Meckie-AI/meckie-bodies/bodies/comet/Comet Design Brief.dc.html

Design brief · Rev A 30 Sep 2026

# COMET-12

A compact, 3D-printable companion quadruped. Twelve Feetech serial-bus servos at 12 V, tuned for smooth, expressive motion, with wheel feet that let him skate-walk at human pace.

Est. mass

{{ totalStr }} g

{{ marginStr }}

Hip height

{{ hipH }} mm

thigh {{ thetaStr }}° from vertical

Segments

115 / 115

thigh / shin, mm

Top speed

1.4 m/s

skate-walk · knee servo {{ kneePeak }} N·m

01

## Concept views

Open full 3D viewer + GLB/OBJ export →

A torpedo body in cream PLA, seafoam fender pods over each shoulder, chrome bands hiding the shell seams, a red porthole face with a round display under twin brow lamps (camera and depth sensor), and an antenna with an orbit ring. All four legs run knees-back. Each view can be dragged to orbit.

Side

Front · face end

Top

3/4

Rear · USB-C below the tail light

Overall ≈ 360 L × 213 W × 330 H mm (to antenna) Hip spacing 223 mm Foot track 191 mm Shell Ø124 × 99 mm

02

## Leg · exploded

Front-right leg, exploded laterally

Joint

Drive side

Support side

{{ j.joint }}

{{ j.drive }}

{{ j.support }}

Knee linkage

The knee servo sits directly above the hip-pitch servo inside the bracket sleeve. An 18 mm crank drives an M3 pushrod to a 23 mm horn on the shin, a 1.28:1 reduction, so the STS3215 sees 22% less torque than the knee joint. Crank and horn are clocked at 152° so the rod meets both at about 82° when standing; across the working range (thigh ±20°, knee ±30°) the transmission angle stays above 35°. The four-bar couples thigh and knee angles; inverse kinematics compensates.

Wiring & strain relief

All three servos sit at or above the hip. The only cable below the hip is a 6-core flat cable for the wheel motor and encoder, clipped along the thigh, with a loop at the knee and strain relief at the foot cup. Each leg's chain enters its pod through a grommet on the abduction axis with a 30 mm service loop, a P-clip on the bracket, and a second clip at the chassis exit.

Lower-leg mass

Shin + horn 15 g · bumper/hub 9 g · N20 10 g · wheel 4 g · bearings 4.5 g · rod 5 g · cable 2 g
≈ 50 g below the knee

02b

## Gait modes · skate-walk

The legs always step. Above walking pace, each stance foot's wheel rolls forward while it's on the ground, so every step covers more distance at the same cadence. Body speed = leg contribution (up to ≈ 0.3 m/s) + wheel contribution. A foot about to land spins its wheel up to ground speed first, so touchdown is scuff-free.

Walk

Skate-walk · wheel share rises with speed

00.3 m/s0.71.01.4 m/s · adult walking pace

Walk0–0.3 m/s

Wheels held by the motors in position-hold, so it's a true walk. The default mode, and used on carpet, thresholds, near drop-offs, and whenever the front depth sensor sees clutter.

Skate-walk0.3–1.5 m/s

Trot cadence of about 1.4 Hz, with lower 15 mm foot lift. At 1.4 m/s, wheels supply about 80% of the speed. Wide arcs only: wheel skid plus abduction steering.

Glidepose

Legs still in a crouched "surfing" stance while he rolls. Used for short flourishes and greetings, not for getting around.

Control split

Pi: gait planner, mode blend, IK at 100 Hz, streamed to the ESP32. ESP32-S3: servo bus, wheel speed loops at 1 kHz, touchdown spin-up, drop-off and obstacle reflexes, heartbeat watchdog.

03

## Body layout

X-ray: shell and pods at 13% opacity

Bus & power topology

USB-C PD · tail → STUSB4500 + BQ25798 charger → Smart pack 3S · MAX17320 → Main switch · 10 A fuse → Power board → 5 V / 5 A buck → Pi + display

V+ front · 7.5 A

FL · ID 1 abd · 2 pitch · 3 knee→ FR · ID 4 · 5 · 6 V+ break

V+ rear · 7.5 A

RL · ID 7 · 8 · 9→ RR · ID 10 · 11 · 12

Data + GND

ESP32-S3 N16R8UART1 → Serial bus adapter→ one half-duplex line, continuous through all 12 servos

Pi peripherals

CSI · camera I²C · IMU + pack gauge + charger I²S · speaker amp + 2 mics SPI · display UART · ESP32-S3 link (joint targets 100 Hz)

ESP32 peripherals

2 × DRV8833 → 4 N20 + encoders I²C · VL53L8CX forward lidar + 4 × VL53L1X drop-off GPIO · servo eFuses 5 V rail load ≈ 1.3 A typical, 2.1 A peak

{{ b.t }}

{{ b.d }}

03b

## Wiring diagram

VBAT5 VServo busESP32 I/OPi I/OUART link

Per the shared core, the ESP32-S3 is the reflex brain: it owns the servo bus, wheels, every ranging sensor and the servo power. The Pi plans the gait and solves IK, then streams joint targets to the ESP32 at 100 Hz. The servo bus moved off the Pi so the ESP32 can still run the safety routine if the Pi stops.

04

## Joint load check

All 12 joints run STS3215 (12 V, ≈ 2.9 N·m stall). Continuous budget is taken as 0.9 N·m at the servo. Static moments are at {{ totalStr }} g with the foot under the hip and a knee moment arm of {{ armStr }} mm (115 · sin {{ thetaStr }}°); knee servo torque is divided by the 1.28:1 linkage. Hip pitch assumes the foot 30 mm off-center mid-stride; abduction uses the 43.5 mm lateral offset from axis to foot. Trot peak applies a {{ dynStr }}× dynamic factor on two-foot support, which assumes the smooth, eased gait this robot is tuned for.

Case

Knee joint

Knee servo

Hip pitch

Abduction

{{ r.c }}

{{ r.k }}

{{ r.ks }}

{{ r.h }}

{{ r.a }}

N·m · servo continuous budget ≈ 0.9 · STS3215 12 V stall ≈ 2.9 · red = over budget

05

## Parts list & mass budget

{{ c.name }} · {{ c.g }} g Bar = 1,750 g target · printed masses from the STL volumes

Part

Group

Qty

Each g

Line g

Running

{{ p.n }}

{{ p.name }}

{{ p.cat }}

{{ p.qty }}

{{ p.unit }}

{{ p.sub }}

{{ p.run }}

Total vs 1,750 g target

{{ totalStr }} g · {{ marginStr }}

Moving all 12 joints to STS3215 saves 156 g. Wheel feet and the ESP32-S3 add 89 g. That makes room for the 2200 mAh pack as standard, which wheels and the higher skate-walk speed put to use. The earlier weight trims stay in: 2-wall shell, pocketed chassis, 35% bracket infill, 26 AWG harness, nylon shell fasteners. Printed masses assume the settings in section 06.

05b

## BOM cost

Single unit · retail estimates, USD · Oct 2026

{{ c.name }} · ${{ c.sum }} · {{ c.share }}

Item

Group

Qty

Each

Line

{{ p.name }}

{{ p.cat }}

{{ p.qty }}

${{ p.unit }}

${{ p.line }}

Total · single unit

${{ costTotal }} · range {{ costRange }}

Where to save

{{ s.t }}{{ s.v }}

At 10 units

$500–550 / unit

Servo bulk pricing, a shared PCB assembly run, and filament bought by the spool.

Prices are typical single-quantity retail and have not been checked against current listings; confirm them before ordering. Excludes tools, shipping, import duties and printer time. The custom power board assumes five assembled boards from a standard PCB fab.

05c

## Assembly · no glue

Every joint snaps or screws · fully reversible with a 2.5 mm hex and a 1.5 mm hex

Joint

Method

Detail

{{ a.j }}

{{ a.m }}

{{ a.d }}

Snap features are sized for PLA: 1.2 mm cantilever thickness, 0.6 mm hook depth, 30° lead-in, 45° release face so they can be unsnapped with a fingernail or spudger. Screws into plastic always land in a heat-set insert, never a printed thread, so parts survive repeated servicing. Threadlocker is optional on metal-to-metal threads only (servo horns, grub screws); use a removable grade.

06

## Print orientation

{{ q.part }}

{{ q.mat }}

{{ q.how }}

{{ q.settings }}

07

## Safety reflex · settles into a low crouch

{{ s.t }}{{ s.h }}{{ s.d }}

Triggers

No Central heartbeat for 500 ms (relayed by the Pi) · no Pi link for 200 ms · pack below 15% or 10.5 V · any servo at 70 °C or above · eFuse fault.

Always-on local reflexes

Edge: any drop-off ToF sees the floor fall away → wheels brake and the gait stops; it steps back only on command. Obstacle: forward lidar under 150 mm → wheels brake, walk speed capped. Fall: tilt past 40° → all servos to 10% torque.

Rest pose

Low crouch: thighs 20° further back, knees folded to keep the feet under the hips, body about 50 mm lower. Holds at 25% servo torque. If power is cut it settles onto its belly.

Resume

Stands up only on a fresh command from Central. Restoring the heartbeat alone does not wake it.

08

## Hangar Bay manifest

Peripheral

Host

Bus

Addr / ID

Pins

{{ m.dev }}

{{ m.host }}

{{ m.bus }}

{{ m.addr }}

{{ m.pins }}

hangar_bay/comet.yaml

{{ yaml }}

Verify before CAD freeze

- STS3215 spline position along the 45.2 mm side is not published; measure it and shim each servo so the spline lands on its axis before closing the sleeves.
- Collision sweep of the printed parts covers abduction ±12°, thigh ±20° and knee ±30° from stance. Rear legs: thigh and knee bent the same way together beyond about 40° is unreachable for the rod; keep the gait inside that.
- Set each pushrod to length (front 149.5 mm, rear 129.2 mm centre to centre) and trim knee zero with the turnbuckle.
- Servo masses with horns removed; the 74.5 g / 55 g figures may already include the stock horn.
- Four-bar transmission angle across the full knee range; keep it above 35° at deepest crouch.
- Pod louver area against knee-servo case temperature after 10 minutes of continuous trotting.
- Charger heat in the tail at 25 W: give the BQ25798 a copper pour to the rear bulkhead, and derate to 1.5 A if the board passes 70 °C.
- USB-C PD compatibility across phone, laptop and GaN chargers, plus the 5 V fallback path.
- STS3215 12 V datasheet figures (speed, stall, continuous rating) and thermal behaviour in the knee position during long skate-walks.
- Mic noise floor while walking and skate-walking, and whether servo whine and speaker echo need a mechanical fix or software is enough.
- Wheel touchdown matching: measure the speed mismatch at foot contact, aiming for under 5% at 1.4 m/s.
- Front ToF cover window: use IR-transparent material with an air gap or gasket, and check for crosstalk against the camera lens ring.
- Drop-off ToF aim against the front-foot swing envelope, so a lifted foot never reads as a cliff.
