Meckie-AI/meckie-bodies/bodies/biped-mini/Biped Mini Design Brief.dc.html

Design brief · Rev A 2 Oct 2026 Meckie shared core

# BIPED MINI.

A small two-legged walking Meckie body. Personality: an earnest little guy who waddles, dances, and waves (kids will love it).

Est. mass

{{ totalStr }} g

limit 1,300 g

Envelope

284 H

mm · 136 W across arms · feet 92 long

Servos

{{ servoCount }}

{{ cfgShort }}

Worst knee / ankle

{{ kneeWorst }} / {{ ankleWorst }}

N·m · budget 0.9 hold, 1.47 peak

Est. BOM

${{ costTotal }}

target under $350 · see 05b

Runtime

≈ {{ runStr }} h

walking · 3S {{ packStr }} mAh

Key finding · leg joints

Without an ankle roll joint, the flat feet cannot stay flat while it shifts its weight onto one leg.

To lift a foot, the centre of mass has to move about {{ shiftNeed }} mm sideways over the other foot. With the specified joints (hip yaw, roll, pitch, knee, ankle pitch) the only ways to do that are tilting both legs about {{ tiltNeed }}°, which tips each foot onto its outer edge, or rolling the body about 35°. This brief therefore defaults to hip roll, hip pitch, knee, ankle pitch and ankle roll per leg. To keep it near 280 mm and under 1.3 kg the two roll joints use the smaller STS3032 (6 V, on its own bus) and the pitch joints keep the STS3215. The ankle roll keeps the soles flat during the waddle. Turning in place becomes a toe-heel shuffle instead of a hip twist. Switch Leg joints in Tweaks to see the as-specified version and its check results.

01

## Concept views

Open full 3D viewer + GLB/OBJ export →

A round body, cream on top and sea foam below, with a red TPU belt bumper and a chrome band. The face sits in a chrome porthole with brass rivets on the chest. A small cream helmet head carries the camera under a sea-foam brim. Short stub arms end in red TPU mitts. The legs are cream thighs and sea-foam shins with chrome-painted brackets at every joint, and red braided harness clipped down the back. The feet are wide and flat with red soles. A sea-foam tail skid behind the hips, with a red TPU shoe, is what it sits back on. Each view can be dragged to orbit.

3/4 · {{ poseLabel }}

Side · crouched stance, tail skid

Front · face, lidar, front drop ToF

Top · foot footprint

Rear · speaker grille, USB-C, brass toggle, tail skid, rear drop ToF

Thigh 58 · shin 56 · ankle axis 44 above floor · hip roll 26 above hip pitch Hip pitch axes 76 apart · feet 92 × 60 Torso 100 × 124 × 90 · head 48 × 64 Seated height ≈ 200

02

## Legs · exploded

Legs and hip brackets outward, feet down, torso halves and head apart, skid back

Joint · IDs L / R

Drive side

Support side

{{ j.joint }}

{{ j.drive }}

{{ j.support }}

Servo as structure

Every servo sits in a PLA sleeve and is shimmed so its spline lands on the joint axis, then a cap closes the sleeve. The hip bracket holds the hip-pitch servo, the thigh holds the knee servo, and the ankle bracket holds the ankle-pitch servo lying flat; the shin is two PLA plates and a tie bar. Every pitch joint is driven by a metal horn on the outboard side and carried by a 685ZZ on an M5 shoulder bolt on the inboard side; the roll joints use a 683ZZ on an M3 shoulder screw.

Feet

92 × 60 mm PLA plates with a 4 mm red TPU sole, set 12 mm toe-forward of the ankle axis. The two soles sit 16 mm apart, so the standing support area is 92 × 136 mm. A chrome toe cap protects the front edge.

Tail skid

A PLA tail skid curves down from the back of the pelvis to a red TPU shoe 88 mm below the hip-pitch axis, behind the legs. To sit it bends the hips 66°, the knees 100° and the ankles 15°; the body tips back about 19° and the shoe lands on the floor 37 mm behind the heels, so it rests on two feet and the skid. The rear drop-off ToF sits on the skid.

02b

## Behaviour modes

A static, crouched gait: the centre of mass is always over a foot, so it can stop mid-step and stay put. Slow on purpose, which reads as earnest and keeps it safe around small children.

{{ m.n }}{{ m.q }}

{{ m.d }}

Control split

Central: where to go, who is there, which dance, what to say. Pi: face render, camera and mic streams, voice bearing, speech playback. ESP32-S3: gait generator and leg IK at 100 Hz, IMU balance trim, foot-contact check from servo load, lidar and drop-off reflexes, heartbeat watchdog, power and thermal guard.

03

## Body layout

X-ray: torso, head, pods and leg covers at 13% opacity

Bus & power topology

USB-C PD · rear→ PD sink · 15 V→ BQ25798 · 3S charger↔ 3S {{ packStr }} smart pack · pelvis→ Brass toggle · 10 A fuse

VBAT 10.5–12.6 V

eFuse · EN 14 (12 V) · 6 V buck + eFuse EN 47→ Two bus adapters (UART1 12 V, UART2 6 V)→ 12 V bus: STS3215 ID 2–4 / 7–9 6 V bus (own buck + adapter, UART2): STS3032 ID 1, 5 / 6, 10 Arms ID 11–12 (upgrade)

Reflex brain

ESP32-S3 N16R8 UART1 · servo bus 1 Mbps I²C0 · BNO085, VL53L8CX, 2 × VL53L0X, BQ25798 I²C1 · pack gauge SMBus

Face brain

Pi Zero 2 W · chest CSI · camera (60 mm FFC to head) SPI0 · display I²S · 2 mics in head + amp UART · ESP32-S3 link 921 600

Leg harness

12 V · GND · bus3-wire servo chain per leg in red braid, service loop at every joint

{{ b.t }}

{{ b.d }}

03b

## Wiring diagram

VBAT / 12 V 5 V 12 V servo bus 6 V servo bus (STS3032) I²C SPI / CSI / I²S UART link Wi-Fi

04

## Joint torque & stability check

STS3215 at 12 V: about 2.94 N·m stall. Budget for holding is 0.9 N·m (about 30% of stall, the level it can sustain without overheating); budget for short dynamic moves is 1.47 N·m (50%). Robot {{ totalStr }} g. Mass above the stance knee {{ mKneeStr }} g, above the ankle {{ mAnkleStr }} g. Thigh 58 mm, shin 56 mm. The roll rows use the STS3032 budget instead: about 0.44 N·m stall at 6 V, so 0.13 N·m hold and 0.22 N·m peak. Dynamic rows add 30% for acceleration and gear backlash.

Case

Joint

Need

Budget

Result

{{ r.c }}

{{ r.j }}

{{ r.t }}

{{ r.b }}

{{ r.p }}

Stability & sensing

Need

Have

Result

{{ r.c }}

{{ r.need }}

{{ r.have }}

{{ r.res }}

Knee and ankle pitch are the critical joints. The worst knee case is rising from the skid with the knees at 100°; the worst ankle case is single support with the centre of mass pushed 30 mm toward the toe. Both stay inside the 1.47 N·m dynamic budget at the planned mass, and every holding case stays under 0.9 N·m. Tinted rows are knee and ankle pitch.

05

## Parts list & mass budget

{{ c.name }} · {{ c.g }} g Bar = {{ totalStr }} g of 1,300 g

Part

Group

Qty

Each g

Line g

Running

{{ p.n }}

{{ p.name }}

{{ p.cat }}

{{ p.qty }}

{{ p.unit }}

{{ p.sub }}

{{ p.run }}

Total

{{ totalStr }} g · {{ massNote }}

The ten leg servos are 46% of the robot. The arm upgrade adds two more servos and pushes it to about 1.33 kg, past the 1.3 kg limit, unless the covers are thinned; the 1500 mAh pack alone still fits.

05b

## BOM cost

Single unit · retail estimates, USD · Oct 2026

Over target. The spec build comes to ${{ costTotal }} against $350. The six STS3215s are ${{ servoCost }} and the four STS3032s about $88. The savings list gets to about ${{ liteTotal }}, still over target; the STS3032 roll servos and their 6 V bus are the price of staying near 280 mm and under 1.3 kg.

{{ c.name }} · ${{ c.sum }} · {{ c.share }}

Item

Group

Qty

Each

Line

Running

{{ p.name }}

{{ p.cat }}

{{ p.qty }}

${{ p.unit }}

${{ p.line }}

${{ p.run }}

Total · single unit

${{ costTotal }} · range {{ costRange }}

Where to save

{{ s.t }}{{ s.v }}

All of the above≈ ${{ liteTotal }}

Prices are typical single-quantity retail and have not been checked against current listings; confirm them before ordering. Excludes the USB-C PD charger, tools, shipping and printer time.

05c

## Assembly · no glue

Every joint screws or snaps · fully reversible with a 2.5 mm and a 2 mm hex

Joint

Method

Detail

{{ a.j }}

{{ a.m }}

{{ a.d }}

No glue, tape, epoxy or adhesive cable mounts anywhere. Bearings sit in seats retained by shoulder bolts. Screws into plastic always land in a heat-set insert. No visible fastener heads: horn screws hide under chrome horn caps, idler bolts under brass caps, shell screws under the belt bumper and inside the pack bay.

06

## Print orientation

{{ q.part }}

{{ q.mat }}

{{ q.how }}

{{ q.settings }}

Every part fits a 220 × 220 bed; the largest are the two torso halves (116 mm across). No painting or finishing anywhere: the silver and brass parts print in metallic-filled PLA. A full set prints on three plates: PLA brackets, PLA shells and covers, TPU soles and bumpers.

06b

## Why these materials

Two filaments, and one of them only where flex is the point. The constraint that decided this was not strength: it was that a stock printer with no modifications should be able to make every rigid part on this body. PLA needs no hardened nozzle, no dry box, no enclosure and no 260 °C hotend, which is the difference between a pack most people can print and a pack most people can only read.

PLA

89% of the printed pieces

Everything rigid: shells, structure, brackets, bezels. Stiff, dimensionally accurate, prints unsupported on more surfaces than anything else, and stocked in every colour this body names.

TPU 95A

11% of the printed pieces

Only where compliance is the function and a rigid part would not work at all: belt bumper, mitt, skid shoe, sole. Nothing here is TPU for toughness alone.

What PLA costs you

Snap hooks are the weak point. The snap features on this body were drawn to stay under 2.5% strain, which suits PETG. PLA's safe cantilever strain is nearer 1.5%, so the hooks are working harder than the geometry assumed. Print them with the layer lines running across the hook rather than along it, open the shell gently, and treat a hook as a part you may have to reprint. Nothing in this pack has been test-printed, so this is the first place to look for trouble and the most useful thing you can report back.

Heat. PLA's glass transition is about 55 to 60 °C, and this body's servos do not warn until 65 °C. Indoors that gap never opens: the shell sits near room temperature and the servos are the only thing that gets hot. Left in a closed car in summer, or on a sill in direct sun, the shell can soften while the electronics still consider themselves fine. That is a storage rule, not a design flaw, and it is the main thing PETG would buy back.

Heat-set inserts. Every screw lands in a brass insert, and PLA's window is narrower than PETG's: run the iron cooler, around 180 to 200 °C, go in slowly, and let the boss cool before loading it. Rushing one slumps the wall around it.

If you want the margin back: the geometry does not change. Print the shells in PETG and the load-bearing structure in CF-nylon and every part still fits, because that was the original specification and the only thing that changed is which spool is on the shelf. The cost is a hardened nozzle, a dry box, and a printer that holds 260 °C. If you have that printer, the tougher parts are yours for a filament swap.

07

## Safety reflex · crouches and sits on the tail skid

{{ s.t }} {{ s.h }} {{ s.d }}

Triggers

No Central heartbeat for 500 ms · pack below 15% or 10.5 V · any servo at 70 °C or above · eFuse fault · servo load spike on a non-stance leg (something caught).

Always-on local reflexes

Edge: a drop ToF sees the floor fall away → finish the step backward and stop. Obstacle: lidar under 120 mm ahead → stop. Fall: torso tilt past 35° outside the gait envelope → all servos to 10% torque so the gears survive the landing.

Rest pose

Hips 66°, knees 100°, ankles 15°, body tipped back about 19°, sitting on two feet and the tail skid. Stable with servos at 20% torque or fully off.

Resume

Stands up only on a fresh command from Central. Restoring the heartbeat alone does not wake it.

08

## Hangar Bay manifest

Peripheral

Host

Bus

Addr / ID

Pins

{{ m.dev }}

{{ m.host }}

{{ m.bus }}

{{ m.addr }}

{{ m.pins }}

hangar_bay/biped_mini.yaml

{{ yaml }}

Verify before CAD freeze

- Sign off the leg joints: ankle roll instead of hip yaw (recommended), or keep hip yaw and accept tilted feet, or go to 12 servos (+$40, about +130 g, over 1.3 kg).
- STS3032 spline position along its 23.2 mm side is not published; every STS3032 pocket has 3 mm of shim room. Measure and shim before final assembly.
- Roll torque margins are thin: the STS3032 ankle roll runs at about 55% of its short-term budget in single support. Keep the CoM within 8 mm of the stance foot centre line in the gait planner.
- Collision sweep of the printed parts: hip roll ±12°, hip pitch −90° to +15°, knee 0–120°, ankle pitch ±20° (±30° once the knee is bent past 40°), ankle roll ±12°. Back-swing is limited to 15° by the tail skid.
- Toe-heel shuffle turning on carpet and wood; measure degrees per step.
- STS3215 backlash at the ankle (about 0.5°) magnified over the 114 mm leg; check the stance foot stays planted and does not chatter.
- Thermal: knees and ankles during a 10 min dance at 12 V. Trip is 70 °C.
- Sit-to-stand from the skid on a slippery floor: the feet must not skate forward as the knees extend.
- Drop-off ToFs move with the torso pitch during the gait; correct from the IMU and test at stair tops.
- Camera FFC from chest to head is short and fixed, but route it clear of the arm-upgrade servos.
- Kid safety: pinch points behind the knees at full fold. Add TPU knee guards or limit the fold when a child is detected nearby.
