Meckie-AI/meckie-bodies/bodies/dial/Dial Design Brief.dc.html

Design brief · Rev B · portable TV 2 Oct 2026 Meckie shared core

# DIAL.

A shelf- or desk-mounted Meckie body with a pan/tilt head and no locomotion. Personality: a little 1950s portable TV who turns to look at whoever is talking.

Est. mass

{{ totalStr }} g

{{ discStr }} mm steel ballast

Envelope

170 × 146 × 205

mm W × D × H · tilt axis at 130

Axes

2 × STS3215

pan ±150° · tilt −30 / +40°

Push to tip

{{ tipStr }} N

at screen top · BOM ${{ costTotal }}

01

## Concept views

Open full 3D viewer + GLB/OBJ export →

The head is a 1950s portable television. A cream two-piece cabinet with a chrome seam band and a tapered tube-bell back carries a rectangular 2.8" IPS screen in a chrome surround, set off-centre. The eyes are drawn on the screen. A sea-foam knob column on the right holds two brass knobs and the speaker slots; a chrome carry handle finishes the top, with the camera in a chrome pod above the screen. The cabinet tilts in a brushed-aluminium-finish yoke on a two-tier sea-foam and cream swivel base with a red TPU foot. The neck harness runs up the back of the yoke in red braid. Each view can be dragged to orbit.

3/4 · {{ poseLabel }}

Side · tube-bell back, battery hatch on right flank

Front · ToF behind red bezel

Top

Rear · vents, USB-C, brass main toggle, harness

Overall 170 W × 146 D × 205 H mm (to handle) Cabinet 140 W × 100 H × 76 D, + 24 tube bell Screen 2.8" · surround 74 × 58, centre 16 mm right of axis Swivel base Ø146 × 48 Shelf-clamp variant fits 12–30 mm shelves

02

## Pan/tilt neck · exploded

Full stack, exploded vertically; head shells split fore/aft

Joint

Drive side

Support side

{{ j.joint }}

{{ j.drive }}

{{ j.support }}

Servo placement

The pan servo stands upright at the pedestal centre and only supplies rotation; the 6810 bearing under the turntable carries all tipping load. The tilt servo rides inside the cabinet behind the knob column, output spline on the tilt axis, bolted through a metal horn to the left yoke arm. The cabinet pivots about its own servo, so the yoke stays a thin, clean U. The screen sits right of centre, so the CoM is about 6 mm toward the right arm; that loads the 685ZZ side slightly more but adds nothing to tilt torque.

Harness & strain relief

Six conductors leave the electronics tray, wind 1.25 turns around a printed cable clock screwed under the turntable, around the pan horn,, rise through the 6810 bore and exit at the rear of the turntable. From there the braid runs exposed up the back of the yoke in two brass P-clips and enters the head through a rear grommet with a 20 mm drip loop for tilt. Pan is soft-limited to ±150° so the clock never winds tight.

Head mass on the tilt axis

Cabinet shells, bell + band 89 g · screen surround 6 g · chassis 24 g · tilt servo 55 g · Pi 14 g · 2.8" LCD, camera, mics 25 g · Ø40 speaker + amp 14 g · knobs, panel, handle 18 g · wiring + fasteners 12 g
≈ {{ headMass }} g, CoM placed on the axis

02b

## Gaze modes · look-at

Dial turns toward whoever is talking. The two mics give a coarse bearing to the voice, the pan servo swings the head there, then the camera takes over and centres the face. Eyes lead the motion on the display by about 120 ms, so the glance reads as intent instead of a mechanical swivel.

Doze

Conversation · face tracking

Look up

−30° tilt−20°0°+25°+40°

Attentivetilt 0°

Default idle. Slow scanning saccades every 4–8 s within ±40° pan; small head bobs on speech onsets. The ToF keeps watch for someone approaching.

Curioustilt +15°

Chin up toward a standing speaker, with a fast glance: up to 400°/s pan for the first 60% of the move, then eased in so the camera settles before tracking.

Sleepy resttilt −25°

Chin tucked, eyes half closed, torque at 20%. Used for the safety reflex, night mode and charging. Leaves only on a fresh command from Central.

Control split

Central: who is talking, attention, behaviour. Pi: face render, voice bearing, face centring at 30 Hz. ESP32-S3: servo trajectories at 200 Hz, limits, heartbeat watchdog, power and thermal guard.

03

## Body layout

X-ray: shells and pedestal at 13% opacity

Bus & power topology

USB-C PD · rear→ PD sink 15 V + BQ25798→ Smart pack 3S 1500 · gauge→ Brass main toggle · 10 A fuse→ 5 V / 5 A buck → ESP32, Pi, amp, display

12 V servo · 3 A

eFuse · EN GPIO12→ Bus adapter→ ID 1 pan→ neck harness → ID 2 tilt

Reflex brain

ESP32-S3 N16R8 UART1 · servo bus 1 Mbps I²C · ToF + charger · SMBus · pack gauge Wi-Fi · Central heartbeat 10 Hz

Face brain · head

Pi Zero 2 W SPI · display CSI · camera I²S · 2 mics + amp UART · ESP32-S3 link 921 600 5 V rail ≈ 0.9 A typical, 1.6 A peak

Neck harness

12 V · GND · bus data · 5 V · TX · RX22 AWG power, 28 AWG signal, JST-GH 6p at the head

{{ b.t }}

{{ b.d }}

03b

## Wiring diagram

12 V / VBAT 5 V Servo bus I²C / SMBus I²S UART / GPIO Wi-Fi

04

## Joint load & stability check

Both joints run STS3215 (12 V, ≈ 2.9 N·m stall), with the continuous budget taken as 0.9 N·m. Head mass is {{ headMass }} g with its CoM {{ comStr }} mm off the tilt axis. Tilt inertia uses the 100 × 100 mm cabinet section; pan uses 100 × 140 plus the yoke. Fast glance is 15 rad/s² (≈ 860°/s²). Tipping assumes a horizontal push at screen-top height (160 mm) about the foot edge (r 73 mm).

Case

Joint

Servo N·m

Budget used

{{ r.c }}

{{ r.j }}

{{ r.t }}

{{ r.p }}

Push to tip at screen top

{{ tipStr }} N · {{ totalStr }} g total · {{ tipNote }}

Torque is not the constraint on this body: both servos run far inside budget, which keeps them quiet and cool on a desk. Stability is. The steel disc sets how hard a hand or cat can bump the head before Dial tips; the shelf-clamp variant removes the question. Torque rows in red would exceed the 0.9 N·m budget.

05

## Parts list & mass budget

{{ c.name }} · {{ c.g }} g Bar = {{ totalStr }} g total

Part

Group

Qty

Each g

Line g

Running

{{ p.n }}

{{ p.name }}

{{ p.cat }}

{{ p.qty }}

{{ p.unit }}

{{ p.sub }}

{{ p.run }}

Total

{{ totalStr }} g

Ballast is about a third of the mass on purpose: the Ø130 disc sits 6–10 mm off the desk under the battery and tray, keeping the CoM low under a cabinet that is wider than the base. Keeping the Pi in the cabinet adds 14 g to the tilt axis but removes the camera ribbon and SPI run from the neck. The pack is 1500 mAh because Dial lives on USB-C; the pack rides through unplugging and moving rooms. Printed masses assume the settings in section 06.

05b

## BOM cost

Single unit · retail estimates, USD · Oct 2026

{{ c.name }} · ${{ c.sum }} · {{ c.share }}

Item

Group

Qty

Each

Line

Running

{{ p.name }}

{{ p.cat }}

{{ p.qty }}

${{ p.unit }}

${{ p.line }}

${{ p.run }}

Total · single unit

${{ costTotal }} · range {{ costRange }}

Where to save

{{ s.t }}{{ s.v }}

Prices are typical single-quantity retail and have not been checked against current listings; confirm them before ordering. Excludes tools, shipping, import duties and printer time. Shelf-clamp rows appear only when the clamp variant is switched on.

05c

## Assembly · no glue

Every joint snaps or screws · fully reversible with a 2.5 mm and a 2 mm hex

Joint

Method

Detail

{{ a.j }}

{{ a.m }}

{{ a.d }}

Snap features are sized for PLA: 1.2 mm cantilever thickness, 0.6 mm hook depth, 30° lead-in, 45° release face so they can be unsnapped with a spudger. Screws into plastic always land in a heat-set insert, never a printed thread. No visible fastener heads: every screw sits under the knob panel, the handle bosses, the seam band, the TPU foot or inside the battery bay. Threadlocker is optional on metal-to-metal threads only (servo horns, shoulder bolt); use a removable grade.

06

## Print orientation

{{ q.part }}

{{ q.mat }}

{{ q.how }}

{{ q.settings }}

All parts fit a 220 × 220 bed; the Ø144 base pan and the 152 × 112 cabinet front shell are the largest. No painting or finishing anywhere: the silver and brass parts print in metallic-filled PLA.

06b

## Why these materials

Two filaments, and one of them only where flex is the point. The constraint that decided this was not strength: it was that a stock printer with no modifications should be able to make every rigid part on this body. PLA needs no hardened nozzle, no dry box, no enclosure and no 260 °C hotend, which is the difference between a pack most people can print and a pack most people can only read.

PLA

89% of the printed pieces

Everything rigid: shells, structure, brackets, bezels. Stiff, dimensionally accurate, prints unsupported on more surfaces than anything else, and stocked in every colour this body names.

TPU 95A

11% of the printed pieces

Only where compliance is the function and a rigid part would not work at all: battery strap, foot, lcd retainer (clamps the module), neck harness grommet. Nothing here is TPU for toughness alone.

What PLA costs you

Snap hooks are the weak point. The snap features on this body were drawn to stay under 2.5% strain, which suits PETG. PLA's safe cantilever strain is nearer 1.5%, so the hooks are working harder than the geometry assumed. Print them with the layer lines running across the hook rather than along it, open the shell gently, and treat a hook as a part you may have to reprint. Nothing in this pack has been test-printed, so this is the first place to look for trouble and the most useful thing you can report back.

Heat. PLA's glass transition is about 55 to 60 °C, and this body's servos do not warn until 65 °C. Indoors that gap never opens: the shell sits near room temperature and the servos are the only thing that gets hot. Left in a closed car in summer, or on a sill in direct sun, the shell can soften while the electronics still consider themselves fine. That is a storage rule, not a design flaw, and it is the main thing PETG would buy back.

Heat-set inserts. Every screw lands in a brass insert, and PLA's window is narrower than PETG's: run the iron cooler, around 180 to 200 °C, go in slowly, and let the boss cool before loading it. Rushing one slumps the wall around it.

If you want the margin back: the geometry does not change. Print the shells in PETG and the load-bearing structure in CF-nylon and every part still fits, because that was the original specification and the only thing that changed is which spool is on the shelf. The cost is a hardened nozzle, a dry box, and a printer that holds 260 °C. If you have that printer, the tougher parts are yours for a filament swap.

07

## Safety reflex · the TV dozes off

{{ s.t }} {{ s.h }} {{ s.d }}

Triggers

No Central heartbeat for 500 ms · pack below 15% SoC or 10.5 V · any servo at 70 °C or above · eFuse fault.

Rest pose

Pan 0°, tilt −25°. With torque at 20% the head settles chin-down against the printed −30° soft stop, so it cannot drop further.

Resume

Stands back up only on a fresh command from Central. Restoring the heartbeat alone does not wake it.

08

## Hangar Bay manifest

Peripheral

Host

Bus

Addr / ID

Pins

{{ m.dev }}

{{ m.host }}

{{ m.bus }}

{{ m.addr }}

{{ m.pins }}

hangar_bay/dial.yaml

body: dial
doctrine: thin-client
central: { link: wifi, heartbeat_hz: 10, timeout_ms: 500 }
mcu:
  reflex: { chip: esp32s3, module: N16R8, reserved_gpio: [26-37] }
  face:   { chip: rpi_zero_2w, os: bookworm-lite, location: head }
buses:
  servo_bus: { host: reflex, uart: 1, tx: 17, rx: 18, baud: 1000000, half_duplex: true }
  i2c0:      { host: reflex, sda: 8,  scl: 9,  hz: 400000 }
  i2c1_smb:  { host: reflex, sda: 10, scl: 11, hz: 100000 }
  link:      { reflex: { uart: 2, tx: 15, rx: 16 }, face: { uart: 0, tx: 14, rx: 15 }, baud: 921600 }
  spi0:      { host: face, mosi: 10, sclk: 11, cs: 8, hz: 62500000 }
  i2s:       { host: face, bclk: 18, lrclk: 19, din: 20, dout: 21, rate: 48000 }
  csi:       { host: face, port: cam0 }
servos:
  - { id: 1, name: pan,  model: sts3215, center: 2048, min: 341,  max: 3755, rest: 2048 }
  - { id: 2, name: tilt, model: sts3215, center: 2048, min: 1707, max: 2503, rest: 1764 }
servo_limits: { temp_warn_c: 65, temp_trip_c: 70, rest_torque_pct: 20, slow_dps: 30 }
peripherals:
  - { name: tof_front,  part: vl53l8cx,  bus: i2c0, addr: 0x29, lpn: 4, int: 5 }
  - { name: charger,    part: bq25798,   bus: i2c0, addr: 0x6B, int: 6, ce: 7 }
  - { name: gauge,      part: sbs_pack,  bus: i2c1_smb, addr: 0x0B }
  - { name: servo_pwr,  part: efuse,     en: 12, fault: 13 }
  - { name: face_wake,  gpio: 14, to: face.gpio3 }
  - { name: status_led, part: ws2812,    gpio: 48 }
  - { name: display,    part: st7789v,   bus: spi0, dc: 25, rst: 24, bl_pwm: 13, size: 320x240, rotation: 90 }
  - { name: mics,       part: ics43434,  bus: i2s, count: 2, sel: [gnd, 3v3], spacing_mm: 92 }
  - { name: speaker_amp, part: max98357a, bus: i2s, sd: 16 }
  - { name: camera,     part: imx708,    bus: csi }
safety:
  triggers: [heartbeat_lost, soc_below_15, vbat_below_10v5, servo_overtemp, efuse_fault]
  routine:  [stop, brake, wait_2s, slow_to_rest, torque_low, face_sleepy]
  resume:   fresh_command_only

Verify before CAD freeze

- STS3215 body and spline position against the Feetech drawing; the tilt spline must land on the head's CoM within ±3 mm.
- 6810 bearing fit in a PLA seat versus a PLA insert ring; check for creep after a week of continuous scanning.
- Cable clock fatigue: 50,000 cycles of ±150° pan on the 6-core harness and the 28 AWG signal pairs.
- Pack fit: 3S 1500 in the right-flank bay with the hatch closed; measure the actual cell block before printing the base pan.
- Pi Zero 2 W temperature inside the sealed head while streaming camera and mics; vent area may need to grow.
- Mic noise from the tilt servo and Ø40 speaker inside the cabinet; add a printed TPU gasket under the mic clamp plates if needed.
- Voice-bearing accuracy with 92 mm mic spacing (asymmetric about the pan axis; calibrate the offset); target ±15° so the pan move lands close enough for face tracking.
- ToF window: IR-transparent material with an air gap, and its view clear of the yoke at extreme pan.
- USB-C PD compatibility across phone, laptop and GaN chargers, plus the 5 V fallback path.
- Shelf clamp grip on painted and laminate shelves at a 10 N push at screen-top height.
- 2.8" LCD viewing angle when Dial looks down at a seated user; IPS needed, not TN. Check backlight bleed at the surround edges.
- Cabinet tilt clearance: bottom edge sweeps to 14.5 mm above the yoke base at −30° and +40°; confirm with the real servo horn stack.
