Meckie-AI/meckie-bodies/bodies/inchworm/Inchworm Design Brief.dc.html

Design brief · Rev A 2 Oct 2026 Meckie shared core

# INCHWORM.

A desk-mounted serpentine arm creature. Personality: a weird, endearing curious critter that curls up, stretches, and peeks at you.

Est. mass

{{ totalStr }} g

arm {{ armStr }} g · head {{ headStr }} g

Reach

300 mm

J1 axis → face · base Ø184

J1 / J2 at full reach

{{ t1Str }} / {{ t2Str }}

N·m holding · budget 0.9

Tip margin

{{ marginStr }} mm

fully extended · {{ discStr }} mm steel disc

Est. BOM

${{ costTotal }}

target ≈ $200 · see 05b

Power

USB-C PD

15 V · 45 W wall charger · no battery

01

## Concept views

Open full 3D viewer + GLB/OBJ export →

A retro space caterpillar on a low cream dome. Four plump oval segments alternate sea foam and cream, each with two translucent ribs that glow from LEDs inside, a pair of red TPU prolegs on the belly, and chrome joint rings between them. The red braided harness runs up the back of every segment under brass clips. The head is wider than the body, like a caterpillar's: a cream dome with a sea-foam band, the face in a chrome bezel with a red TPU ring, a small chrome camera hood above it, and two antennae with glowing tips. A glow ring circles the top of the base. Each view can be dragged to orbit.

3/4 · {{ poseLabel }}

Side · spine harness

Front · face, antennae, chin lidar, grille

Top

Rear · USB-C, brass toggle, braided spine run

Links 70 · 65 · 60 · 60 · head 45 Segments 48 × 54 oval, chrome-painted joint brackets Head 60 × 62 · J1 axis 78 above desk Resting height ≈ 115 · peeking ≈ 370

02

## Joint chain · exploded

Joints spaced along the chain, shells lifted off, base parts down

Joint · ID

Drive side

Support side

{{ j.joint }}

{{ j.drive }}

{{ j.support }}

Alternating axes

J1, J3 and J5 bend in one plane; J2 and J4 bend at right angles to it. Together they let the body curve in any direction, tilt its head sideways and bow down to rest. There is no base turntable, so turning to face you is done by bending the two side joints.

Light at the tip

The head carries only a XIAO ESP32-S3 Sense (camera, face, two mics), the round display and a tiny forward lidar: about {{ headStr }} g. Everything heavy that does not have to move lives in the base, and the J1 servo sits inside the base rather than on the arm.

Spine harness

Seven conductors run the whole length in red braid on the back of each segment: 12 V, GND and servo data for the bus, 5 V, TX and RX for the head, and one data line for the glow LEDs. Each joint has a service loop on the outside of the bend, under a brass clip.

02b

## Behaviour modes

{{ m.n }}{{ m.q }}

{{ m.d }}

Control split

Central: who is there, where to look, behaviour, speech. XIAO (head): camera and mic streams over Wi-Fi, face render, chin lidar. Pi Zero 2 W (base): speech and sound playback, longer motion clips. ESP32-S3 (base): 5-joint IK and trajectories at 100 Hz, joint limits and self-collision, contact detection from servo load, heartbeat watchdog, power guard.

03

## Body layout

X-ray: base, segments and head at 13% opacity

Bus & power topology

USB-C PD · rear · 45 W charger→ PD sink · 15 V→ Brass toggle · 5 A fuse→ 12 V / 5 A buck · servos 5 V / 5 A buck · logic, head, glow LEDs

12 V servo bus

eFuse · EN 14→ Bus adapter→ J1 (base)→ spine → J2 → J3 → J4 → J5

Reflex brain · base

ESP32-S3 N16R8 UART1 · servo bus 1 Mbps UART2 · head link via spine UART0 · Pi link ADC · VIN sense RMT GPIO38 · 66 glow LEDs

Audio · base

Pi Zero 2 W I²S → MAX98357A → Ø28 speaker

Head brain · tip

XIAO ESP32-S3 Sense Onboard camera · Wi-Fi to Central SPI · GC9A01 I²S · 2 mics I²C · VL53L1X chin lidar

Spine harness

12 V · GND · bus · 5 V · TX · RX · LED7c silicone, 24/28 AWG, red braid on the back of every segment

{{ b.t }}

{{ b.d }}

03b

## Wiring diagram

15 V / 12 V 5 V Servo bus I²S / SPI / I²C Head UART Pi UART Wi-Fi

04

## Joint torque & tip check

Full extension means the whole chain held straight and horizontal, 300 mm out. Each moving servo module (STS3215, metal horn, bearing) is {{ msStr }} g at its joint; each segment shell, bracket and harness run is {{ mlStr }} g at mid-link; the head is {{ headStr }} g with its centre 28 mm past J5. STS3215 at 12 V: about 2.94 N·m stall. Holding budget 0.9 N·m, short dynamic budget 1.47 N·m. Dynamic rows add a 6 rad/s² dart, the speed of a quick peek.

Case

Joint

Need

Budget

Result

{{ r.c }}

{{ r.j }}

{{ r.t }}

{{ r.b }}

{{ r.p }}

Tip check · full reach

CoM {{ comXStr }} mm out · base edge 90 mm · margin {{ marginStr }} mm · holds {{ payloadStr }} g extra at the face before tipping

J1 is the critical joint: holding the chain straight out uses about {{ t1PctStr }} of its holding budget, so it can do it for a peek but should not idle there. Behaviours keep the default stance in an S-curve, which drops J1 to about {{ tPeekStr }} N·m. J2 is worst when its bend plane is vertical, which only happens when J1 is upright and J2 lays the arm out sideways. Tinted rows are J1 and J2.

05

## Parts list & mass budget

{{ c.name }} · {{ c.g }} g Bar = {{ totalStr }} g total

Part

Group

Qty

Each g

Line g

Running

{{ p.n }}

{{ p.name }}

{{ p.cat }}

{{ p.qty }}

{{ p.unit }}

{{ p.sub }}

{{ p.run }}

Total

{{ totalStr }} g

The steel disc is over half the robot: a 300 mm arm needs a heavy base. Every gram at the head costs about 3.3 g of ballast to keep the same tip margin, which is why the head carries only the parts that have to look and listen.

05b

## BOM cost

Single unit · retail estimates, USD · Oct 2026

{{ costHead }} {{ costBody }}

{{ c.name }} · ${{ c.sum }} · {{ c.share }}

Item

Group

Qty

Each

Line

Running

{{ p.name }}

{{ p.cat }}

{{ p.qty }}

${{ p.unit }}

${{ p.line }}

${{ p.run }}

Total · single unit

${{ costTotal }} · range {{ costRange }}

Where to save

{{ s.t }}{{ s.v }}

All of the above≈ ${{ liteTotal }}

Prices are typical single-quantity retail and have not been checked against current listings; confirm them before ordering. Excludes the USB-C charger, tools, shipping and printer time.

05c

## Assembly · no glue

Every joint screws or snaps · fully reversible with a 2.5 mm and a 2 mm hex

Joint

Method

Detail

{{ a.j }}

{{ a.m }}

{{ a.d }}

No glue, tape, epoxy or adhesive cable mounts anywhere. Bearings sit in seats retained by shoulder bolts. Screws into plastic always land in a heat-set insert. No visible fastener heads: horn screws hide under chrome caps, idler bolts under brass caps, shell screws inside the segments and under the TPU foot.

06

## Print orientation

{{ q.part }}

{{ q.mat }}

{{ q.how }}

{{ q.settings }}

Every part fits a 220 × 220 bed; the Ø184 base dome is the largest. No painting or finishing anywhere: the silver and brass parts print in metallic-filled PLA.

06b

## Why these materials

Two filaments, and one of them only where flex is the point. The constraint that decided this was not strength: it was that a stock printer with no modifications should be able to make every rigid part on this body. PLA needs no hardened nozzle, no dry box, no enclosure and no 260 °C hotend, which is the difference between a pack most people can print and a pack most people can only read.

PLA

82% of the printed pieces

Everything rigid: shells, structure, brackets, bezels. Stiff, dimensionally accurate, prints unsupported on more surfaces than anything else, and stocked in every colour this body names.

TPU 95A

18% of the printed pieces

Only where compliance is the function and a rigid part would not work at all: foot, proleg nub. Nothing here is TPU for toughness alone.

What PLA costs you

Snap hooks are the weak point. The snap features on this body were drawn to stay under 2.5% strain, which suits PETG. PLA's safe cantilever strain is nearer 1.5%, so the hooks are working harder than the geometry assumed. Print them with the layer lines running across the hook rather than along it, open the shell gently, and treat a hook as a part you may have to reprint. Nothing in this pack has been test-printed, so this is the first place to look for trouble and the most useful thing you can report back.

Heat. PLA's glass transition is about 55 to 60 °C, and this body's servos do not warn until 65 °C. Indoors that gap never opens: the shell sits near room temperature and the servos are the only thing that gets hot. Left in a closed car in summer, or on a sill in direct sun, the shell can soften while the electronics still consider themselves fine. That is a storage rule, not a design flaw, and it is the main thing PETG would buy back.

Heat-set inserts. Every screw lands in a brass insert, and PLA's window is narrower than PETG's: run the iron cooler, around 180 to 200 °C, go in slowly, and let the boss cool before loading it. Rushing one slumps the wall around it.

If you want the margin back: the geometry does not change. Print the shells in PETG and the load-bearing structure in CF-nylon and every part still fits, because that was the original specification and the only thing that changed is which spool is on the shelf. The cost is a hardened nozzle, a dry box, and a printer that holds 260 °C. If you have that printer, the tougher parts are yours for a filament swap.

07

## Safety reflex · bows down to rest

{{ s.t }} {{ s.h }} {{ s.d }}

Triggers

No Central heartbeat for 500 ms · any servo at 70 °C or above · input below 13 V (charger sagging or unplugged) · eFuse fault · contact: servo load spike or position error over 6°.

Always-on local reflexes

Chin lidar under 60 mm (a face or hand right there) → stop and back off 20 mm. Contact → stop and drop to 30% torque so it yields when touched.

Rest pose

J1 85°, J2 0°, J3 −35°, J4 0°, J5 −30°: it bows forward off the dome and rests its chin on the desk, about 115 mm high. Found by a collision check of the printed parts; stable with torque off.

Power loss

No battery by design. If the plug is pulled while it is stretched out, the chain sags under its own weight onto the desk; prolegs, ribs and the face ring are TPU-padded. Behaviours keep it in low S-curves most of the time.

08

## Hangar Bay manifest

Peripheral

Host

Bus

Addr / ID

Pins

{{ m.dev }}

{{ m.host }}

{{ m.bus }}

{{ m.addr }}

{{ m.pins }}

hangar_bay/inchworm.yaml

body: inchworm
doctrine: thin-client
central: { link: wifi, heartbeat_hz: 10, timeout_ms: 500 }
mcu:
  reflex: { chip: esp32s3, module: N16R8, location: base, role: [ik, servo_bus, power, safety] }
  audio:  { chip: rpi_zero_2w, os: bookworm-lite, location: base, role: [speech, motion_clips] }
  head:   { chip: esp32s3, module: xiao_esp32s3_sense, location: head, role: [camera, face, mics, lidar] }
power:  { source: usb_c_pd, request_v: 15, min_v: 13.0, battery: none }
links:
  head: { reflex: { uart: 2, tx: 15, rx: 16 }, head: { tx: 43, rx: 44 }, baud: 921600, via: spine_harness }
  pi:   { reflex: { uart: 0, tx: 43, rx: 44 }, pi: { uart: 0, tx: 14, rx: 15 }, baud: 921600 }
buses:
  servo_bus: { host: reflex, uart: 1, tx: 17, rx: 18, baud: 1000000, half_duplex: true }
  head_spi:  { host: head, sclk: 7, mosi: 9, hz: 40000000 }
  head_i2s:  { host: head, bclk: 3, ws: 4, din: 5, rate: 16000 }
  head_i2c:  { host: head, sda: 6, scl: 2, hz: 400000 }
  pi_i2s:    { host: audio, bclk: 18, lrclk: 19, dout: 21, rate: 48000 }
kinematics:
  chain: [ { id: 1, axis: pitch, link_mm: 70 }, { id: 2, axis: yaw, link_mm: 65 }, { id: 3, axis: pitch, link_mm: 60 },
           { id: 4, axis: yaw, link_mm: 60 }, { id: 5, axis: pitch, link_mm: 45 } ]
  base_h_mm: 78
  ik_hz: 100
servos:
  - { id: 1, name: j1_pitch, model: sts3215, min_deg: -45, max_deg: 90, rest_deg: 85 }
  - { id: 2, name: j2_yaw,   model: sts3215, min_deg: -85, max_deg: 30, rest_deg: 0 }
  - { id: 3, name: j3_pitch, model: sts3215, min_deg: -85, max_deg: 35, rest_deg: -35 }
  - { id: 4, name: j4_yaw,   model: sts3215, min_deg: -80, max_deg: 30, rest_deg: 0 }
  - { id: 5, name: j5_pitch, model: sts3215, min_deg: -85, max_deg: 30, rest_deg: -30 }
servo_limits: { temp_warn_c: 65, temp_trip_c: 70, rest_torque_pct: 20, contact_torque_pct: 30, contact_err_deg: 6, j1_hold_max_s: 20 }
peripherals:
  - { name: servo_pwr,  part: efuse, en: 14, fault: 21 }
  - { name: pd_good,    gpio: 6 }
  - { name: vin_sense,  adc_gpio: 1, divider: 100k_10k }
  - { name: status_led, part: ws2812, gpio: 48 }
  - { name: glow,       part: sk6812_2020, gpio: 38, count: 66, map: { seg1: 0-11, seg2: 12-23, seg3: 24-35, seg4: 36-47, antennae: 48-49, base_ring: 50-65 }, max_brightness_pct: 40 }
  - { name: display,    part: gc9a01, host: head, bus: head_spi, dc: 8, rst: 1, bl: tied_on, cs: tied_low, size: 240x240 }
  - { name: mics,       part: ics43434, host: head, bus: head_i2s, count: 2, sel: [gnd, 3v3] }
  - { name: lidar_fwd,  part: vl53l1x, host: head, bus: head_i2c, addr: 0x29, location: chin }
  - { name: camera,     part: ov3660, host: head, bus: onboard_dvp, stream: mjpeg_wifi, res: 800x600, fps: 15 }
  - { name: speaker_amp, part: max98357a, host: audio, bus: pi_i2s, sd: 16 }
sensing_rule: { drives: false, forward_lidar: lidar_fwd, drop_off: not_applicable_fixed_base }
reflexes:
  near:    { sensor: lidar_fwd, stop_mm: 60, action: [stop, back_off_20mm] }
  contact: { sensors: servo_load, action: [stop, torque_30] }
safety:
  triggers: [heartbeat_lost, servo_overtemp, vin_below_13v, efuse_fault, contact]
  routine:  [stop, brake, wait_2s, bow_to_rest, torque_low, face_sleepy]
  resume:   fresh_command_only

Verify before CAD freeze

- J1 thermal: hold the chain straight out for 20 s and for 60 s; set the firmware hold limit from the result.
- Joint ranges from a collision sweep of the printed parts: J1 −50° to 95°, J2–J5 about −85° to 35° (the long side is away from the bracket's bed face). Confirm on the real build.
- Spine harness flex life: 50,000 cycles through all five joints; the braid must sit on the outside of every bend.
- STS3215 backlash stacked over five joints puts about ±3 mm of wobble at the head. Check that it reads as "creature" and not "loose"; preload with a light spring at J1 if needed.
- Self-collision limits in the IK: use the swept ranges as hard limits with a 5° margin. The plump shells limit how far it can curl, so its rest pose is a forward bow rather than a tight coil.
- Power-loss drop: pull the plug at full extension and check that nothing breaks; consider a 2 F supercap so it can curl down first.
- Head pins: the XIAO uses all 11 header pins; the display backlight is tied on to free a pin for the lidar.
- No base turntable: confirm turning toward a voice with J2 and J4 alone looks natural, or add a sixth servo at the base (+$22, +60 g).
- Kid safety: pinch points between segments in tight curls; keep shells overlapping so fingers cannot reach the gaps.
