Meckie-AI/meckie-bodies/bodies/lamp/Lamp Design Brief.dc.html

Design brief · Rev A 2 Oct 2026 Meckie shared core

# LAMP.

An articulated desk-lamp Meckie body. Personality: a curious, animated desk companion that leans in, nods, and peeks around objects.

Est. mass

{{ totalStr }} g

{{ discStr }} mm steel ballast

Reach

350 mm

yaw axis → hood mouth · base Ø174 × 60 with foot

Axes

4 × STS3215

yaw · shoulder · elbow · head tilt

Tip margin at full reach

{{ marginStr }} mm

hangs {{ payloadStr }} g off the hood before tipping

Est. BOM

${{ costTotal }}

target $150 · see 05b

Power

USB-C PD

15 V · 45 W wall charger · no battery

01

## Concept views

Open full 3D viewer + GLB/OBJ export →

A sea-foam cone hood with a chrome rim, a brass finial and a signal-red knuckle at the back. Inside the hood sits a white reflector, a warm LED ring and the Ø32 face, with the camera tucked into the top of the lip. Twin brushed-aluminium-finish rails form both arm sections; brass counterbalance springs and a chrome pushrod run alongside them as visible mechanism, with the red braided harness clipped up the back. The arm rises from a cream shoulder pod on a chrome turret, over a weighted sea-foam base with a chrome band and red TPU foot. Each view can be dragged to orbit.

3/4 · {{ poseLabel }}

Side · spring A, parallelogram

Front · face, LED ring, speaker grille

Top

Rear · USB-C, brass toggle, harness, spring B + pushrod

Base Ø174 × 48 (to turret) Shoulder pivot 90 above desk Arm 160 + 160 · head pivot → mouth 86 Hood mouth Ø112 Attentive ≈ 270 H · asleep ≈ 260 H × 200 D

02

## Spring-balanced arm · exploded

Full stack in attentive pose; rails, springs and pushrod split sideways

Joint

Drive side

Support side

{{ j.joint }}

{{ j.drive }}

{{ j.support }}

Servos stay low

Three of the four servos sit at or below the shoulder. Shoulder (ID 2) and elbow drive (ID 3) share one pod on the turret, splines on the shoulder axis. ID 3 drives the upper arm through a crank and pushrod that form a parallelogram with the lower arm, so ID 3 sets the upper arm's absolute angle directly and the elbow carries only a pair of bearings. Only the head-tilt servo rides at the tip.

Counterbalance

Spring A runs from a turret lug 42 mm behind and below the shoulder to a pin 60 mm up the lower arm, balancing ID 2. Spring B runs from the opposite lug to the ID 3 crank pin, balancing the upper arm and head through the pushrod. Each spring is a near-zero-length setup (low initial tension, cord-to-pin), sized to cancel about 80% of gravity torque across the working range. With power off, the arm drifts slowly instead of dropping.

Head mass on the tilt axis

Hood 52 g · reflector liner 15 g · knuckle (two halves) 78 g · tilt servo + horn 58 g · display, retainer, bezel 14 g · camera + cradle 6 g · LED ring + diffuser 9 g · mics 2 g · wiring + fasteners 11 g
≈ {{ headMass }} g, CoM {{ comStr }} mm ahead of the tilt axis

02b

## Behaviour modes

Lamp moves like a character first and a light second. The two arm joints give it reach and posture, yaw turns it toward a voice, and the head tilt carries most of the expression. The eyes on the face lead each move by about 120 ms.

{{ m.n }}{{ m.q }}

{{ m.d }}

Control split

Central: who is talking, attention, behaviour, light scenes. Head ESP32-S3: camera stream to Central over Wi-Fi. Pi: face render, mic stream, voice bearing, target centring at 30 Hz. ESP32-S3: 4-axis trajectories and IK at 200 Hz, joint limits, collision detect, LED dimming, heartbeat watchdog, power and thermal guard.

03

## Body layout

X-ray: base, pod and hood shells at 13% opacity

Bus & power topology

USB-C PD · rear · 45 W charger→ PD sink · 15 V request→ Brass main toggle · 5 A fuse→ 12 V / 5 A buck · servos 5 V / 5 A buck · ESP32, Pi, amp, display CC LED driver · 15 V → ring

12 V servo · 4 A

eFuse · EN GPIO12→ Bus adapter→ ID 1 yaw→ cable clock → ID 2 shoulder · ID 3 elbow→ arm harness → ID 4 head tilt

Reflex brain · base

ESP32-S3 N16R8 UART1 · servo bus 1 Mbps PWM · LED dim ADC · VIN + 12 V sense Wi-Fi · Central heartbeat 10 Hz

Face brain · base

Pi Zero 2 W SPI · display (via harness) I²S · 2 mics in hood + amp in base UART · ESP32-S3 link 921 600

Arm harness

12 V · GND · bus · LED+ · LED− · 5 V · GND · MOSI · SCLK · CS · DC · RST · BL · BCLK · LRCLK · DIN14c 28 AWG silicone ribbon (power pairs 2 × 26 AWG) in braid. 5 V feeds the head ESP32-S3; its 3V3 regulator powers the display and mics. No camera cable in the arm.

{{ b.t }}

{{ b.d }}

03b

## Wiring diagram

15 V / 12 V 5 V Servo bus SPI I²S UART / GPIO Wi-Fi

04

## Joint load & stability check

All four joints run STS3215 (12 V, ≈ 2.9 N·m stall), with the continuous budget taken as 0.9 N·m. Worst case is full reach: lower arm 55° forward, upper arm 92°, head 25° down, hood mouth 350 mm from the yaw axis. Head {{ headMass }} g, CoM {{ comStr }} mm ahead of the tilt axis; each arm section ≈ 40 g. Springs are {{ springState }}. Lean-in and nod use 6 rad/s²; head nod 15 rad/s²; yaw turn 8 rad/s².

Case

Joint

Servo N·m

Budget used

{{ r.c }}

{{ r.j }}

{{ r.t }}

{{ r.p }}

Tip check · full reach

CoM {{ comXStr }} mm out · foot edge 87 mm · margin {{ marginStr }} mm · push to tip at head {{ tipStr }} N · {{ tipNote }}

With springs fitted, every holding case drops to under a fifth of budget, so the arm can sit lit for hours without heating the servos. The base is round, so yawing the arm does not change the tip margin. Tip margin is the whole robot's CoM measured from the foot edge; the payload figure is how much extra weight hung at the hood mouth it takes to reach the edge. Red torque rows would exceed the 0.9 N·m budget.

05

## Parts list & mass budget

{{ c.name }} · {{ c.g }} g Bar = {{ totalStr }} g total

Part

Group

Qty

Each g

Line g

Running

{{ p.n }}

{{ p.name }}

{{ p.cat }}

{{ p.qty }}

{{ p.unit }}

{{ p.sub }}

{{ p.run }}

Total

{{ totalStr }} g

Ballast is over half the robot on purpose: the arm reaches twice the base radius. Everything heavy that does not have to move lives in the base, and the shoulder pod keeps two of the four servos on the yaw axis. Each gram at the hood costs about 4 g of ballast to hold the same tip margin. Printed masses assume the settings in section 06.

05b

## BOM cost

Single unit · retail estimates, USD · Oct 2026

Over target. The spec build comes to ${{ costTotal }} against the $150 target. Four STS3215s and the Pi Zero 2 W alone are about $100. The head camera is a XIAO ESP32-S3 Sense, which costs less than Camera Module 3 and its cable. The savings list below gets to about ${{ liteTotal }}; reaching $150 would also mean dropping to three servos or a cheaper servo family.

{{ c.name }} · ${{ c.sum }} · {{ c.share }}

Item

Group

Qty

Each

Line

Running

{{ p.name }}

{{ p.cat }}

{{ p.qty }}

${{ p.unit }}

${{ p.line }}

${{ p.run }}

Total · single unit

${{ costTotal }} · range {{ costRange }}

Where to save

{{ s.t }}{{ s.v }}

All of the above≈ ${{ liteTotal }}

Prices are typical single-quantity retail and have not been checked against current listings; confirm them before ordering. Excludes the USB-C charger, tools, shipping, import duties and printer time.

05c

## Assembly · no glue

Every joint snaps or screws · fully reversible with a 2.5 mm and a 2 mm hex

Joint

Method

Detail

{{ a.j }}

{{ a.m }}

{{ a.d }}

Snap features are sized for PLA: 1.2 mm cantilever thickness, 0.6 mm hook depth, 30° lead-in, 45° release face so they can be unsnapped with a spudger. Screws into plastic always land in a heat-set insert, never a printed thread. No visible fastener heads: every screw sits under a brass pivot cap, a chrome pod cap, the hood liner, the TPU foot or inside the base. Threadlocker is optional on metal-to-metal threads only (servo horns, shoulder bolts, rod ends); use a removable grade.

06

## Print orientation

{{ q.part }}

{{ q.mat }}

{{ q.how }}

{{ q.settings }}

All parts fit a 220 × 220 bed; the Ø174 base shell is the largest. Arm rails are 182 mm overall and print flat along X. No painting or finishing anywhere: the silver and brass parts print in metallic-filled PLA. The reflector liner stays bare white PLA for the light.

06b

## Why these materials

Two filaments, and one of them only where flex is the point. The constraint that decided this was not strength: it was that a stock printer with no modifications should be able to make every rigid part on this body. PLA needs no hardened nozzle, no dry box, no enclosure and no 260 °C hotend, which is the difference between a pack most people can print and a pack most people can only read.

PLA

97% of the printed pieces

Everything rigid: shells, structure, brackets, bezels. Stiff, dimensionally accurate, prints unsupported on more surfaces than anything else, and stocked in every colour this body names.

TPU 95A

3% of the printed pieces

Only where compliance is the function and a rigid part would not work at all: foot. Nothing here is TPU for toughness alone.

What PLA costs you

Snap hooks are the weak point. The snap features on this body were drawn to stay under 2.5% strain, which suits PETG. PLA's safe cantilever strain is nearer 1.5%, so the hooks are working harder than the geometry assumed. Print them with the layer lines running across the hook rather than along it, open the shell gently, and treat a hook as a part you may have to reprint. Nothing in this pack has been test-printed, so this is the first place to look for trouble and the most useful thing you can report back.

Heat. PLA's glass transition is about 55 to 60 °C, and this body's servos do not warn until 65 °C. Indoors that gap never opens: the shell sits near room temperature and the servos are the only thing that gets hot. Left in a closed car in summer, or on a sill in direct sun, the shell can soften while the electronics still consider themselves fine. That is a storage rule, not a design flaw, and it is the main thing PETG would buy back.

Heat-set inserts. Every screw lands in a brass insert, and PLA's window is narrower than PETG's: run the iron cooler, around 180 to 200 °C, go in slowly, and let the boss cool before loading it. Rushing one slumps the wall around it.

If you want the margin back: the geometry does not change. Print the shells in PETG and the load-bearing structure in CF-nylon and every part still fits, because that was the original specification and the only thing that changed is which spool is on the shelf. The cost is a hardened nozzle, a dry box, and a printer that holds 260 °C. If you have that printer, the tougher parts are yours for a filament swap.

07

## Safety reflex · folds down to sleep

{{ s.t }} {{ s.h }} {{ s.d }}

Triggers

No Central heartbeat for 500 ms · any servo at 70 °C or above · input below 13 V (charger sagging or unplugged) · eFuse fault · collision (servo current spike or position error over limit).

Asleep pose

Yaw 0°, lower arm −15°, upper arm folded to 140°, head 60° down with the hood lip just over the base front. About 260 mm tall, inside the base footprint plus 30 mm. Light dims to 10% warm.

Power loss

No battery by design. The springs hold the arm near balance, so it settles slowly onto the printed shoulder stop rather than dropping. On a collision, the move stops and torque drops to 30% for 1 s before the fold.

Resume

Wakes only on a fresh command from Central. Restoring the heartbeat alone does not wake it. The desk light can be turned back on from Central while asleep.

08

## Hangar Bay manifest

Peripheral

Host

Bus

Addr / ID

Pins

{{ m.dev }}

{{ m.host }}

{{ m.bus }}

{{ m.addr }}

{{ m.pins }}

hangar_bay/lamp.yaml

body: lamp
doctrine: thin-client
central: { link: wifi, heartbeat_hz: 10, timeout_ms: 500 }
mcu:
  reflex: { chip: esp32s3, module: N16R8, location: base, reserved_gpio: [26-37] }
  face:   { chip: rpi_zero_2w, os: bookworm-lite, location: base }
  head_cam: { chip: esp32s3, module: xiao_esp32s3_sense, location: hood_lip, power: harness_5v }
power:  { source: usb_c_pd, request_v: 15, min_v: 13.0, battery: none }
buses:
  servo_bus: { host: reflex, uart: 1, tx: 17, rx: 18, baud: 1000000, half_duplex: true }
  link:      { reflex: { uart: 2, tx: 15, rx: 16 }, face: { uart: 0, tx: 14, rx: 15 }, baud: 921600 }
  spi0:      { host: face, mosi: 10, sclk: 11, cs: 8, hz: 32000000, cable_mm: 520 }
  i2s:       { host: face, bclk: 18, lrclk: 19, din: 20, dout: 21, rate: 48000 }
kinematics: { l1_mm: 160, l2_mm: 160, head_mm: 86, shoulder_h_mm: 90, elbow: parallelogram_from_base }
servos:
  - { id: 1, name: yaw,      model: sts3215, min_deg: -150, max_deg: 150, rest_deg: 0 }
  - { id: 2, name: shoulder, model: sts3215, min_deg: -20,  max_deg: 65,  rest_deg: -15, note: lower arm from vertical }
  - { id: 3, name: elbow,    model: sts3215, min_deg: 60,   max_deg: 150, rest_deg: 140, note: upper arm absolute from vertical }
  - { id: 4, name: head,     model: sts3215, min_deg: -90,  max_deg: 45,  rest_deg: -60, note: hood axis from horizontal }
servo_limits: { temp_warn_c: 65, temp_trip_c: 70, rest_torque_pct: 20, slow_dps: 30, collision_err_deg: 6 }
peripherals:
  - { name: servo_pwr,  part: efuse,     en: 12, fault: 13 }
  - { name: pd_good,    gpio: 6 }
  - { name: vin_sense,  adc_gpio: 1, divider: 100k_10k }
  - { name: v12_sense,  adc_gpio: 2, divider: 100k_10k }
  - { name: desk_light, part: cc_led_driver, pwm_gpio: 38, pwm_hz: 20000, max_ma: 350, cct_k: 2700 }
  - { name: face_wake,  gpio: 14, to: face.gpio3 }
  - { name: status_led, part: ws2812,    gpio: 48 }
  - { name: display,    part: gc9a01,    bus: spi0, dc: 25, rst: 24, bl_pwm: 13, size: 240x240 }
  - { name: mics,       part: ics43434,  bus: i2s, count: 2, sel: [gnd, 3v3], spacing_mm: 89 }
  - { name: speaker_amp, part: max98357a, bus: i2s, sd: 16 }
  - { name: camera,     part: ov3660,    host: head_cam, bus: dvp_onboard, stream: mjpeg_wifi, res: 1024x768, fps: 15 }
poses:
  asleep:    { yaw: 0, shoulder: -15, elbow: 140, head: -60, light_pct: 10 }
  attentive: { yaw: 0, shoulder: 15,  elbow: 95,  head: -35 }
safety:
  triggers: [heartbeat_lost, servo_overtemp, vin_below_13v, efuse_fault, collision]
  routine:  [stop, brake, wait_2s, slow_to_asleep, torque_low, light_dim_10, face_sleepy]
  resume:   fresh_command_only

Verify before CAD freeze

- Ribbon flex life through three joints: 50,000 cycles of the full shoulder, elbow and tilt range.
- Head ESP32-S3 camera stream: latency and frame rate to Central over household Wi-Fi with the LED PWM running; antenna clear of the metal-finish hood.
- SPI to the display at 32 MHz over 520 mm of ribbon with ground between signals; drop to 20 MHz if the face tears.
- I²S mic lines over the same run; check for crosstalk from the LED PWM and the servo bus.
- Spring rates: measure real gravity torque on the built arm, then pick springs that cancel 75–85% across the range. Starting points: spring A ≈ 0.13 N/mm, spring B ≈ 0.39 N/mm.
- Pinch points at the elbow scissor and the pushrod: the rails close to 8 mm near full fold. Add a finger guard or soft-limit the fold.
- Collision detection thresholds on STS3215 current and position feedback, so a hand in the way stops the arm.
- PD source compatibility: 15 V at 3 A from common 45 W chargers, and behaviour on a 5 V-only charger (light only, servos disabled).
- LED ring heat inside the hood next to the display at 100% for an hour; vent the knuckle if needed.
- Light quality: glare onto the camera from the liner; may need a small baffle above the ring.
- Yaw bearing and turret stiffness at full reach: tip deflection target under 2 mm.
- Cost: price the four servos and the Pi at time of purchase; decide on the savings list before ordering.
