Meckie-AI/meckie-bodies/bodies/rover-lite/Rover Lite Design Brief.dc.html

Design brief · Rev A 2 Oct 2026 Meckie shared core

# ROVER LITE.

A fully 3D-printed small tracked Meckie body. Personality: a little explorer, the desk-sized cousin of the full Rover.

Est. mass

{{ totalStr }} g

3S {{ packStr }} mAh smart pack

Envelope

212 × 152 × 190

mm L × W × H · to fin tip

Climbs

25 mm step

door thresholds are 10–20 mm

Top speed

{{ vCapStr }} m/s

N20 {{ ratioStr }}:1 · runtime ≈ {{ runStr }} h

Est. BOM

${{ costTotal }}

target ≈ $180 · see 05b

Brains

ESP32-S3 + Pi

N16R8 reflexes · Zero 2 W face

01

## Concept views

Open full 3D viewer + GLB/OBJ export →

A sea-foam hull under a cream deck, riding on black TPU tracks with sea-foam fenders, chrome edges and a red pinstripe. The head is a cream helmet drum that tilts about its own axis inside a brushed-aluminium-finish yoke. The face looks out of a chrome porthole ringed with brass rivets, under a chrome camera "lamp" with a red ring and a small red fin. The neck harness runs up the back in red braid. Each view can be dragged to orbit.

3/4 · {{ poseLabel }}

Side · raised front idler, rear drive

Front · face, VL53L8CX, drop ToF

Top

Rear · USB-C, brass toggle, speaker grille, harness, rear drop ToF

Track centres 160 · track width 26 · gauge 120 Sprocket Ø36 rear · idler Ø32 front, axle 30 high Belly clearance 16 Head drum Ø84 × 80 · tilt axis 136 above floor

02

## Tracks & neck · exploded

Tracks, running gear and fenders pulled outward; deck, neck and head lifted

Joint

Drive

Support

{{ j.joint }}

{{ j.drive }}

{{ j.support }}

Printed tracks

Each track is one continuous TPU 95A band, 26 mm wide and 2.8 mm thick, with inner guide teeth every 13 mm that mesh with the sprocket and run between the idler and road-wheel flanges, and outer grousers for grip. It prints standing up as a Ø140 ring with no supports and stretches into shape on the running gear. There are no pins or links to wear.

Climbing

The front idler axle sits 30 mm up, so the front run of the track meets a step face on an incline and walks up it. The rear sprocket drives, which keeps the lower run of the track in tension when climbing. The battery sits low between the tracks and puts the centre of mass 4 mm behind the hull centre, which keeps it from bucking as the nose lifts.

Neck

Pan STS3215 stands upright under a chrome turntable on a 6806 thin-section bearing. The yoke on top carries the helmet drum, which tilts about its own axis: the tilt STS3215 rides inside the drum and its horn bolts to the left yoke arm, with a 685ZZ and shoulder bolt on the right.

02b

## Behaviour modes

Rover Lite moves like a careful explorer: it stops to look before it goes, scans with the head while the tracks stay still, and creeps up to anything new.

{{ m.n }}{{ m.q }}

{{ m.d }}

Control split

Central: mapping, where to go, who is there, behaviour. Pi: face render, camera and mic streams, voice bearing, target centring. ESP32-S3: track speed loops at 500 Hz with encoder and IMU fusion, pan/tilt trajectories, obstacle and drop-off reflexes at 30–50 Hz, heartbeat watchdog, power and thermal guard.

03

## Body layout

X-ray: hull, deck, fenders, drum and tracks at 13% opacity

Bus & power topology

USB-C PD · rear→ PD sink · 15 V→ BQ25798 · 3S buck-boost charger↔ 3S {{ packStr }} smart pack→ Brass main toggle · 7.5 A fuse

VBAT 10.5–12.6 V

eFuse · EN GPIO14→ Bus adapter → ID 1 pan → cable clock → ID 2 tilt 6 V / 3 A buck → DRV8833 → N20 L + R 5 V / 5 A buck → ESP32-S3, Pi, amp, display

Reflex brain

ESP32-S3 N16R8 UART1 · servo bus 1 Mbps PCNT · 2 quadrature encoders I²C0 · L8CX, 2 × L0X, BNO085, BQ25798 I²C1 · pack gauge SMBus

Face brain

Pi Zero 2 W · hull CSI · camera (300 mm FFC via neck) SPI0 · display I²S · 2 mics in drum + amp in hull UART · ESP32-S3 link 921 600

Neck harness

12 V · GND · bus · 3V3 · GND · MOSI · SCLK · CS · DC · RST · BL · BCLK · LRCLK · DIN12c silicone ribbon + CSI FFC laid flat together in red braid

{{ b.t }}

{{ b.d }}

03b

## Wiring diagram

VBAT / 12 V / 6 V 5 V Servo bus I²C / I²S SPI / CSI Encoders UART link Wi-Fi

04

## Drive, climb & load check

N20 {{ ratioStr }}:1 6 V gearmotors on a regulated 6 V rail; sprocket pitch radius 20 mm; track efficiency taken as 70%. Robot {{ totalStr }} g, centre of mass 4 mm behind the hull centre and 44 mm high. Motor budget is 40% of stall per motor. Firmware limits: acceleration 1.5 m/s², braking 2.5 m/s², reverse 0.12 m/s; reaction time 30 ms. STS3215 budget is 0.9 N·m.

Case

Need

Have

Result

{{ r.c }}

{{ r.need }}

{{ r.have }}

{{ r.res }}

Threshold climb is modelled as a 25° incline while the nose rides up the step, plus 10% rolling and track loss. Skid-steer pivot turns take lateral friction μ 0.6 over a 160 mm contact length and 120 mm gauge. Drop-off look-ahead is measured from the front road wheel and the rear sprocket contact, where the robot would start to drop. Red rows exceed the budget or the look-ahead.

05

## Parts list & mass budget

{{ c.name }} · {{ c.g }} g Bar = {{ totalStr }} g total

Part

Group

Qty

Each g

Line g

Running

{{ p.n }}

{{ p.name }}

{{ p.cat }}

{{ p.qty }}

{{ p.unit }}

{{ p.sub }}

{{ p.run }}

Total

{{ totalStr }} g

The pack is the heaviest single part and sits on the belly between the tracks, just behind the hull centre. Head and neck together are about a fifth of the robot; keeping the Pi in the hull holds the head light so it does not pitch the robot back when climbing.

05b

## BOM cost

Single unit · retail estimates, USD · Oct 2026

Over target. The spec build comes to ${{ costTotal }} against about $180. The two STS3215s, Pi Zero 2 W, Camera Module 3, BNO085 and VL53L8CX alone are about ${{ coreCost }}. The savings list gets to about ${{ liteTotal }} with only small capability losses; reaching $180 would also mean dropping the VL53L8CX or the pan servo.

{{ c.name }} · ${{ c.sum }} · {{ c.share }}

Item

Group

Qty

Each

Line

Running

{{ p.name }}

{{ p.cat }}

{{ p.qty }}

${{ p.unit }}

${{ p.line }}

${{ p.run }}

Total · single unit

${{ costTotal }} · range {{ costRange }}

Where to save

{{ s.t }}{{ s.v }}

All of the above≈ ${{ liteTotal }}

Prices are typical single-quantity retail and have not been checked against current listings; confirm them before ordering. Excludes the USB-C PD charger, tools, shipping and printer time.

05c

## Assembly · no glue

Every joint screws or snaps · fully reversible with a 2 mm and a 1.5 mm hex

Joint

Method

Detail

{{ a.j }}

{{ a.m }}

{{ a.d }}

No glue, tape, epoxy or adhesive cable mounts anywhere. Press-fit bearings are always retained by a screwed clamp ring or a shoulder bolt. Screws into plastic always land in a heat-set insert. No visible fastener heads: deck screws sit under snap-on chrome caps, everything else enters under the fenders, under the deck or behind a brass pivot cap.

06

## Print orientation

{{ q.part }}

{{ q.mat }}

{{ q.how }}

{{ q.settings }}

All parts fit a 220 × 220 bed; the largest are the 192 mm hull tub (diagonal if needed) and the Ø140 track rings. No painting or finishing anywhere: the silver and brass parts print in metallic-filled PLA.

06b

## Why these materials

Two filaments, and one of them only where flex is the point. The constraint that decided this was not strength: it was that a stock printer with no modifications should be able to make every rigid part on this body. PLA needs no hardened nozzle, no dry box, no enclosure and no 260 °C hotend, which is the difference between a pack most people can print and a pack most people can only read.

PLA

96% of the printed pieces

Everything rigid: shells, structure, brackets, bezels. Stiff, dimensionally accurate, prints unsupported on more surfaces than anything else, and stocked in every colour this body names.

TPU 95A

4% of the printed pieces

Only where compliance is the function and a rigid part would not work at all: track loop. Nothing here is TPU for toughness alone.

What PLA costs you

Snap hooks are the weak point. The snap features on this body were drawn to stay under 2.5% strain, which suits PETG. PLA's safe cantilever strain is nearer 1.5%, so the hooks are working harder than the geometry assumed. Print them with the layer lines running across the hook rather than along it, open the shell gently, and treat a hook as a part you may have to reprint. Nothing in this pack has been test-printed, so this is the first place to look for trouble and the most useful thing you can report back.

Heat. PLA's glass transition is about 55 to 60 °C, and this body's servos do not warn until 65 °C. Indoors that gap never opens: the shell sits near room temperature and the servos are the only thing that gets hot. Left in a closed car in summer, or on a sill in direct sun, the shell can soften while the electronics still consider themselves fine. That is a storage rule, not a design flaw, and it is the main thing PETG would buy back.

Heat-set inserts. Every screw lands in a brass insert, and PLA's window is narrower than PETG's: run the iron cooler, around 180 to 200 °C, go in slowly, and let the boss cool before loading it. Rushing one slumps the wall around it.

If you want the margin back: the geometry does not change. Print the shells in PETG and the load-bearing structure in CF-nylon and every part still fits, because that was the original specification and the only thing that changed is which spool is on the shelf. The cost is a hardened nozzle, a dry box, and a printer that holds 260 °C. If you have that printer, the tougher parts are yours for a filament swap.

07

## Safety reflex · parks and dozes

{{ s.t }} {{ s.h }} {{ s.d }}

Triggers

No Central heartbeat for 500 ms · pack below 15% or 10.5 V · any servo at 70 °C or above · eFuse or DRV8833 fault · track stall over 1 s.

Always-on local reflexes

Edge: either drop ToF reads more than 25 mm past its floor baseline → brake at 2.5 m/s² and back off 30 mm. Obstacle: VL53L8CX zone under 60 mm in the direction of travel → stop. Lifted or tipped past 35° (BNO085) → tracks off.

Rest pose

Tracks stopped (clearing an edge first if one is within 40 mm). Head pan 0°, tilt −25°: the porthole looks down at the floor. Servos to 20% torque; DRV8833 asleep.

Resume

Moves again only on a fresh command from Central. Restoring the heartbeat alone does not wake it.

08

## Hangar Bay manifest

Peripheral

Host

Bus

Addr / ID

Pins

{{ m.dev }}

{{ m.host }}

{{ m.bus }}

{{ m.addr }}

{{ m.pins }}

hangar_bay/rover_lite.yaml

body: rover_lite
doctrine: thin-client
central: { link: wifi, heartbeat_hz: 10, timeout_ms: 500 }
mcu:
  reflex: { chip: esp32s3, module: N16R8, location: hull, reserved_gpio: [19, 20, 26-37, 43, 44] }
  face:   { chip: rpi_zero_2w, os: bookworm-lite, location: hull }
power:
  battery: { cells: 3, mah: 1500, smart: true, gauge: sbs, balance: true }
  charger: { part: bq25798, input: usb_c_pd, request_v: 15 }
  rails:   { servo: vbat_via_efuse, motor_6v: buck_3a, logic_5v: buck_5a }
buses:
  servo_bus: { host: reflex, uart: 1, tx: 17, rx: 18, baud: 1000000, half_duplex: true }
  i2c0:      { host: reflex, sda: 8,  scl: 9,  hz: 400000 }
  i2c1_smb:  { host: reflex, sda: 12, scl: 13, hz: 100000 }
  link:      { reflex: { uart: 2, tx: 15, rx: 16 }, face: { uart: 0, tx: 14, rx: 15 }, baud: 921600 }
  spi0:      { host: face, mosi: 10, sclk: 11, cs: 8, hz: 40000000, cable_mm: 300 }
  i2s:       { host: face, bclk: 18, lrclk: 19, din: 20, dout: 21, rate: 48000 }
  csi:       { host: face, port: cam0, ffc_mm: 300 }
drive:
  type: tracked_skid_steer
  sprocket_pitch_r_mm: 20
  gauge_mm: 120
  contact_len_mm: 160
  motor: { part: n20_6v, ratio: 298, driver: drv8833, pwm_hz: 20000, vm: 6.0 }
  left:  { in1: 38, in2: 39, enc_a: 1,  enc_b: 2, pcnt_unit: 0 }
  right: { in1: 40, in2: 41, enc_a: 47, enc_b: 3, pcnt_unit: 1 }
  driver: { nsleep: 42, nfault: 21 }
  limits: { accel_mps2: 1.5, brake_mps2: 2.5, v_mps: 0.2, v_reverse_mps: 0.12 }
servos:
  - { id: 1, name: pan,  model: sts3215, min_deg: -150, max_deg: 150, rest_deg: 0 }
  - { id: 2, name: tilt, model: sts3215, min_deg: -25,  max_deg: 35,  rest_deg: -25 }
  limits: { temp_warn_c: 65, temp_trip_c: 70, rest_torque_pct: 20, slow_dps: 30 }
peripherals:
  - { name: servo_pwr,  part: efuse, en: 14, fault: 21 }
  - { name: tof_fwd,    part: vl53l8cx, bus: i2c0, addr: 0x29, lpn: 4, int: 5, zones: 8x8 }
  - { name: drop_front, part: vl53l0x,  bus: i2c0, addr: 0x30, xshut: 10, tilt_deg: 30 }
  - { name: drop_rear,  part: vl53l0x,  bus: i2c0, addr: 0x31, xshut: 11, tilt_deg: -30 }
  - { name: imu,        part: bno085,   bus: i2c0, addr: 0x4A, int: 7, location: com }
  - { name: charger,    part: bq25798,  bus: i2c0, addr: 0x6B, int: 6 }
  - { name: gauge,      part: sbs_pack, bus: i2c1_smb, addr: 0x0B }
  - { name: face_wake,  gpio: 46, to: face.gpio3 }
  - { name: status_led, part: ws2812, gpio: 48 }
  - { name: display,    part: gc9a01,    bus: spi0, dc: 25, rst: 24, bl_pwm: 13, size: 240x240 }
  - { name: mics,       part: ics43434,  bus: i2s, count: 2, sel: [gnd, 3v3], spacing_mm: 84 }
  - { name: speaker_amp, part: max98357a, bus: i2s, sd: 16 }
  - { name: camera,     part: imx708,    bus: csi }
reflexes:
  edge:     { sensors: [drop_front, drop_rear], drop_mm: 25, action: [brake, back_off_30mm] }
  obstacle: { sensor: tof_fwd, stop_mm: 60 }
  tilt:     { sensor: imu, max_deg: 35, action: tracks_off }
safety:
  triggers: [heartbeat_lost, soc_below_15, vbat_below_10v5, servo_overtemp, efuse_fault, drv_fault, stall_1s]
  routine:  [stop, brake, wait_2s, edge_clear_creep, head_to_rest_slow, torque_low, face_sleepy]
  resume:   fresh_command_only

Verify before CAD freeze

- Printed TPU track: tooth engagement under climbing load (no ratcheting over the sprocket), stretch over a week of tension, and whether 95A or 90A grips better on wood thresholds.
- Track tension: set the idler slot travel (±4 mm) once the real band length is known; check the band does not walk off on pivot turns.
- Threshold climb on a real 20 mm aluminium door strip, both directions, at an angle as well as square on.
- Camera FFC through the pan cable clock and the tilt axis: 50,000 cycles of full pan and tilt range.
- Drop-off ToF on dark rugs and glossy floors; the VL53L8CX can double-check edges on the forward zones.
- N20 speed and stall at 6 V for the chosen ratio; listings vary widely between sellers.
- Head drum packaging: tilt STS3215, display, Camera Module 3 and both mics inside Ø84 × 80, with the FFC fold behind the display.
- Heat: Pi Zero 2 W and two bucks share the closed hull; add a vent path under the fenders if the Pi throttles.
- Cost: decide on the savings list before ordering.
