Meckie-AI/meckie-bodies/bodies/scout/Scout Design Brief.dc.html

Design brief · Rev A 2 Oct 2026 Meckie shared core · ESP32-only

# SCOUT.

A tiny two-wheeled floor runner Meckie body. Personality: an excitable puppy that zips over to greet you.

Est. mass

{{ totalStr }} g

{{ packStr }} mAh 1S pack

Envelope

115 × 104 × 73

mm L × W × H · to ear tops

Top speed

{{ vCapStr }} m/s

capped by drop-off stop · motor max {{ vMaxStr }}

Runtime

≈ {{ runStr }} h

awake, camera on, 30% driving

Est. BOM

${{ costTotal }}

target under $80 · see 05b

Drive

2 × N20

{{ ratioStr }}:1 · hall encoders · rear ball caster

01

## Concept views

Open full 3D viewer + GLB/OBJ export →

A cream dome over a sea-foam tub, with red TPU bumpers front and rear. The round face sits in a chrome-bezelled porthole tilted 11° up, so Scout looks up at you from the floor. Floppy red TPU ears, a chrome hood over the camera and a whip-antenna tail with a red ball. Black TPU tyres with cream whitewalls and chrome hubcaps. Each view can be dragged to orbit.

3/4 · {{ poseLabel }}

Side · axle 12 mm ahead of centre

Front · face, camera, forward lidar, front drop ToF

Top

Rear · speaker grille, USB-C, brass switch, tail antenna, rear drop ToF

Body 120 L × 88 W (bumper) · 117 W over wheels Wheel Ø40 · track 108 · axle 12 ahead of centre Caster 56 behind axle Ground clearance 6 · face centre 50 above floor

02

## Drivetrain & shell · exploded

Shells split vertically, wheels and motors outward, deck up, caster down

Joint

Drive / fix

Support

{{ j.joint }}

{{ j.drive }}

{{ j.support }}

Layout

The two N20s lie end to end on saddles moulded into the lower-shell floor just ahead of centre, encoders facing inward, each clamped by a PLA strap. The battery sits flat behind them and the ball caster at the tail, so the centre of mass falls 12 mm behind the axle: the caster carries about a fifth of the weight and Scout never rocks onto its nose.

Bump tolerance

The 11 mm red TPU bumpers, front and rear, have a flat flange clamped in the upper-shell rim and stand 5.5 mm proud of the shell. The tyres take knocks from the side. The ears and tail are TPU or spring-steel and flex out of the way. Collisions are sensed by the IMU (deceleration spike) and the encoders (stall against commanded speed), so there are no bump switches to fail.

Wheels

Printed PLA hub with a Ø3 D-bore and an M2 set screw into a radial heat-set insert · TPU 95A tyre snaps on, its inner rib locking into a groove round the hub rim · chrome hubcap with cream whitewall clicks in on three split pins

02b

## Behaviour modes

Scout has no neck, so the whole body is the expression: it turns on the spot to look, wiggles to wag, and darts to greet. The face does the rest.

{{ m.n }}{{ m.q }}

{{ m.d }}

Control split

Central: who is there, where to go, behaviour, voice. XIAO ESP32-S3: camera and mic streams over Wi-Fi, face render, wheel speed loops at 500 Hz, drop-off and lift reflexes at 50 Hz, heartbeat watchdog, battery guard. Navigation targets arrive from Central as short drive arcs.

03

## Body layout

X-ray: shells, bumper and tyres at 13% opacity

Bus & power topology

USB-C · rear · 5 V→ 1S charger · power path · 1 A↔ 1S LiPo {{ packStr }} mAh→ VSYS 3.5–4.4 V → Brass main switch · EN→ 3.3 V buck-boost · 1 A VSYS → DRV8833 VM, PAM8302

Brain

XIAO ESP32-S3 Sense Onboard camera · onboard PDM mic Wi-Fi · Central heartbeat 10 Hz All 11 header pins used

Drive

PWM ×2 · D2 D3+ Direction ×2 via expander→ DRV8833→ N20 L · N20 R→ encoder A ×2 → PCNT D0 D1

I²C · 400 kHz

VL53L1X forward lidar 0x2A VL53L0X drop front 0x30 VL53L0X drop rear 0x29 IMU 0x6A MAX17048 gauge 0x36 TCA9554 expander 0x20

Face & voice

SPI · GC9A01 (SCK, MOSI, DC; CS tied low) PDM out D6 → RC → PAM8302 → Ø20 speaker

{{ b.t }}

{{ b.d }}

03b

## Wiring diagram

VSYS / battery 3.3 V I²C Expander outputs SPI Encoders Audio / status Wi-Fi

The XIAO has 11 free header pins and Scout uses all of them. Anything slow (motor direction, driver sleep, display reset and backlight, rear ToF shutdown, amp shutdown, charger status) moves to a TCA9554 on I²C. Each DRV8833 channel takes PWM on IN1 and direction on IN2; in reverse the firmware inverts the duty. Encoders use channel A only, counted by the S3's PCNT unit, with direction taken from the command.

04

## Drive & drop-off check

N20 {{ ratioStr }}:1 6 V gearmotors run straight off the 1S rail, about {{ vmStr }} V at the motor under load. Robot {{ totalStr }} g, wheel radius 20 mm, centre of mass 12 mm behind the axle and 25 mm high, caster 56 mm behind the axle. Firmware limits: acceleration 2.5 m/s², braking 3.5 m/s², reverse 0.15 m/s. Each ToF reads at 50 Hz; reaction time, including braking start, is taken as 30 ms.

Case

Need

Have

Result

{{ r.c }}

{{ r.need }}

{{ r.have }}

{{ r.res }}

The front ToF is angled 25° forward and sees the floor 50 mm ahead of the wheel contact; the rear one sees 20 mm behind the caster. Top speed is capped so the stopping distance plus a 10 mm margin fits inside that look-ahead. Lower gear ratios do not make Scout faster on a table, only on the floor once Central allows "open floor" mode with the cap lifted. Runtime assumes 1.1 W average while awake with the camera streaming.

05

## Parts list & mass budget

{{ c.name }} · {{ c.g }} g Bar = {{ totalStr }} g total

Part

Group

Qty

Each g

Line g

Running

{{ p.n }}

{{ p.name }}

{{ p.cat }}

{{ p.qty }}

{{ p.unit }}

{{ p.sub }}

{{ p.run }}

Total

{{ totalStr }} g

Light on purpose: under 200 g means a bump at full speed carries about 0.01 J, less than a dropped phone from 5 mm. The battery is the heaviest single part and sits low behind the axle, which is what sets the 12 mm CoM offset.

05b

## BOM cost

Single unit · retail estimates, USD · Oct 2026

{{ costHead }} {{ costBody }}

{{ c.name }} · ${{ c.sum }} · {{ c.share }}

Item

Group

Qty

Each

Line

Running

{{ p.name }}

{{ p.cat }}

{{ p.qty }}

${{ p.unit }}

${{ p.line }}

${{ p.run }}

Total · single unit

${{ costTotal }} · range {{ costRange }}

Where to save

{{ s.t }}{{ s.v }}

Prices are typical single-quantity retail and have not been checked against current listings; confirm them before ordering. Excludes the USB-C charger brick, tools, shipping and printer time.

05c

## Assembly · no glue

Every joint screws or snaps · fully reversible with a 1.5 mm hex and a spudger

Joint

Method

Detail

{{ a.j }}

{{ a.m }}

{{ a.d }}

No glue, tape, epoxy or adhesive cable mounts anywhere. Screws into plastic always land in a heat-set insert (M2 / M2.5 / M3). Snap features are sized at under 2.5% strain, which was a PETG figure and is optimistic for the PLA this pack now specifies: PLA's safe cantilever strain is nearer 1.5%, so the hooks are the first thing expected to fail, and nothing here has been test-printed. No visible fastener heads: the four shell screws enter from underneath through tubes in the lower shell.

06

## Print orientation

{{ q.part }}

{{ q.mat }}

{{ q.how }}

{{ q.settings }}

Every part fits a 220 × 220 bed several times over; a full set prints on two plates (PLA and TPU). No painting or finishing anywhere: the silver and brass parts print in metallic-filled PLA.

06b

## Why these materials

Two filaments, and one of them only where flex is the point. The constraint that decided this was not strength: it was that a stock printer with no modifications should be able to make every rigid part on this body. PLA needs no hardened nozzle, no dry box, no enclosure and no 260 °C hotend, which is the difference between a pack most people can print and a pack most people can only read.

PLA

73% of the printed pieces

Everything rigid: shells, structure, brackets, bezels. Stiff, dimensionally accurate, prints unsupported on more surfaces than anything else, and stocked in every colour this body names.

TPU 95A

27% of the printed pieces

Only where compliance is the function and a rigid part would not work at all: bumper, front, bumper, rear, floppy ear, tail ball, tyre. Nothing here is TPU for toughness alone.

What PLA costs you

Snap hooks are the weak point. The snap features on this body were drawn to stay under 2.5% strain, which suits PETG. PLA's safe cantilever strain is nearer 1.5%, so the hooks are working harder than the geometry assumed. Print them with the layer lines running across the hook rather than along it, open the shell gently, and treat a hook as a part you may have to reprint. Nothing in this pack has been test-printed, so this is the first place to look for trouble and the most useful thing you can report back.

Heat. PLA's glass transition is about 55 to 60 °C. Indoors that is never approached. Left in a closed car in summer, or on a sill in direct sun, the shell can soften. That is a storage rule, not a design flaw, and it is the main thing PETG would buy back.

Heat-set inserts. Every screw lands in a brass insert, and PLA's window is narrower than PETG's: run the iron cooler, around 180 to 200 °C, go in slowly, and let the boss cool before loading it. Rushing one slumps the wall around it.

If you want the margin back: the geometry does not change. Print the shells in PETG and the load-bearing structure in CF-nylon and every part still fits, because that was the original specification and the only thing that changed is which spool is on the shelf. The cost is a hardened nozzle, a dry box, and a printer that holds 260 °C. If you have that printer, the tougher parts are yours for a filament swap.

07

## Safety reflex · sits and naps

{{ s.t }} {{ s.h }} {{ s.d }}

Triggers

No Central heartbeat for 500 ms · battery below 15% or 3.45 V · motor driver fault (nFAULT) or stall over 1 s · motor current over limit.

Always-on local reflexes

Edge: either ToF reads more than 25 mm past its floor baseline → brake at 3.5 m/s², then back off 20 mm. Lift: IMU free-fall or both ToF out of range → motors off at once. These run on the S3 even with Central connected.

Rest pose

Scout has no joints, so resting means stopping where it is, unless a ToF sees an edge within 40 mm, in which case it first creeps away from it at 0.05 m/s. Motors to coast with the driver asleep.

Resume

Wakes only on a fresh command from Central. Restoring the heartbeat alone does not wake it. Being picked up and set down again does not wake it either.

08

## Hangar Bay manifest

Peripheral

Host

Bus

Addr / ID

Pins

{{ m.dev }}

{{ m.host }}

{{ m.bus }}

{{ m.addr }}

{{ m.pins }}

hangar_bay/scout.yaml

body: scout
doctrine: thin-client
central: { link: wifi, heartbeat_hz: 10, timeout_ms: 500, antenna: ufl_external }
mcu:
  reflex: { chip: esp32s3, module: xiao_esp32s3_sense, psram: 8MB, role: [reflex, face, camera, mic] }
power:
  battery: { cells: 1, chem: lipo, mah: 1000, protected: true }
  charger: { part: bq24074_class, input: usb_c_5v, ichg_ma: 1000, power_path: true }
  rail_3v3: { part: buck_boost, en: main_switch }
  low_soc_pct: 15
  low_v: 3.45
buses:
  i2c0: { sda: 5, scl: 6, hz: 400000 }
  spi2: { sclk: 7, mosi: 9, hz: 40000000 }
expander: { part: tca9554, bus: i2c0, addr: 0x20,
  pins: { p0: motor_l_dir, p1: motor_r_dir, p2: drv_nsleep, p3: disp_rst, p4: disp_bl, p5: tof_rear_xshut, p6: amp_sd, p7: chg_pg_in } }
drive:
  type: differential
  wheel_d_mm: 40
  track_mm: 108
  motor: { part: n20_6v, ratio: 100, driver: drv8833, mode: pwm_in1_dir_in2, pwm_hz: 20000 }
  left:  { pwm: 3, dir: expander.p0, enc_a: 1, pcnt_unit: 0 }
  right: { pwm: 4, dir: expander.p1, enc_a: 2, pcnt_unit: 1 }
  enc_cpr_wheel: 1400
  limits: { accel_mps2: 2.5, brake_mps2: 3.5, v_table_mps: 0.4, v_reverse_mps: 0.15, yaw_dps: 360 }
peripherals:
  - { name: lidar_fwd, part: vl53l1x, bus: i2c0, addr: 0x2A, xshut: 44, fov: 27, role: obstacle }
  - { name: tof_front, part: vl53l0x, bus: i2c0, addr: 0x30, tilt_deg: 25, role: drop_off }
  - { name: tof_rear,  part: vl53l0x, bus: i2c0, addr: 0x29, xshut: expander.p5, tilt_deg: -25, role: drop_off }
  - { name: imu,       part: lsm6dsox, bus: i2c0, addr: 0x6A, location: com }
  - { name: gauge,     part: max17048, bus: i2c0, addr: 0x36 }
  - { name: display,   part: gc9a01, bus: spi2, dc: 8, cs: tied_low, rst: expander.p3, bl: expander.p4, size: 240x240 }
  - { name: mic,       part: onboard_pdm, clk: 42, data: 41 }
  - { name: speaker,   part: pam8302, input: pdm_tx, pin: 43, sd: expander.p6 }
  - { name: camera,    part: ov3660, bus: onboard_dvp, stream: mjpeg_wifi, res: 800x600, fps: 15 }
reflexes:
  obstacle: { sensor: lidar_fwd, stop_mm: 80, slow_mm: 250 }
  edge:  { sensors: [tof_front, tof_rear], drop_mm: 25, action: [brake, back_off_20mm] }
  lift:  { sensors: [imu, tof_front, tof_rear], action: motors_off }
  bump:  { sensors: [imu, encoders], decel_g: 1.5, stall_ms: 300, action: [stop, back_off_30mm] }
safety:
  triggers: [heartbeat_lost, soc_below_15, vbat_below_3v45, drv_fault, stall_1s, overcurrent]
  routine:  [stop, brake, wait_2s, edge_clear_creep, motors_coast, face_sleepy]
  resume:   fresh_command_only

Verify before CAD freeze

- Drop-off ToF on dark rugs, glossy tables and glass: VL53L0X can read black carpet as "no floor". Tune the baseline per surface and test stair edges and table edges at full speed.
- Front ToF window under the bumper: check the bumper does not enter the 25° cone at any bump deflection.
- Electronics deck rear screws land in notches at the tub's rounded corners; confirm the heads clamp firmly.
- Real N20 speed and stall torque at 3.5 V for the chosen ratio; listings vary widely between sellers.
- Encoder channel A only: confirm odometry drift is acceptable for Central's navigation, or add channel B by moving the lidar XSHUT onto a second expander.
- Wi-Fi range with the tail whip inside a cream PLA dome and the antenna lead routed past the motors.
- PDM-to-PAM8302 audio quality through an RC filter; if it is too noisy, swap to a MAX98357A and free a pin by moving the display DC to an expander-driven 9-bit SPI mode.
- IMU choice: the shared core calls for a BNO085 at the centre of mass. Scout uses an LSM6DSOX to hold the budget; confirm heading drift is acceptable or take the +$15.
- Ears and tail: TPU ears must not reach the wheels when floppy; the whip must spring back after being stepped on.
- Shell scuffing: metallic PLA cannot chip, since the colour runs all the way through, but it scuffs and the flake shows wear differently from a flat colour. Worth a look after the first few collisions.
