Meckie-AI/meckie-bodies/bodies/wobble/Wobble Design Brief.dc.html

Design brief · Rev A 2 Oct 2026 Meckie shared core

# WOBBLE.

A self-balancing two-wheeled Meckie body. Personality: a bouncy, slightly clumsy friend who rocks and sways while it talks.

Est. mass

{{ totalStr }} g

CoM {{ comAxleStr }} mm above axle

Envelope

74 × 157 × 232

mm D × W × H · to antenna tips

Recoverable lean

{{ recStr }}°

{{ motorShort }} · need ≥ 15°

Runtime

≈ {{ runStr }} h

balancing · {{ runSitStr }} h sitting

Est. BOM

${{ costTotal }}

target ≈ $150 · see 05b

Brains

2 × ESP32-S3

N16R8 balance · XIAO Sense head

01

## Concept views

Open full 3D viewer + GLB/OBJ export →

A wide, squared-off body like a 1950s table radio, 120 mm across and only 74 mm deep, with a sea-foam belly tub and a cream upper split by two chrome bands. It rides on two red TPU wheels with cream hubs and chrome caps, set wide at 136 mm. The face sits in a chrome-bezelled collar, with the camera in a chrome hood above it. Red TPU bumpers round off both top corners, and two spring antennae with red balls bob as it sways. Two brushed-finish kickstand legs with red feet fold flat against the belly front and back. The head harness runs up the back in red braid. Each view can be dragged to orbit.

3/4 · {{ poseLabel }}

Side · kickstand legs, harness

Front · face, camera, grille, lidar, drop ToF

Top

Rear · battery door, USB-C, brass toggle, harness, rear drop ToF

Body 120 W × 74 D × 200 H · wheels Ø64, track 140 Axle 32 above floor · face centre 148 Legs reach ±70 mm from the axle Ground clearance 16

02

## Drive & kickstand · exploded

Belly down, upper shell and bumpers up, wheels and motors outward, legs pulled clear

Joint

Drive

Support

{{ j.joint }}

{{ j.drive }}

{{ j.support }}

Balance stack

The two N20s lie end to end on the axle line in a PLA motor block, encoders facing inward. The BNO085 stands on a bracket between the two encoders, on the axle line itself, so it reads pitch with no lever-arm acceleration from wheel moves. The ESP32-S3 runs the balance loop at 400 Hz from the IMU's 400 Hz gyro and game-rotation reports.

Battery high

The 2S pack sits behind the face, {{ battYStr }} mm above the floor. That lifts the centre of mass to {{ comAxleStr }} mm above the axle, which slows the fall (time constant {{ tauStr }} ms) and gives the loop more time per correction. The torque needed to hold a lean does not change with height, so the motors are not penalised.

Kickstands

One MG90S micro servo in the belly drives both legs through two pushrods. Each leg swings 118° from flat against the shell to down-and-out, and the linkage goes 4° over centre at full deploy, so the robot's weight locks the legs open instead of loading the servo. Feet land 70 mm ahead of and behind the axle.

02b

## Behaviour modes

Wobble's body language comes from the balance setpoint. Shifting the target pitch makes it lean, rock or bob; the balance loop does the rest and keeps it upright.

{{ m.n }}{{ m.q }}

{{ m.d }}

Control split

Central: who is there, where to go, what to say, behaviour. XIAO Sense (head): camera and mic streams over Wi-Fi, face render, speech playback, speech envelope to the base. ESP32-S3 (base): 400 Hz balance loop, wheel speed and yaw, sway from the speech envelope, lidar and drop-off reflexes, kickstand, heartbeat watchdog, power guard.

03

## Body layout

X-ray: shells at 13% opacity

Bus & power topology

USB-C PD · rear→ PD sink · 9 V→ BQ25798 · 2S charger↔ 2S 1000 smart pack→ Brass toggle · 5 A fuse

VBAT 6.4–8.4 V

DRV8833 VM → N20 L + R (duty capped to 6.5 V) 5 V / 3 A buck → ESP32-S3, harness to head, amp Load switch → MG90S

Balance brain · belly

ESP32-S3 N16R8 PCNT · 2 quadrature encoders I²C0 · BNO085, VL53L1X, 2 × VL53L0X, BQ25798 I²C1 · pack gauge SMBus LEDC · motors 20 kHz, servo 50 Hz

Head brain · top

XIAO ESP32-S3 Sense Onboard camera · Wi-Fi to Central SPI · GC9A01 I²S · 2 mics in, amp out UART · base link 921 600

Head harness

5 V · GND · TX · RX4 conductors, 24 AWG, outside up the back in red braid

{{ b.t }}

{{ b.d }}

03b

## Wiring diagram

VBAT 5 V I²C / I²S / SPI Encoders Servo PWM UART link Wi-Fi

04

## Balance, edge & load check

Motors: {{ motorName }}, duty capped so they see at most 6.5 V from the 2S pack. Robot {{ totalStr }} g with the centre of mass {{ comAxleStr }} mm above the axle; wheel radius 32 mm. Transient budget is 60% of stall per motor, continuous 30%. Reflected rotor inertia through the gearbox is added to the robot's effective mass. A balancing robot cannot brake straight away: it must first roll forward to lean back, modelled as 250 ms plus 30 ms reaction, then decelerate at 2 m/s².

Case

Need

Have

Result

{{ r.c }}

{{ r.need }}

{{ r.have }}

{{ r.res }}

Recoverable lean is the angle at which the motors can still drive the wheels under the centre of mass faster than it falls (base acceleration above g·tanθ). 15° covers the ±8° talking sway plus a light nudge. The 30:1 N20 fails on torque; the 50:1 N20 passes with a small margin; the N30 (same footprint, longer motor) roughly doubles it. Switch motors in Tweaks to compare.

05

## Parts list & mass budget

{{ c.name }} · {{ c.g }} g Bar = {{ totalStr }} g total

Part

Group

Qty

Each g

Line g

Height

Running

{{ p.n }}

{{ p.name }}

{{ p.cat }}

{{ p.qty }}

{{ p.unit }}

{{ p.sub }}

{{ p.y }}

{{ p.run }}

Total

{{ totalStr }} g · CoM {{ comFloorStr }} mm above floor

Height is each part's centre above the floor, used for the centre-of-mass figure. The pack is the heaviest single part and sits high on purpose. The motors and wheels at the bottom are the next heaviest; keeping them light keeps the reflected inertia low.

05b

## BOM cost

Single unit · retail estimates, USD · Oct 2026

Near target. The spec build comes to ${{ costTotal }} against about $150. Two choices hold it there: a micro servo for the kickstands instead of an STS3215, and a XIAO ESP32-S3 Sense in the head instead of a Pi Zero 2 W with Camera Module 3. The BNO085 is the single most expensive part.

{{ c.name }} · ${{ c.sum }} · {{ c.share }}

Item

Group

Qty

Each

Line

Running

{{ p.name }}

{{ p.cat }}

{{ p.qty }}

${{ p.unit }}

${{ p.line }}

${{ p.run }}

Total · single unit

${{ costTotal }} · range {{ costRange }}

Where to save

{{ s.t }}{{ s.v }}

Prices are typical single-quantity retail and have not been checked against current listings; confirm them before ordering. Excludes the USB-C PD charger, tools, shipping and printer time.

05c

## Assembly · no glue

Every joint screws or snaps · fully reversible with a 2 mm and a 1.5 mm hex

Joint

Method

Detail

{{ a.j }}

{{ a.m }}

{{ a.d }}

No glue, tape, epoxy or adhesive cable mounts anywhere. Screws into plastic always land in a heat-set insert. No visible fastener heads: shell screws enter from inside the battery bay, under the corner bumpers or behind the hubcaps.

06

## Print orientation

{{ q.part }}

{{ q.mat }}

{{ q.how }}

{{ q.settings }}

Every part fits a 220 × 220 bed; the largest are the 124 × 128 mm upper shell halves. No painting or finishing anywhere: the silver and brass parts print in metallic-filled PLA.

06b

## Why these materials

Two filaments, and one of them only where flex is the point. The constraint that decided this was not strength: it was that a stock printer with no modifications should be able to make every rigid part on this body. PLA needs no hardened nozzle, no dry box, no enclosure and no 260 °C hotend, which is the difference between a pack most people can print and a pack most people can only read.

PLA

79% of the printed pieces

Everything rigid: shells, structure, brackets, bezels. Stiff, dimensionally accurate, prints unsupported on more surfaces than anything else, and stocked in every colour this body names.

TPU 95A

21% of the printed pieces

Only where compliance is the function and a rigid part would not work at all: antenna ball, corner bumper, kickstand foot, tyre. Nothing here is TPU for toughness alone.

What PLA costs you

Snap hooks are the weak point. The snap features on this body were drawn to stay under 2.5% strain, which suits PETG. PLA's safe cantilever strain is nearer 1.5%, so the hooks are working harder than the geometry assumed. Print them with the layer lines running across the hook rather than along it, open the shell gently, and treat a hook as a part you may have to reprint. Nothing in this pack has been test-printed, so this is the first place to look for trouble and the most useful thing you can report back.

Heat. PLA's glass transition is about 55 to 60 °C. Indoors that is never approached. Left in a closed car in summer, or on a sill in direct sun, the shell can soften. That is a storage rule, not a design flaw, and it is the main thing PETG would buy back.

Heat-set inserts. Every screw lands in a brass insert, and PLA's window is narrower than PETG's: run the iron cooler, around 180 to 200 °C, go in slowly, and let the boss cool before loading it. Rushing one slumps the wall around it.

If you want the margin back: the geometry does not change. Print the shells in PETG and the load-bearing structure in CF-nylon and every part still fits, because that was the original specification and the only thing that changed is which spool is on the shelf. The cost is a hardened nozzle, a dry box, and a printer that holds 260 °C. If you have that printer, the tougher parts are yours for a filament swap.

07

## Safety reflex · rolls to a stop and sits

{{ s.t }} {{ s.h }} {{ s.d }}

Triggers

No Central heartbeat for 500 ms · pack below 20% or 6.8 V (sits with margin to spare) · DRV8833 fault · motor stall over 1 s · XIAO link lost for 2 s.

Always-on local reflexes

Edge: a drop ToF reads more than 25 mm past its pitch-corrected floor distance → stop and back off 40 mm. Obstacle: lidar under 200 mm → stop. Fall: pitch past 35° → motors off at once, oops face.

Rest pose

Upright on both wheels and both kickstand feet, legs locked over centre, motors off, servo unpowered. Stable to 36° of push before it would tip over a foot.

Resume

Stands up only on a fresh command from Central: balance loop engages on the legs, then the legs fold away. Restoring the heartbeat alone does not wake it.

08

## Hangar Bay manifest

Peripheral

Host

Bus

Addr / ID

Pins

{{ m.dev }}

{{ m.host }}

{{ m.bus }}

{{ m.addr }}

{{ m.pins }}

hangar_bay/wobble.yaml

body: wobble
doctrine: thin-client
central: { link: wifi, heartbeat_hz: 10, timeout_ms: 500 }
mcu:
  reflex: { chip: esp32s3, module: N16R8, location: belly, role: [balance, drive, sense, legs, power] }
  head:   { chip: esp32s3, module: xiao_esp32s3_sense, location: top, role: [camera, face, mics, speaker] }
power:
  battery: { cells: 2, mah: 1000, smart: true, gauge: sbs, balance: true }
  charger: { part: bq25798, input: usb_c_pd, request_v: 9 }
  rails:   { motor: vbat_direct, logic_5v: buck_3a, servo: 5v_load_switch }
  sit_soc_pct: 20
  sit_v: 6.8
links:
  base_head: { reflex: { uart: 2, tx: 17, rx: 18 }, head: { tx: 43, rx: 44 }, baud: 921600 }
buses:
  i2c0:     { host: reflex, sda: 8, scl: 9, hz: 400000 }
  i2c1_smb: { host: reflex, sda: 4, scl: 5, hz: 100000 }
  spi:      { host: head, sclk: 7, mosi: 9, hz: 40000000 }
  i2s:      { host: head, bclk: 3, ws: 4, din: 5, dout: 6, rate: 16000 }
balance:
  imu: { part: bno085, bus: i2c0, addr: 0x4A, int: 7, rst: 6, reports: { game_rv_hz: 400, gyro_hz: 400 }, location: axle_line }
  loop_hz: 400
  controller: lqr_cascade
  com_above_axle_mm: 63
  pitch_trim_deg: 0.0
  sway: { source: head.speech_envelope, max_deg: 8, max_hz: 2 }
  fall_deg: 35
drive:
  type: two_wheel_balancing
  wheel_d_mm: 64
  track_mm: 140
  motor: { part: n20_6v, ratio: 50, driver: drv8833, pwm_hz: 20000, max_duty_pct: 78 }
  left:  { in1: 38, in2: 39, enc_a: 1,  enc_b: 2, pcnt_unit: 0 }
  right: { in1: 40, in2: 41, enc_a: 47, enc_b: 3, pcnt_unit: 1 }
  driver: { nsleep: 42, nfault: 21 }
  enc_cpr_wheel: 1400
  limits: { v_mps: 0.3, v_reverse_mps: 0.15, decel_mps2: 2.0 }
kickstand:
  servo: { part: mg90s, pwm_gpio: 14, hz: 50, power_en: 15 }
  stowed_us: 2350
  deployed_us: 650
  over_centre_deg: 4
peripherals:
  - { name: lidar_fwd,  part: vl53l1x, bus: i2c0, addr: 0x2A, xshut: 10, role: obstacle }
  - { name: drop_front, part: vl53l0x, bus: i2c0, addr: 0x30, xshut: 11, tilt_deg: 35, role: drop_off, pitch_comp: true }
  - { name: drop_rear,  part: vl53l0x, bus: i2c0, addr: 0x31, xshut: 12, tilt_deg: -35, role: drop_off, pitch_comp: true }
  - { name: charger,    part: bq25798, bus: i2c0, addr: 0x6B, int: 13 }
  - { name: gauge,      part: sbs_pack, bus: i2c1_smb, addr: 0x0B }
  - { name: status_led, part: ws2812, gpio: 48 }
  - { name: display,    part: gc9a01, host: head, bus: spi, dc: 8, rst: 1, bl: 2, cs: tied_low, size: 240x240 }
  - { name: mics,       part: ics43434, host: head, bus: i2s, count: 2, sel: [gnd, 3v3] }
  - { name: speaker,    part: max98357a, host: head, bus: i2s, sd: tied_high }
  - { name: camera,     part: ov3660, host: head, bus: onboard_dvp, stream: mjpeg_wifi, res: 800x600, fps: 15 }
reflexes:
  edge:     { sensors: [drop_front, drop_rear], drop_mm: 25, action: [stop, back_off_40mm] }
  obstacle: { sensor: lidar_fwd, slow_mm: 400, stop_mm: 200 }
  fall:     { sensor: imu, pitch_deg: 35, action: motors_off }
safety:
  triggers: [heartbeat_lost, soc_below_20, vbat_below_6v8, drv_fault, stall_1s, head_link_lost]
  routine:  [stop, hold_position, wait_2s, legs_deploy, settle_on_legs, motors_off, servo_off, face_sleepy]
  resume:   fresh_command_only

Verify before CAD freeze

- N20 gearbox backlash: measure it on the chosen motors. More than about 2° at the wheel makes the balance loop buzz; the N30 or a different gearbox may be needed even if torque passes.
- Balance tuning on real hardware with the pack high; confirm the CoM height and trim the pitch offset.
- Drop-off ToF with pitch correction while swaying: the floor reading moves several mm with each rock. Test table edges at full cruise speed.
- Kickstand over-centre lock: check it holds with the robot pushed 20° and that the MG90S can unlock it from the resting load.
- Total power loss means a fall from 200 mm. Drop-test the corner bumpers and face bezel onto a hard floor and check the display survives.
- Motor overvolt: N20 6 V motors on 2S with the duty capped; check winding temperature after 30 min of balancing.
- XIAO pins: all 11 are used. Confirm the camera, SPI and both I²S directions coexist without conflicts.
- IMU noise from motor PWM and magnet fields at the axle; the BNO085 game-rotation vector ignores the magnetometer, but check gyro noise.
- Shared-core deviations to sign off: micro servo instead of STS3215, 2S instead of 3S (DRV8833 is limited to 10.8 V), XIAO Sense instead of Pi Zero 2 W with Camera Module 3.
