Meckie-AI/meckie-bodies/bodies/comet/parts-list.csv

part | qty | where | link | notes
STS3215 / ST3215 serial bus servo, 12 V | 12 | Amazon | https://www.amazon.com/s?k=Feetech%20STS3215%2012V%20servo | All joints. Waveshare ST3215 is the same servo.
Metal 25T servo horn for STS3215 | 12 | Amazon | https://www.amazon.com/s?k=STS3215%20metal%20horn%2025T
685ZZ bearing 5×14×5 | 16 | Amazon | https://www.amazon.com/s?k=685ZZ%20bearing | Abduction, hip pitch, knee ×2 per leg.
M5 shoulder bolt, M4 thread (ISO 7379), 6–12 mm shoulder | 12 | Amazon | https://www.amazon.com/s?k=M5%20shoulder%20bolt%20M4%20thread
M3 ball rod end | 8 | Amazon | https://www.amazon.com/s?k=M3%20ball%20rod%20end
M3 threaded rod + turnbuckle + jam nuts | 4 | Amazon | https://www.amazon.com/s?k=M3%20turnbuckle%20rod | Front 149.5 mm, rear 129.2 mm c-c.
N20 gearmotor ~700 rpm with hall encoder, 3 mm D-shaft | 4 | Amazon | https://www.amazon.com/s?k=N20%20encoder%20gear%20motor%206V%20700rpm
Ø30 silicone tire | 4 | Amazon | https://www.amazon.com/s?k=30mm%20silicone%20tire%20robot
DRV8833 dual motor driver | 2 | Amazon | https://www.amazon.com/s?k=DRV8833%20motor%20driver
ESP32-S3 N16R8 DevKitC | 1 | Amazon | https://www.amazon.com/s?k=ESP32-S3%20N16R8%20DevKitC | Reflex brain.
Raspberry Pi Zero 2 W + microSD | 1 | Raspberry Pi | https://www.raspberrypi.com/products/raspberry-pi-zero-2-w/
Raspberry Pi Camera Module 3 | 1 | Raspberry Pi | https://www.raspberrypi.com/products/camera-module-3/
BNO085 IMU breakout | 1 | Adafruit | https://www.adafruit.com/product/4754
VL53L8CX 8×8 ToF breakout | 1 | SparkFun / Pololu | https://www.amazon.com/s?k=VL53L8CX%20breakout | Forward lidar.
VL53L1X ToF breakout | 4 | Amazon | https://www.amazon.com/s?k=VL53L1X%20breakout | Drop-off sensors.
1.28" GC9A01 round display | 1 | Amazon | https://www.amazon.com/s?k=GC9A01%201.28%20round%20display
ICS-43434 I²S MEMS mic breakout | 2 | Amazon | https://www.amazon.com/s?k=ICS-43434%20I2S%20microphone
MAX98357A I²S amp + Ø28 speaker | 1 | Amazon | https://www.amazon.com/s?k=MAX98357A%20amplifier%2028mm%20speaker
Serial bus servo adapter (TTL) | 1 | Amazon | https://www.amazon.com/s?k=Waveshare%20bus%20servo%20adapter
3S LiPo 2200 mAh | 1 | Amazon | https://www.amazon.com/s?k=3S%202200mAh%20lipo%2011.1V | Cells go into the printed cartridge.
MAX17320 3S BMS / gauge board | 1 | Amazon / DigiKey | https://www.amazon.com/s?k=MAX17320%20evaluation%20board | Or the custom power board.
STUSB4500 USB-C PD sink | 1 | SparkFun | https://www.sparkfun.com/products/15801
BQ25798 buck-boost charger board | 1 | DigiKey | https://www.amazon.com/s?k=BQ25798%20charger%20board
5 V / 5 A buck | 1 | Amazon | https://www.amazon.com/s?k=5V%205A%20buck%20converter
Servo eFuse / high-side switch ×2 + 7.5 A fuses | 1 | DigiKey | https://www.amazon.com/s?k=TPS25982%20efuse | On the power board.
Main toggle switch + 10 A fuse | 1 | Amazon | https://www.amazon.com/s?k=mini%20toggle%20switch%20panel%20mount%2010A
Heat-set inserts kit M2 / M2.5 / M3 / M4 | 1 | Amazon | https://www.amazon.com/s?k=heat%20set%20insert%20kit%20M2%20M2.5%20M3%20M4
Screw kit M2 / M2.5 / M3 (nylon M3 for shell) | 1 | Amazon | https://www.amazon.com/s?k=M2%20M2.5%20M3%20screw%20kit
26 AWG silicone wire, JST connectors, flat cable | 1 | Amazon | https://www.amazon.com/s?k=26AWG%20silicone%20wire%20JST%20kit
