Meckie-AI/meckie-bodies/bodies/biped-mini/parts-list.csv

part | qty | where | link | notes
STS3215 / ST3215 serial bus servo, 12 V 30 kg | 6 | Amazon | https://www.amazon.com/dp/B0CFY52HVV | Get the 12 V / 30 kg version, not the 7.4 V one.
Metal servo horn for STS3215 (25T) | 6 | Amazon | https://www.amazon.com/s?k=STS3215%20metal%20servo%20horn%20aluminum | Some servos ship with a metal horn; check before buying.
Raspberry Pi Zero 2 W | 1 | raspberrypi.com | https://www.raspberrypi.com/products/raspberry-pi-zero-2-w/ | Usually marked up on Amazon. Buy from an approved reseller at list price, with a 32 GB microSD.
ESP32-S3-DevKitC-1 N16R8 | 1 | Amazon | https://www.amazon.com/dp/B0CDRM6BGQ | Must be N16R8 (16 MB flash, 8 MB PSRAM).
Serial bus servo driver / adapter board | 1 | Amazon | https://www.amazon.com/dp/B0CJBKQ8LJ | TTL half-duplex adapter for ST/SC servos.
Raspberry Pi Camera Module 3 | 1 | raspberrypi.com | https://www.raspberrypi.com/products/camera-module-3/ | Standard (not wide) lens, plus a Zero-size FFC cable.
1.28" GC9A01 round display, 240×240 | 1 | Amazon | https://www.amazon.com/s?k=GC9A01%201.28%20inch%20round%20LCD%20240x240 | SPI version.
ICS-43434 I²S MEMS mic breakout | 2 | Adafruit | https://www.adafruit.com/search?q=ICS-43434 | Rarely on Amazon. INMP441 boards on Amazon work as a substitute.
MAX98357A I²S amplifier breakout | 1 | Amazon | https://www.amazon.com/dp/B0CJMBMXMH
Speaker, Ø28 mm, 8 Ω 1 W | 1 | Amazon | https://www.amazon.com/s?k=28mm%20speaker%208%20ohm%201W
BNO085 9-DoF IMU breakout | 1 | Amazon | https://www.amazon.com/s?k=BNO085%20IMU%20breakout | Adafruit or a clone.
VL53L8CX 8×8 ToF lidar breakout | 1 | DigiKey | https://www.digikey.com/en/products/result?keywords=SATEL-VL53L8 | ST SATEL-VL53L8 board. A VL53L5CX board on Amazon is a close substitute.
VL53L0X ToF breakout | 2 | Amazon | https://www.amazon.com/s?k=VL53L0X%20time%20of%20flight%20sensor%20breakout | Drop-off sensors.
3S Li-ion pack with BMS + balance lead | 1 | Amazon | https://www.amazon.com/s?k=3S%2011.1V%2018650%20battery%20pack%20BMS%20balance | Capacity as in the brief.
BQ25798 charger breakout | 1 | Adafruit | https://www.adafruit.com/search?q=BQ25798 | Multi-cell USB-C charger with power path.
USB-C PD trigger board (sink) | 1 | Amazon | https://www.amazon.com/dp/B0H1BYPQ1T | DIP-switch selectable voltage; set to the value in the brief.
5 V / 5 A buck converter | 1 | Amazon | https://www.amazon.com/s?k=5V%205A%20buck%20converter%20module
eFuse / load switch breakout | 1 | DigiKey | https://www.digikey.com/en/products/result?keywords=TPS25947%20evaluation | TPS2594x-class eFuse. A 10 A blade fuse plus MOSFET switch board works as a simpler alternative.
Feetech STS3032 serial bus servo, 6 V 4.5 kg·cm | 4 | Amazon | https://www.amazon.com/s?k=Feetech+STS3032 | Hip roll and ankle roll. Runs on its own 6 V bus.
6 V / 5 A buck + second serial bus adapter | 1 | Amazon | https://www.amazon.com/s?k=6V+5A+buck+converter | Feeds the STS3032 bus.
683ZZ bearings + M3 shoulder screws | 4 | Amazon | https://www.amazon.com/s?k=683ZZ+bearing | Roll-joint idlers.
685ZZ bearings + M5 shoulder bolts + nyloc nuts | 6 | Amazon | https://www.amazon.com/s?k=685ZZ+bearing | Pitch-joint idlers.
