Meckie-AI/meckie-bodies/bodies/inchworm/parts-list.csv

part | qty | where | link | notes
STS3215 / ST3215 serial bus servo, 12 V 30 kg | 5 | Amazon | https://www.amazon.com/dp/B0CFY52HVV | Get the 12 V / 30 kg version, not the 7.4 V one.
Metal servo horn for STS3215 (25T) | 5 | Amazon | https://www.amazon.com/s?k=STS3215%20metal%20servo%20horn%20aluminum | Some servos ship with a metal horn; check before buying.
ESP32-S3-DevKitC-1 N16R8 | 1 | Amazon | https://www.amazon.com/dp/B0CDRM6BGQ | Must be N16R8 (16 MB flash, 8 MB PSRAM).
Serial bus servo driver / adapter board | 1 | Amazon | https://www.amazon.com/dp/B0CJBKQ8LJ | TTL half-duplex adapter for ST/SC servos.
Seeed XIAO ESP32-S3 Sense (camera + mic) | 1 | Amazon | https://www.amazon.com/dp/B0C69FFVHH | The Sense version, with the camera board.
1.28" GC9A01 round display, 240×240 | 1 | Amazon | https://www.amazon.com/s?k=GC9A01%201.28%20inch%20round%20LCD%20240x240 | SPI version.
ICS-43434 I²S MEMS mic breakout | 2 | Adafruit | https://www.adafruit.com/search?q=ICS-43434 | Rarely on Amazon. INMP441 boards on Amazon work as a substitute.
VL53L1X ToF lidar breakout | 1 | Amazon | https://www.amazon.com/s?k=VL53L1X%20time%20of%20flight%20sensor%20breakout | Forward lidar, 4 m.
Raspberry Pi Zero 2 W | 1 | raspberrypi.com | https://www.raspberrypi.com/products/raspberry-pi-zero-2-w/ | Usually marked up on Amazon. Buy from an approved reseller at list price, with a 32 GB microSD.
MAX98357A I²S amplifier breakout | 1 | Amazon | https://www.amazon.com/dp/B0CJMBMXMH
Speaker, Ø28 mm, 8 Ω 1 W | 1 | Amazon | https://www.amazon.com/s?k=28mm%20speaker%208%20ohm%201W
SK6812 2020 addressable LED strip | 1 | Amazon | https://www.amazon.com/s?k=SK6812%202020%20LED%20strip
USB-C PD trigger board (sink) | 1 | Amazon | https://www.amazon.com/dp/B0H1BYPQ1T | DIP-switch selectable voltage; set to the value in the brief.
12 V / 5 A buck converter | 1 | Amazon | https://www.amazon.com/s?k=12V%205A%20step%20down%20buck%20converter%20module
5 V / 5 A buck converter | 1 | Amazon | https://www.amazon.com/s?k=5V%205A%20buck%20converter%20module
eFuse / load switch breakout | 1 | DigiKey | https://www.digikey.com/en/products/result?keywords=TPS25947%20evaluation | TPS2594x-class eFuse. A 10 A blade fuse plus MOSFET switch board works as a simpler alternative.
Toggle switch + inline blade fuse holder | 1 | Amazon | https://www.amazon.com/s?k=brass%20toggle%20switch%20SPST%2010A | Pick a brass or chrome finish.
685ZZ bearings + M5 shoulder bolts + M5 nyloc nuts | 5 | Amazon | https://www.amazon.com/s?k=685ZZ+bearing | One per joint.
