Meckie-AI/meckie-bodies/bodies/rover-lite/parts-list.csv

part | qty | where | link | notes
STS3215 / ST3215 serial bus servo, 12 V 30 kg | 2 | Amazon | https://www.amazon.com/dp/B0CFY52HVV | Get the 12 V / 30 kg version, not the 7.4 V one.
Metal servo horn for STS3215 (25T) | 2 | Amazon | https://www.amazon.com/s?k=STS3215%20metal%20servo%20horn%20aluminum | Some servos ship with a metal horn; check before buying.
N20 6 V gearmotor with hall encoder | 2 | Amazon | https://www.amazon.com/s?k=N20%20gear%20motor%20encoder%206V | Ratio as in the brief.
DRV8833 dual motor driver | 1 | Amazon | https://www.amazon.com/s?k=DRV8833%20motor%20driver%20module
683ZZ bearing (3×7×3) | 16 | Amazon | https://www.amazon.com/s?k=683ZZ%20bearing | Comes in 10-packs; buy two.
6806-2RS bearing (30×42×7) | 1 | Amazon | https://www.amazon.com/s?k=6806-2RS%20bearing
Raspberry Pi Zero 2 W | 1 | raspberrypi.com | https://www.raspberrypi.com/products/raspberry-pi-zero-2-w/ | Usually marked up on Amazon. Buy from an approved reseller at list price, with a 32 GB microSD.
ESP32-S3-DevKitC-1 N16R8 | 1 | Amazon | https://www.amazon.com/dp/B0CDRM6BGQ | Must be N16R8 (16 MB flash, 8 MB PSRAM).
Serial bus servo driver / adapter board | 1 | Amazon | https://www.amazon.com/dp/B0CJBKQ8LJ | TTL half-duplex adapter for ST/SC servos.
Raspberry Pi Camera Module 3 | 1 | raspberrypi.com | https://www.raspberrypi.com/products/camera-module-3/ | Standard (not wide) lens, plus a Zero-size FFC cable.
Pi Zero camera FFC cable, 300 mm | 1 | Amazon | https://www.amazon.com/s?k=Raspberry%20Pi%20Zero%20camera%20cable%2022%20pin%2015%20pin%20300mm | 22-pin to 15-pin, 300 mm.
1.28" GC9A01 round display, 240×240 | 1 | Amazon | https://www.amazon.com/s?k=GC9A01%201.28%20inch%20round%20LCD%20240x240 | SPI version.
ICS-43434 I²S MEMS mic breakout | 2 | Adafruit | https://www.adafruit.com/search?q=ICS-43434 | Rarely on Amazon. INMP441 boards on Amazon work as a substitute.
BNO085 9-DoF IMU breakout | 1 | Amazon | https://www.amazon.com/s?k=BNO085%20IMU%20breakout | Adafruit or a clone.
VL53L8CX 8×8 ToF lidar breakout | 1 | DigiKey | https://www.digikey.com/en/products/result?keywords=SATEL-VL53L8 | ST SATEL-VL53L8 board. A VL53L5CX board on Amazon is a close substitute.
VL53L0X ToF breakout | 2 | Amazon | https://www.amazon.com/s?k=VL53L0X%20time%20of%20flight%20sensor%20breakout | Drop-off sensors.
MAX98357A I²S amplifier breakout | 1 | Amazon | https://www.amazon.com/dp/B0CJMBMXMH
Speaker, Ø28 mm, 8 Ω 1 W | 1 | Amazon | https://www.amazon.com/s?k=28mm%20speaker%208%20ohm%201W
3S Li-ion pack with BMS + balance lead | 1 | Amazon | https://www.amazon.com/s?k=3S%2011.1V%2018650%20battery%20pack%20BMS%20balance | Capacity as in the brief.
BQ25798 charger breakout | 1 | Adafruit | https://www.adafruit.com/search?q=BQ25798 | Multi-cell USB-C charger with power path.
USB-C PD trigger board (sink) | 1 | Amazon | https://www.amazon.com/dp/B0H1BYPQ1T | DIP-switch selectable voltage; set to the value in the brief.
5 V / 5 A buck converter | 1 | Amazon | https://www.amazon.com/s?k=5V%205A%20buck%20converter%20module
6 V / 3 A buck converter | 1 | Amazon | https://www.amazon.com/s?k=adjustable%20buck%20converter%203A%20mini | Adjustable, set to 6 V.
eFuse / load switch breakout | 1 | DigiKey | https://www.digikey.com/en/products/result?keywords=TPS25947%20evaluation | TPS2594x-class eFuse. A 10 A blade fuse plus MOSFET switch board works as a simpler alternative.
685ZZ bearing + M5 shoulder bolt (tilt idler) | 1 | Amazon | https://www.amazon.com/s?k=685ZZ+bearing | In the workshop kit.
Heat-set inserts M2 / M2.5 / M3 / M5 + screws | 1 kit | Amazon | https://www.amazon.com/s?k=heat+set+insert+kit+M2+M2.5+M3+M5 | See the workshop kit on the parts page.
