Meckie-AI/meckie-bodies/bodies/scout/parts-list.csv

part | qty | where | link | notes
N20 6 V gearmotor with hall encoder | 2 | Amazon | https://www.amazon.com/s?k=N20%20gear%20motor%20encoder%206V | Ratio as in the brief.
DRV8833 dual motor driver | 1 | Amazon | https://www.amazon.com/s?k=DRV8833%20motor%20driver%20module
Seeed XIAO ESP32-S3 Sense (camera + mic) | 1 | Amazon | https://www.amazon.com/dp/B0C69FFVHH | The Sense version, with the camera board.
1.28" GC9A01 round display, 240×240 | 1 | Amazon | https://www.amazon.com/s?k=GC9A01%201.28%20inch%20round%20LCD%20240x240 | SPI version.
VL53L1X ToF lidar breakout | 1 | Amazon | https://www.amazon.com/s?k=VL53L1X%20time%20of%20flight%20sensor%20breakout | Forward lidar, 4 m.
VL53L0X ToF breakout | 2 | Amazon | https://www.amazon.com/s?k=VL53L0X%20time%20of%20flight%20sensor%20breakout | Drop-off sensors.
LSM6DSOX 6-DoF IMU breakout | 1 | Adafruit | https://www.adafruit.com/search?q=LSM6DSOX
Speaker, Ø20 mm + PAM8302 amp | 1 | Amazon | https://www.amazon.com/s?k=20mm%20speaker%208%20ohm%20PAM8302%20amplifier
TCA9554 I²C GPIO expander | 1 | DigiKey | https://www.digikey.com/en/products/result?keywords=TCA9554 | Any TCA9554 / PCA9554 breakout.
2.4 GHz u.FL whip antenna | 1 | Amazon | https://www.amazon.com/s?k=2.4GHz%20u.FL%20IPEX%20antenna
1S LiPo cell with protection | 1 | Amazon | https://www.amazon.com/s?k=3.7V%20LiPo%20battery%20JST%201000mAh | Size as in the brief.
1S USB-C charger with power path | 1 | Amazon | https://www.amazon.com/s?k=USB%20C%20lithium%20charger%20power%20path%20module%201S
MAX17048 fuel gauge breakout | 1 | Adafruit | https://www.adafruit.com/search?q=MAX17048
3.3 V buck-boost regulator | 1 | Amazon | https://www.amazon.com/s?k=3.3V%20buck%20boost%20converter%20module
Steel bearing ball, 12 mm | 1 | Amazon | https://www.amazon.com/s?k=12mm+steel+bearing+ball | Caster ball.
Heat-set inserts M2 / M2.5 / M3 + screws | 1 kit | Amazon | https://www.amazon.com/s?k=heat+set+insert+kit+M2+M2.5+M3 | See the workshop kit on the parts page.
