Meckie-AI/meckie-bodies/bodies/wobble/parts-list.csv

part | qty | where | link | notes
N20 6 V gearmotor with hall encoder | 2 | Amazon | https://www.amazon.com/s?k=N20%20gear%20motor%20encoder%206V | Ratio as in the brief.
DRV8833 dual motor driver | 1 | Amazon | https://www.amazon.com/s?k=DRV8833%20motor%20driver%20module
MG90S metal-gear micro servo | 1 | Amazon | https://www.amazon.com/s?k=MG90S%20micro%20servo%20metal%20gear
ESP32-S3-DevKitC-1 N16R8 | 1 | Amazon | https://www.amazon.com/dp/B0CDRM6BGQ | Must be N16R8 (16 MB flash, 8 MB PSRAM).
Seeed XIAO ESP32-S3 Sense (camera + mic) | 1 | Amazon | https://www.amazon.com/dp/B0C69FFVHH | The Sense version, with the camera board.
BNO085 9-DoF IMU breakout | 1 | Amazon | https://www.amazon.com/s?k=BNO085%20IMU%20breakout | Adafruit or a clone.
VL53L1X ToF lidar breakout | 1 | Amazon | https://www.amazon.com/s?k=VL53L1X%20time%20of%20flight%20sensor%20breakout | Forward lidar, 4 m.
VL53L0X ToF breakout | 2 | Amazon | https://www.amazon.com/s?k=VL53L0X%20time%20of%20flight%20sensor%20breakout | Drop-off sensors.
1.28" GC9A01 round display, 240×240 | 1 | Amazon | https://www.amazon.com/s?k=GC9A01%201.28%20inch%20round%20LCD%20240x240 | SPI version.
ICS-43434 I²S MEMS mic breakout | 2 | Adafruit | https://www.adafruit.com/search?q=ICS-43434 | Rarely on Amazon. INMP441 boards on Amazon work as a substitute.
MAX98357A I²S amplifier breakout | 1 | Amazon | https://www.amazon.com/dp/B0CJMBMXMH
Speaker, Ø28 mm, 8 Ω 1 W | 1 | Amazon | https://www.amazon.com/s?k=28mm%20speaker%208%20ohm%201W
2S Li-ion pack with BMS | 1 | Amazon | https://www.amazon.com/s?k=2S%207.4V%201000mAh%20battery%20pack%20BMS
BQ25798 charger breakout | 1 | Adafruit | https://www.adafruit.com/search?q=BQ25798 | Multi-cell USB-C charger with power path.
USB-C PD trigger board (sink) | 1 | Amazon | https://www.amazon.com/dp/B0H1BYPQ1T | DIP-switch selectable voltage; set to the value in the brief.
5 V / 3 A buck converter | 1 | Amazon | https://www.amazon.com/s?k=5V%203A%20mini%20buck%20converter%20module
eFuse / load switch breakout | 1 | DigiKey | https://www.digikey.com/en/products/result?keywords=TPS25947%20evaluation | TPS2594x-class eFuse. A 10 A blade fuse plus MOSFET switch board works as a simpler alternative.
Spring-steel antenna stalks + M3 brass inserts | 2 | Amazon | https://www.amazon.com/s?k=spring+steel+antenna+wire | Thread into the roof inserts.
Z-bend pushrods 1 mm steel | 2 | Amazon | https://www.amazon.com/s?k=rc+pushrod+z+bend | Kickstand linkage.
