Meckie-AI/meckie-bodies/bodies/biped-mini/stl/biped-mini-hip_bracket_L-x1.stl

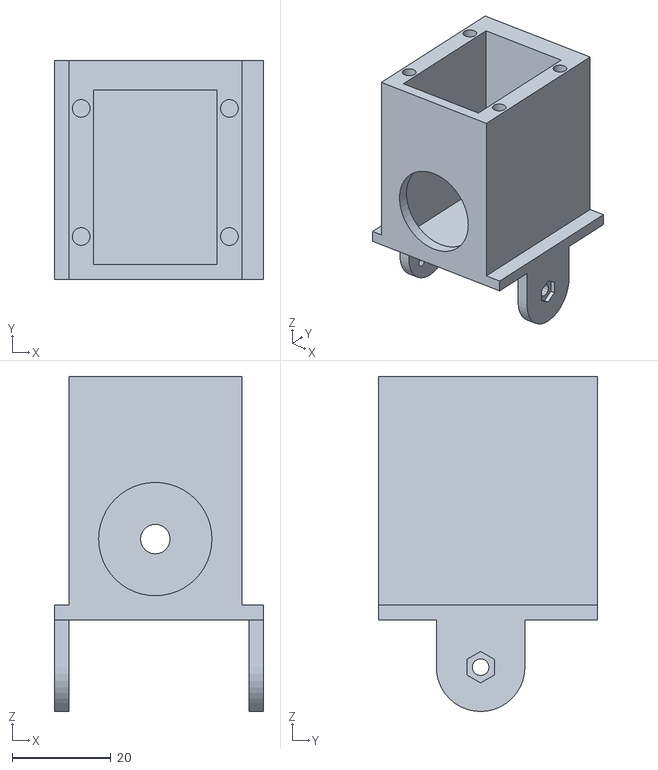
[picture p1: CAD file, 2026-10-04]
bodies/biped-mini/stl/biped-mini-hip_bracket_L-x1.stl
42.5 x 44.4 x 68.0
