Meckie-AI/meckie-bodies/bodies/comet/stl/comet-tail_fin-x1.stl

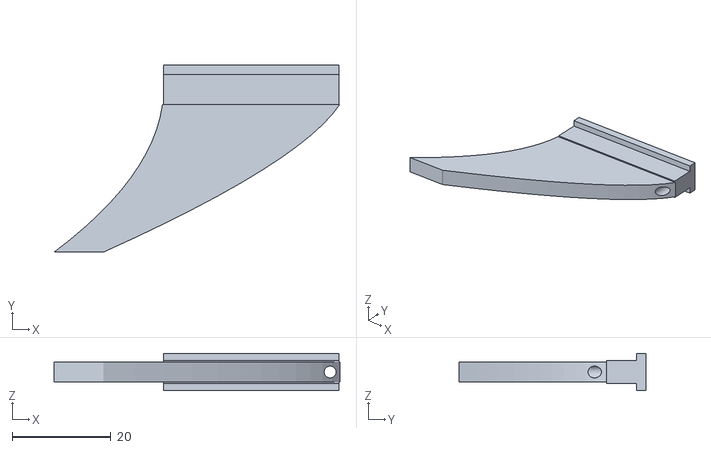
[picture p2: CAD file, 2026-10-06]
bodies/comet/stl/comet-tail_fin-x1.stl
58.0 x 38.0 x 7.60
