Meckie-AI/meckie-bodies/bodies/dial/stl/dial-esp_cradle-x1.stl

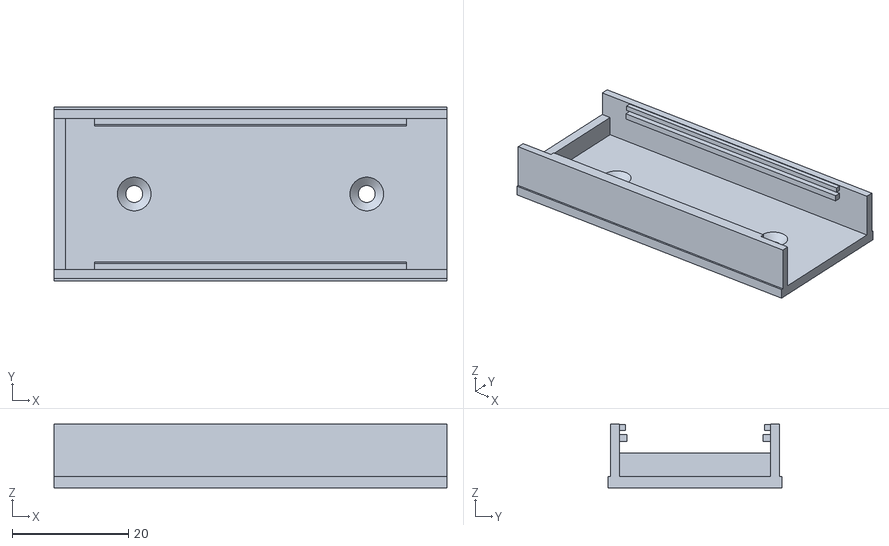
[picture p3: CAD file, 2026-10-04]
bodies/dial/stl/dial-esp_cradle-x1.stl
67.6 x 29.9 x 11.0
