Meckie-AI/meckie-bodies/bodies/inchworm/stl/inchworm-xiao_cradle-x1.stl

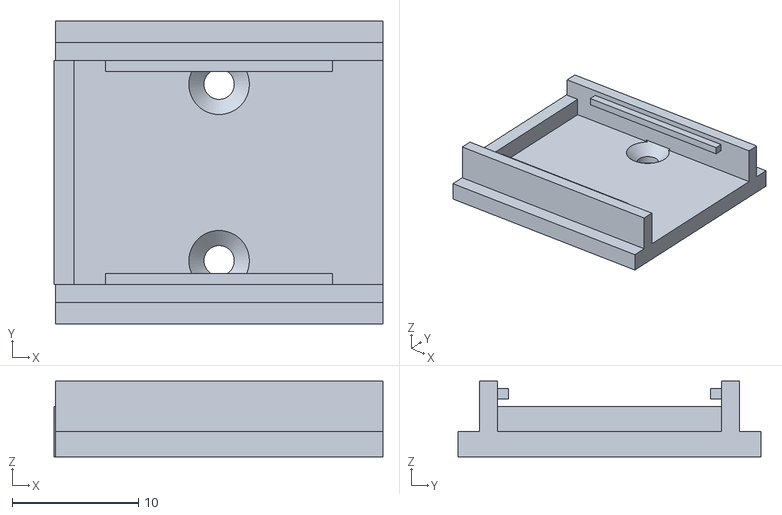
[picture p4: CAD file, 2026-10-04]
bodies/inchworm/stl/inchworm-xiao_cradle-x1.stl
26.1 x 24.0 x 6.00
