Meckie-AI/meckie-bodies/bodies/rover-lite/stl/rover-lite-porthole_bezel-x1.stl

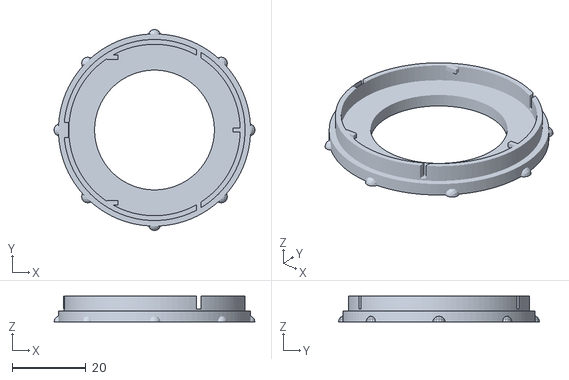
[picture p5: CAD file, 2026-10-04]
bodies/rover-lite/stl/rover-lite-porthole_bezel-x1.stl
54.4 x 54.4 x 7.00
