Meckie-AI/meckie-bodies/bodies/scout/stl/scout-face_bezel-x1.stl

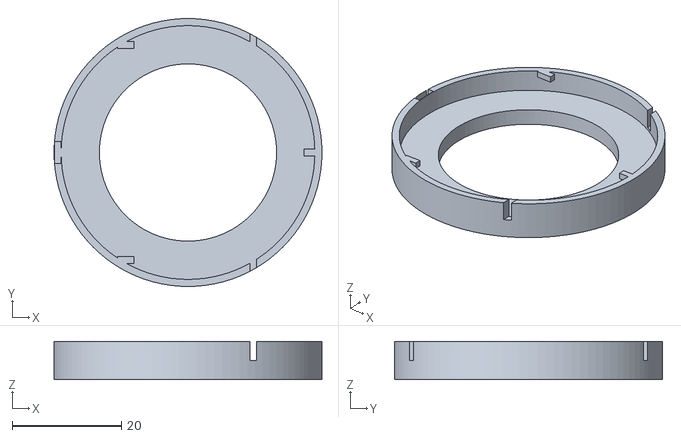
[picture p6: CAD file, 2026-10-04]
bodies/scout/stl/scout-face_bezel-x1.stl
49.0 x 49.0 x 7.00
