Meckie-AI/meckie-bodies/bodies/biped-mini/stl/biped-mini-ankle_bracket_R-x1.stl

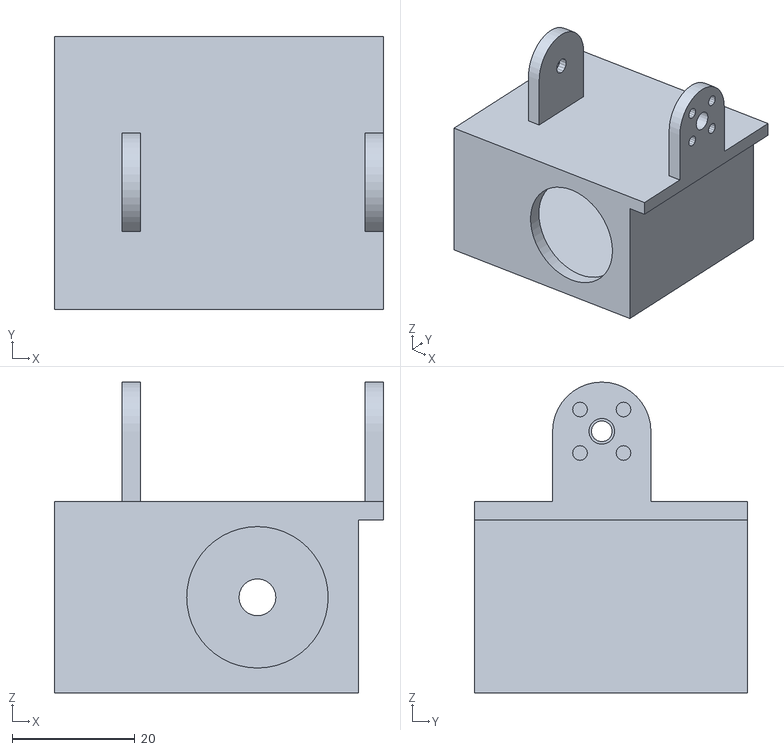
[picture p7: CAD file, 2026-10-04]
bodies/biped-mini/stl/biped-mini-ankle_bracket_R-x1.stl
53.5 x 44.4 x 50.5
