Meckie-AI/meckie-bodies/bodies/comet/stl/comet-battery_cradle-x1.stl

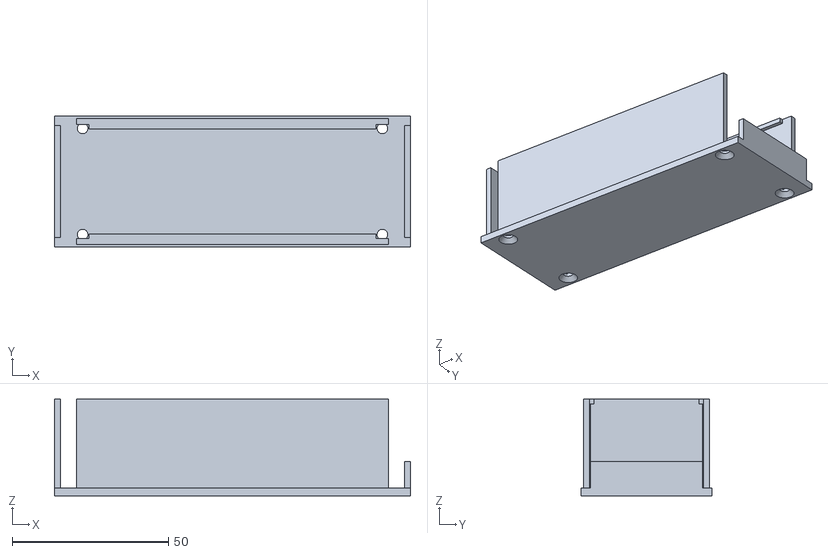
[picture p8: CAD file, 2026-10-06]
bodies/comet/stl/comet-battery_cradle-x1.stl
114.0 x 42.0 x 31.0
