Meckie-AI/meckie-bodies/bodies/dial/stl/dial-yoke-x1.stl

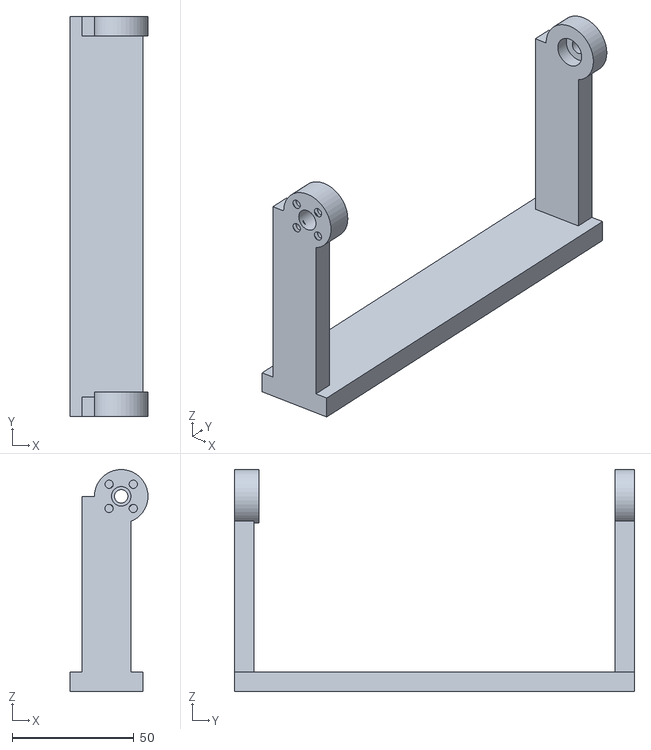
[picture p9: CAD file, 2026-10-04]
bodies/dial/stl/dial-yoke-x1.stl
32.0 x 164.0 x 91.0
