Meckie-AI/meckie-bodies/bodies/inchworm/stl/inchworm-camera_hood-x1.stl

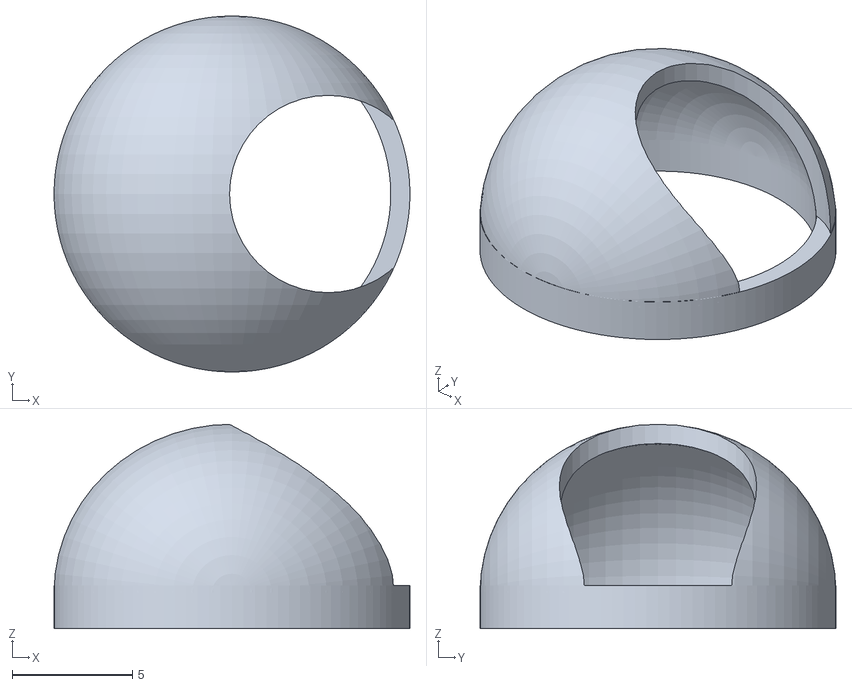
[picture p10: CAD file, 2026-10-04]
bodies/inchworm/stl/inchworm-camera_hood-x1.stl
14.8 x 14.8 x 8.49
