Meckie-AI/meckie-bodies/bodies/lamp/stl/lamp-base_floor-x1.stl

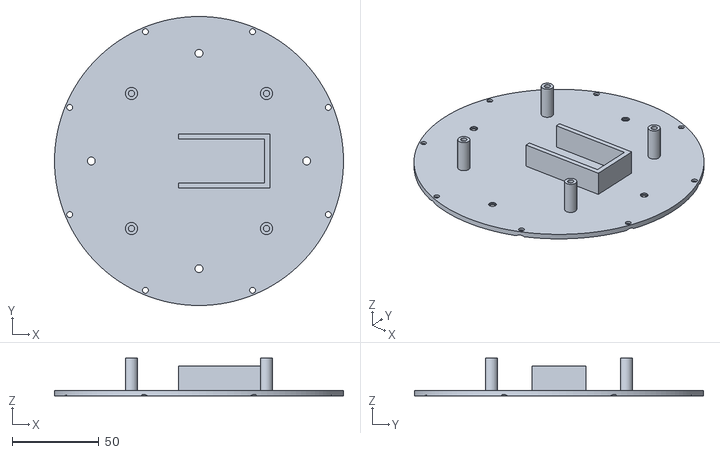
[picture p11: CAD file, 2026-10-04]
bodies/lamp/stl/lamp-base_floor-x1.stl
166.4 x 166.4 x 21.6
