Meckie-AI/meckie-bodies/bodies/scout/stl/scout-bumper_front-x1.stl

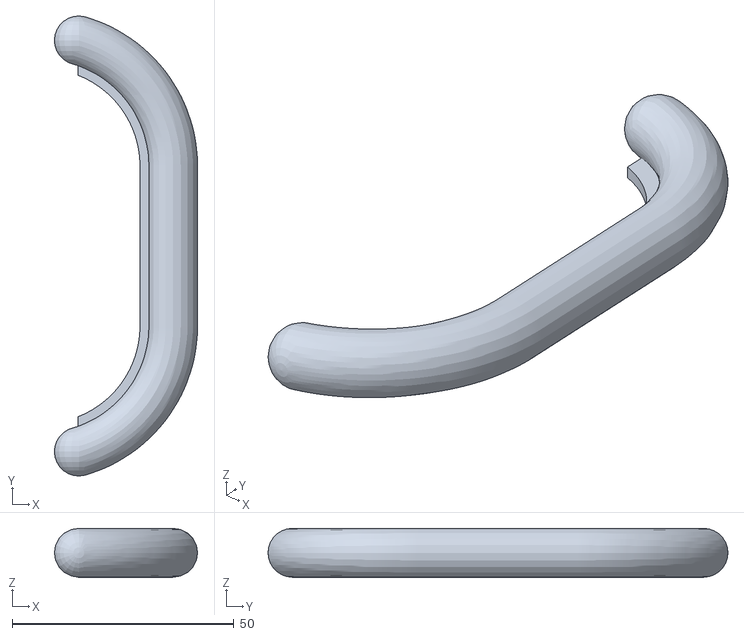
[picture p12: CAD file, 2026-10-04]
bodies/scout/stl/scout-bumper_front-x1.stl
32.3 x 103.7 x 11.1
