Meckie-AI/meckie-bodies/bodies/biped-mini/stl/biped-mini-foot_R-x1.stl

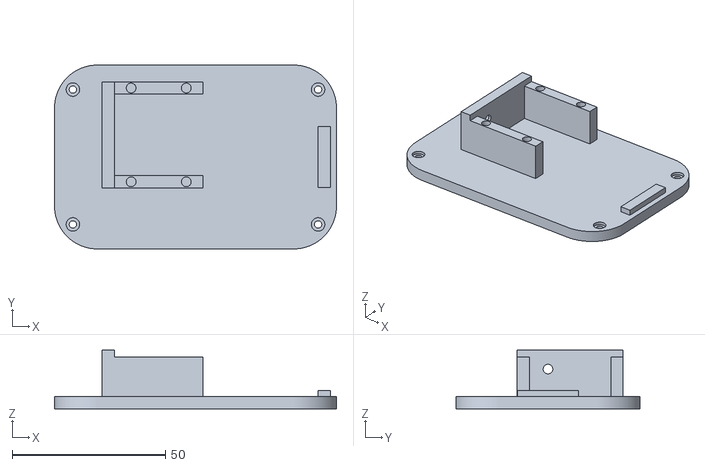
[picture p13: CAD file, 2026-10-04]
bodies/biped-mini/stl/biped-mini-foot_R-x1.stl
92.0 x 60.0 x 19.2
