Meckie-AI/meckie-bodies/bodies/comet/stl/comet-thigh_inner_L-x2.stl

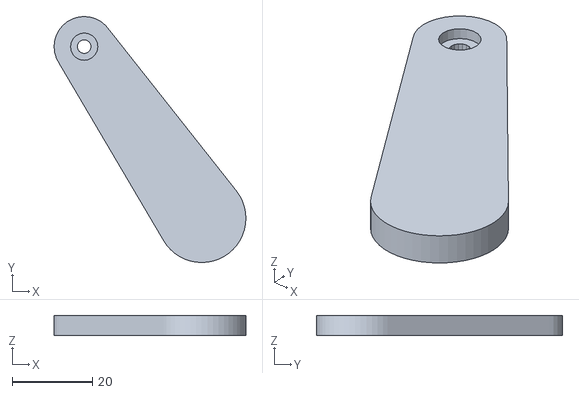
[picture p14: CAD file, 2026-10-06]
bodies/comet/stl/comet-thigh_inner_L-x2.stl
47.7 x 61.2 x 5.00
