Meckie-AI/meckie-bodies/bodies/dial/stl/dial-pan_sleeve_cap-x1.stl

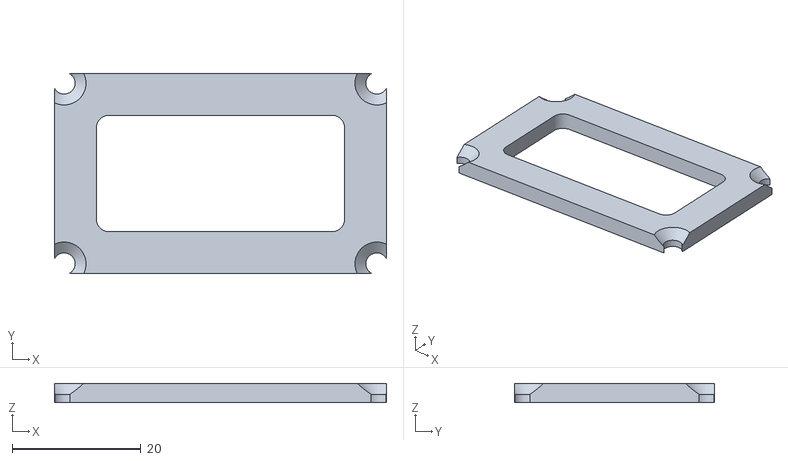
[picture p15: CAD file, 2026-10-04]
bodies/dial/stl/dial-pan_sleeve_cap-x1.stl
51.6 x 31.1 x 3.00
