Meckie-AI/meckie-bodies/bodies/lamp/stl/lamp-knuckle_half-x2.stl

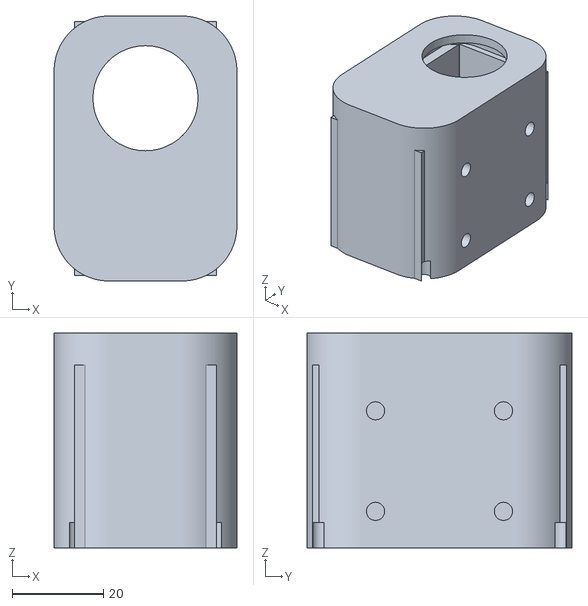
[picture p16: CAD file, 2026-10-04]
bodies/lamp/stl/lamp-knuckle_half-x2.stl
40.0 x 58.0 x 47.0
