Meckie-AI/meckie-bodies/bodies/rover-lite/stl/rover-lite-hull-x1.stl

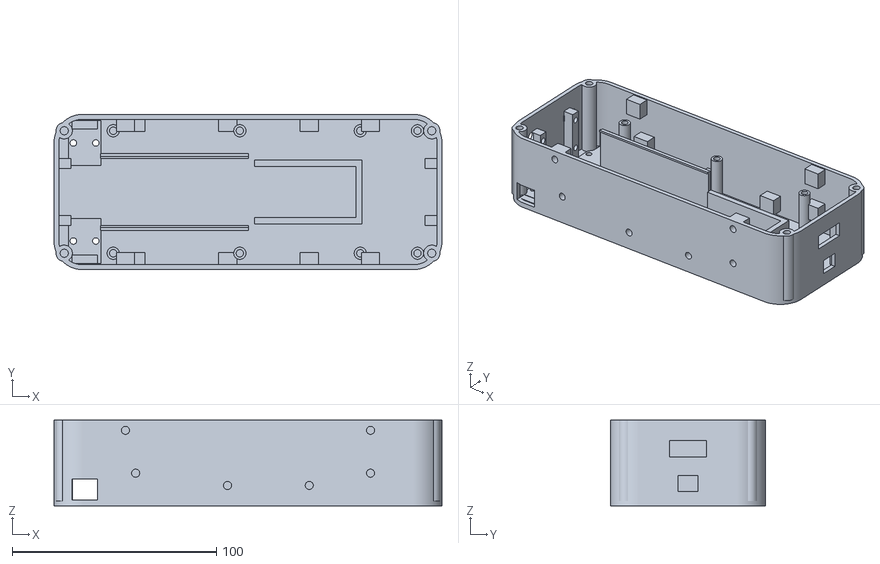
[picture p17: CAD file, 2026-10-04]
bodies/rover-lite/stl/rover-lite-hull-x1.stl
190.0 x 76.0 x 42.0
