Meckie-AI/meckie-bodies/bodies/comet/stl/comet-fender_pod-x4.stl

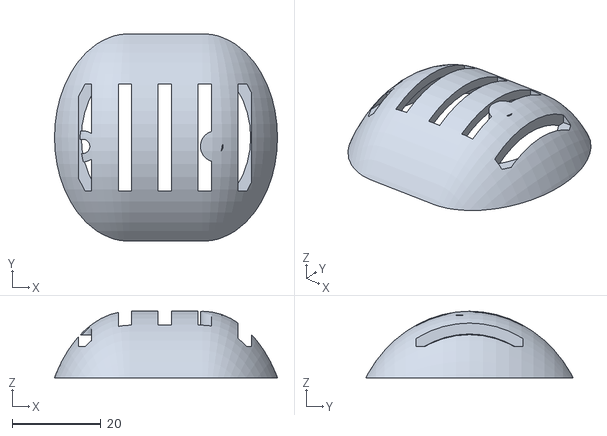
[picture p18: CAD file, 2026-10-06]
bodies/comet/stl/comet-fender_pod-x4.stl
50.2 x 46.7 x 15.0
