Meckie-AI/meckie-bodies/bodies/dial/stl/dial-front_shell-x1.stl

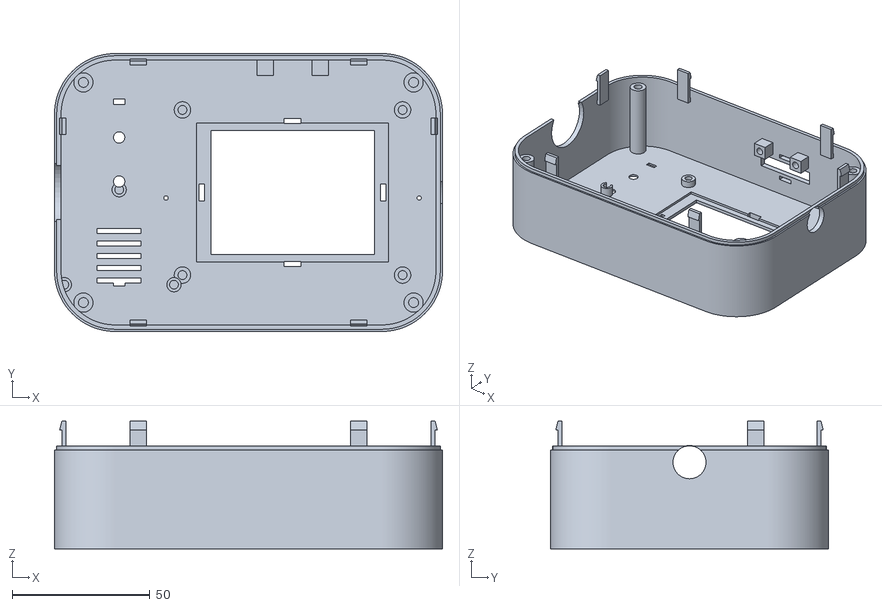
[picture p19: CAD file, 2026-10-04]
bodies/dial/stl/dial-front_shell-x1.stl
141.0 x 101.0 x 46.5
