Meckie-AI/meckie-bodies/bodies/inchworm/stl/inchworm-head_front-x1.stl

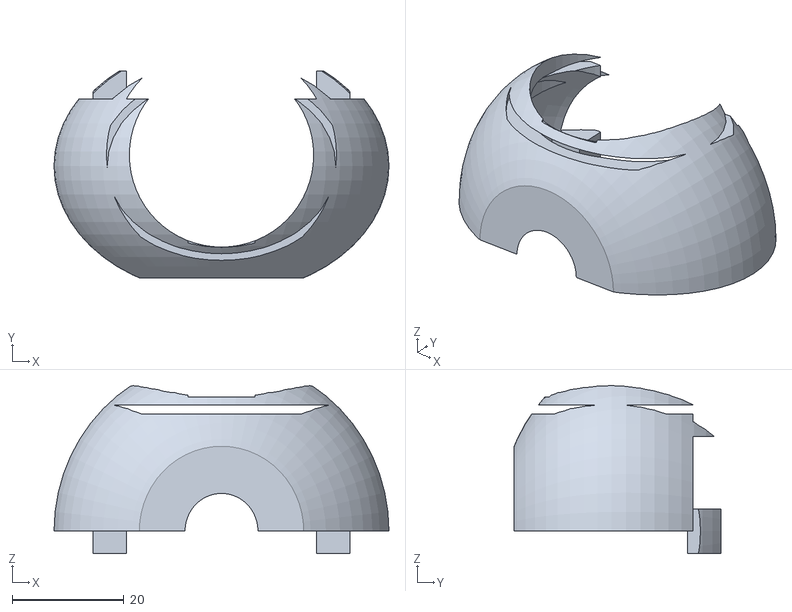
[picture p20: CAD file, 2026-10-04]
bodies/inchworm/stl/inchworm-head_front-x1.stl
60.0 x 37.0 x 30.1
