Meckie-AI/meckie-bodies/bodies/lamp/stl/lamp-base_shell-x1.stl

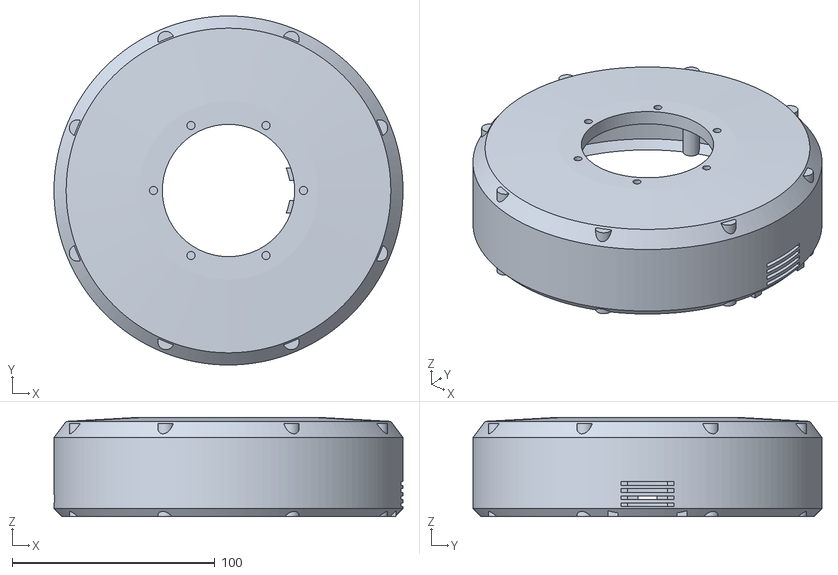
[picture p21: CAD file, 2026-10-04]
bodies/lamp/stl/lamp-base_shell-x1.stl
172.0 x 172.0 x 49.0
