Meckie-AI/meckie-bodies/bodies/rover-lite/stl/rover-lite-fin-x1.stl

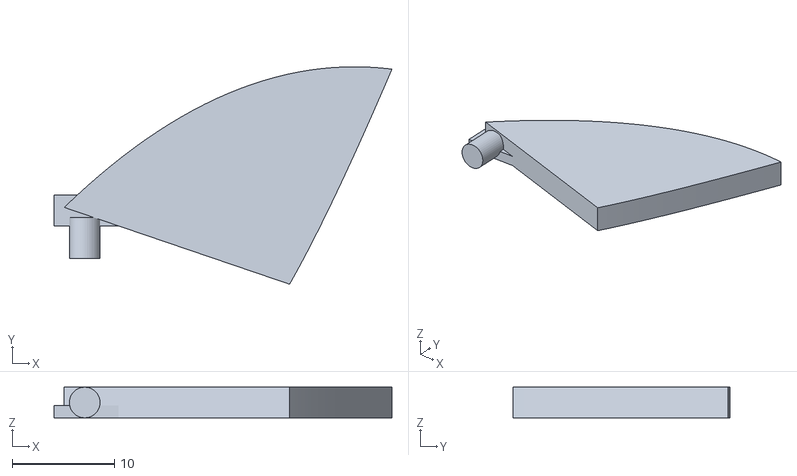
[picture p22: CAD file, 2026-10-04]
bodies/rover-lite/stl/rover-lite-fin-x1.stl
33.0 x 21.2 x 3.00
