Meckie-AI/meckie-bodies/bodies/comet/stl/comet-tail_mount-x1.stl

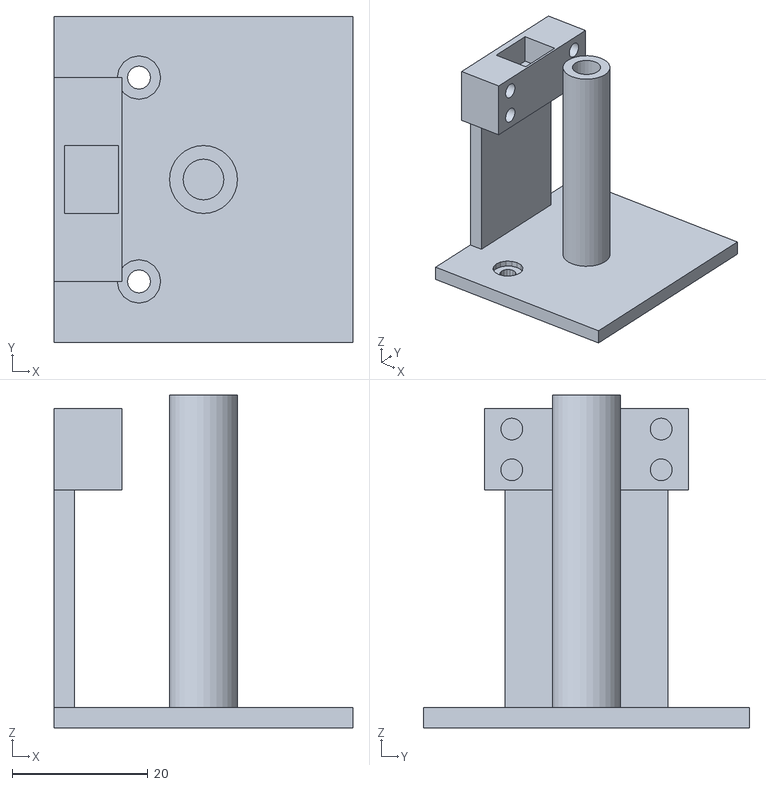
[picture p23: CAD file, 2026-10-06]
bodies/comet/stl/comet-tail_mount-x1.stl
44.0 x 48.0 x 49.0
