Meckie-AI/meckie-bodies/bodies/dial/stl/dial-tilt_sleeve-x1.stl

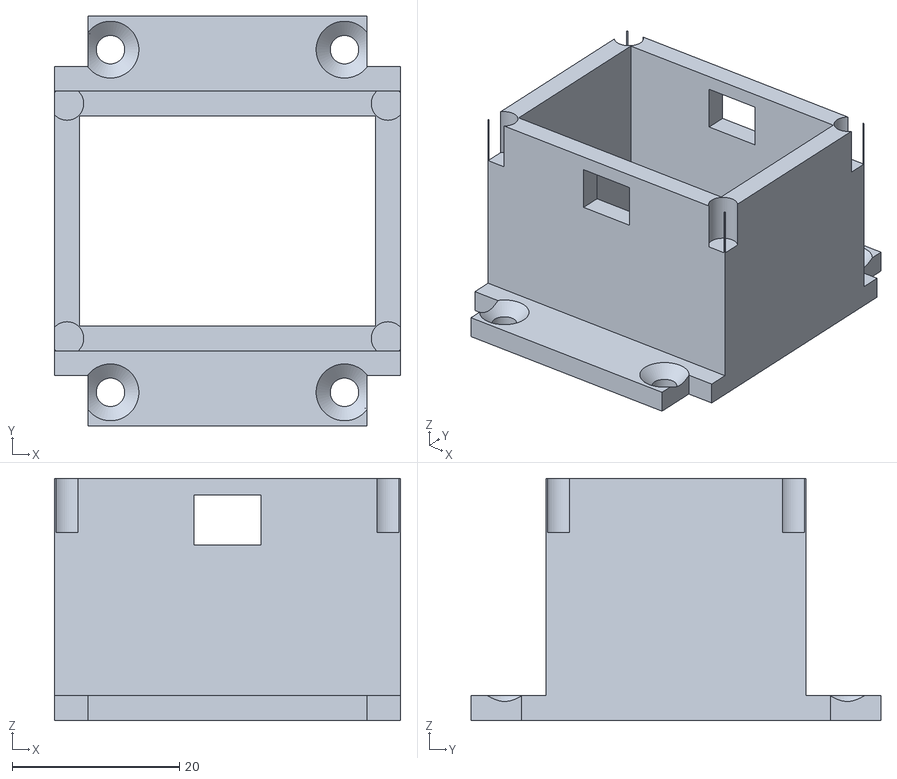
[picture p24: CAD file, 2026-10-04]
bodies/dial/stl/dial-tilt_sleeve-x1.stl
41.4 x 49.0 x 29.0
