Meckie-AI/meckie-bodies/bodies/inchworm/stl/inchworm-base_dome-x1.stl

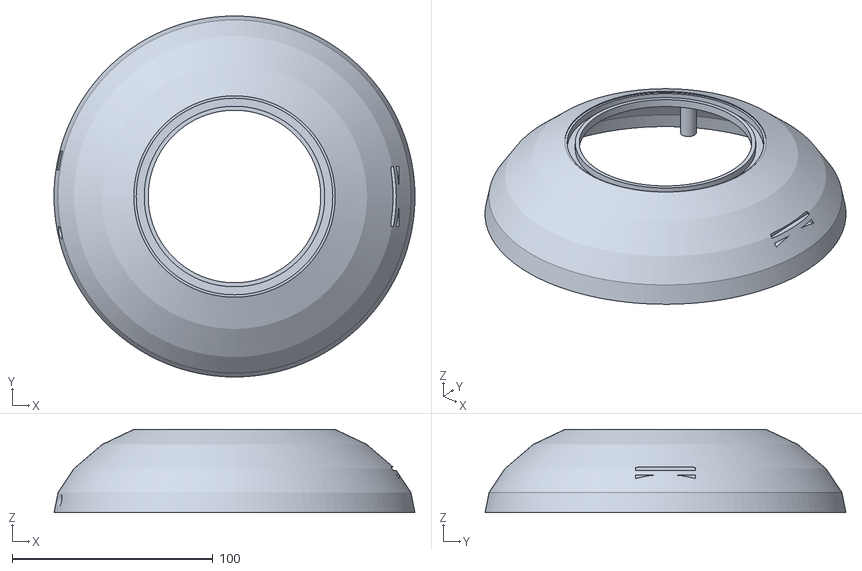
[picture p25: CAD file, 2026-10-04]
bodies/inchworm/stl/inchworm-base_dome-x1.stl
180.0 x 180.0 x 41.5
