Meckie-AI/meckie-bodies/bodies/lamp/stl/lamp-turret-x1.stl

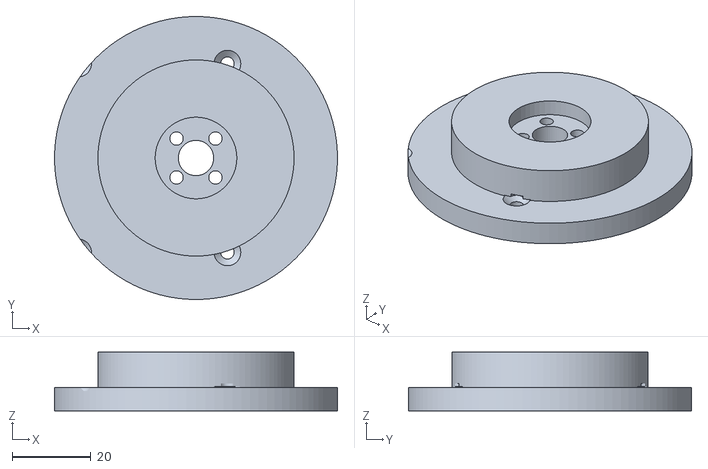
[picture p26: CAD file, 2026-10-04]
bodies/lamp/stl/lamp-turret-x1.stl
72.0 x 72.0 x 15.0
