Meckie-AI/meckie-bodies/bodies/rover-lite/stl/rover-lite-yoke-x1.stl

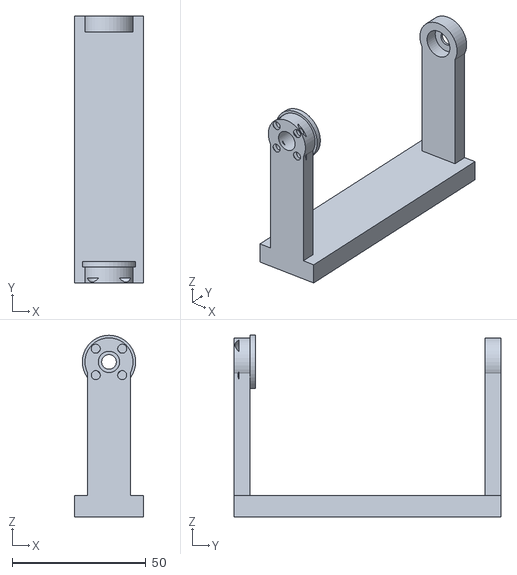
[picture p27: CAD file, 2026-10-04]
bodies/rover-lite/stl/rover-lite-yoke-x1.stl
26.0 x 100.0 x 68.0
