Meckie-AI/meckie-bodies/bodies/wobble/stl/wobble-belly-x1.stl

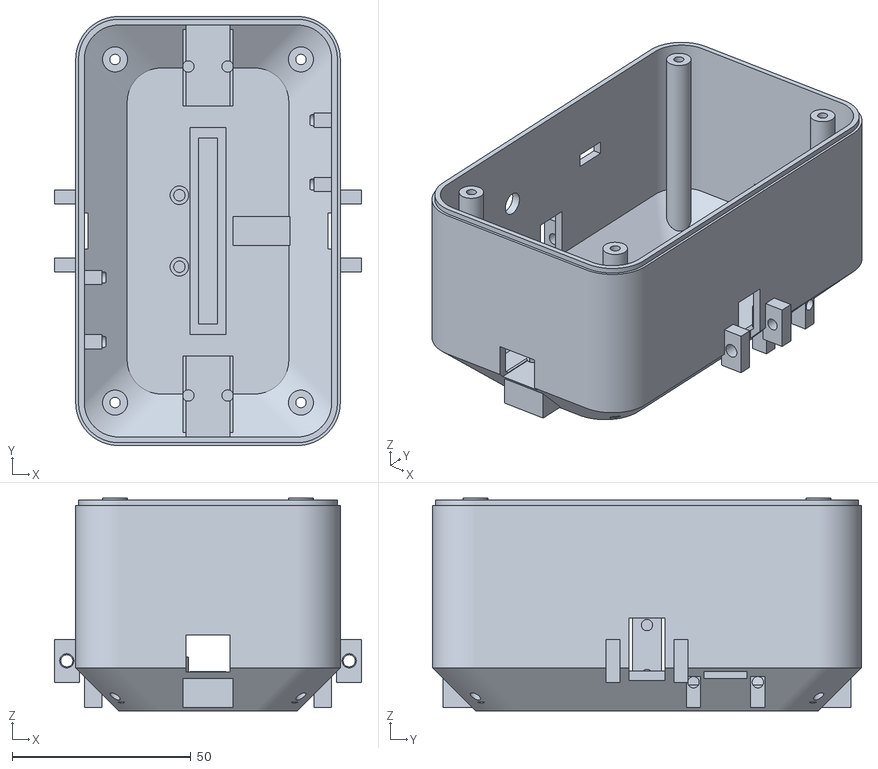
[picture p28: CAD file, 2026-10-04]
bodies/wobble/stl/wobble-belly-x1.stl
86.0 x 120.0 x 59.5
