Meckie-AI/meckie-bodies/bodies/comet/stl/comet-antenna-x1.stl

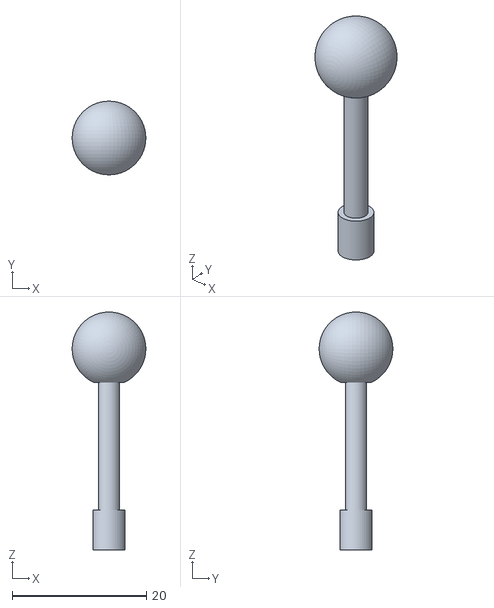
[picture p29: CAD file, 2026-10-06]
bodies/comet/stl/comet-antenna-x1.stl
11.0 x 11.0 x 35.5
