Meckie-AI/meckie-bodies/bodies/dial/stl/dial-tilt_sleeve_cap-x1.stl

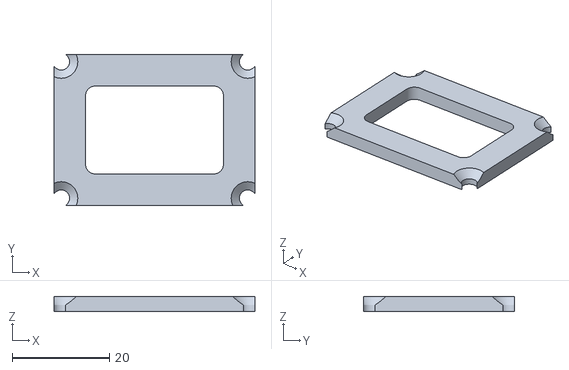
[picture p30: CAD file, 2026-10-04]
bodies/dial/stl/dial-tilt_sleeve_cap-x1.stl
41.4 x 31.1 x 3.00
