Meckie-AI/meckie-bodies/bodies/lamp/stl/lamp-finial-x1.stl

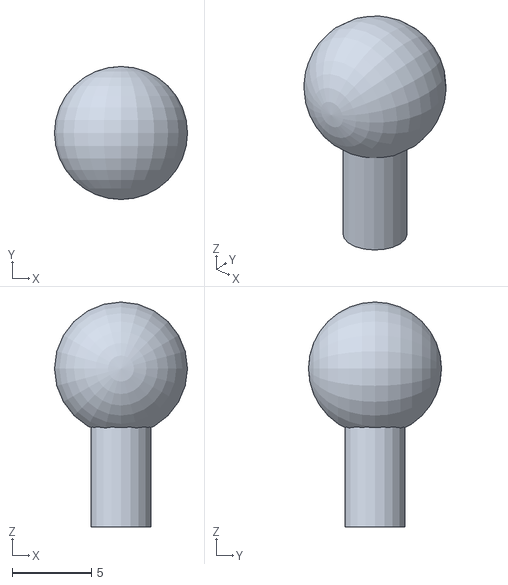
[picture p32: CAD file, 2026-10-04]
bodies/lamp/stl/lamp-finial-x1.stl
8.40 x 8.40 x 14.2
