Meckie-AI/meckie-bodies/bodies/rover-lite/stl/rover-lite-display_retainer-x1.stl

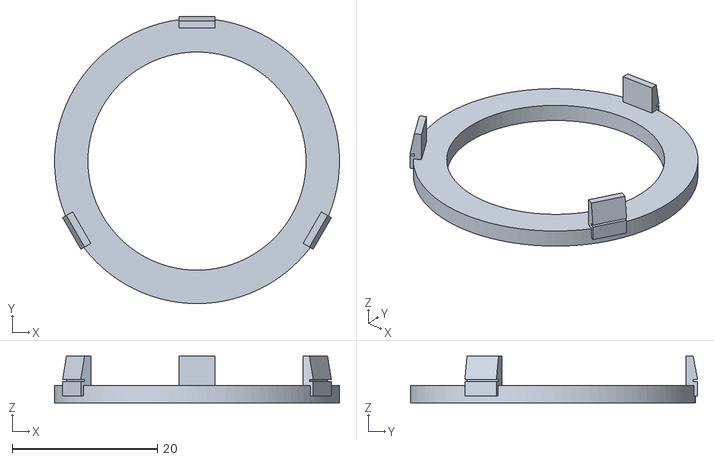
[picture p33: CAD file, 2026-10-04]
bodies/rover-lite/stl/rover-lite-display_retainer-x1.stl
39.2 x 39.5 x 6.40
