Meckie-AI/meckie-bodies/bodies/scout/stl/scout-ear-x2.stl

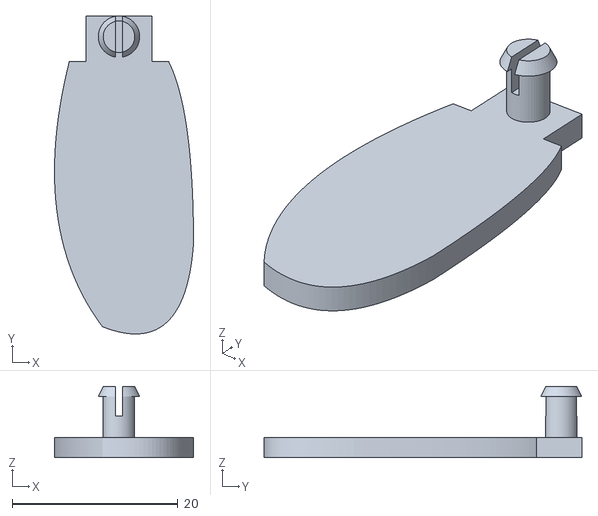
[picture p34: CAD file, 2026-10-04]
bodies/scout/stl/scout-ear-x2.stl
16.8 x 38.4 x 8.60
