Meckie-AI/meckie-bodies/bodies/wobble/stl/wobble-hubcap-x2.stl

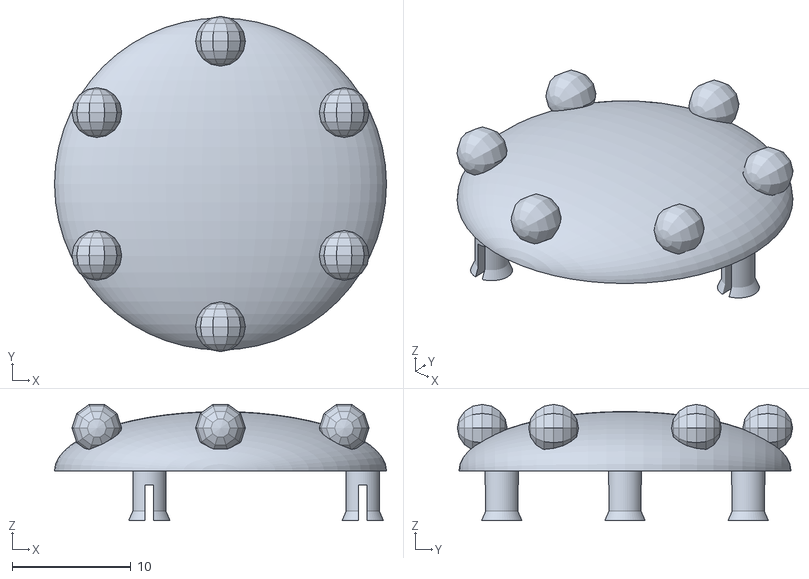
[picture p35: CAD file, 2026-10-04]
bodies/wobble/stl/wobble-hubcap-x2.stl
28.0 x 28.3 x 9.80
