Meckie-AI/meckie-bodies/bodies/biped-mini/stl/biped-mini-thigh_L-x1.stl

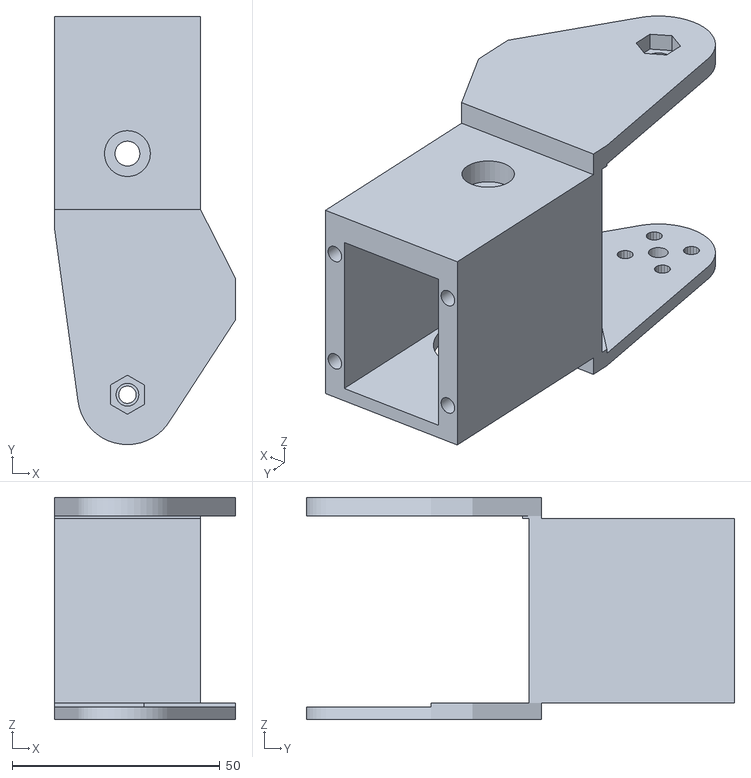
[picture p36: CAD file, 2026-10-04]
bodies/biped-mini/stl/biped-mini-thigh_L-x1.stl
43.5 x 103.0 x 53.4
