Meckie-AI/meckie-bodies/bodies/comet/stl/comet-board_cradle_L-x1.stl

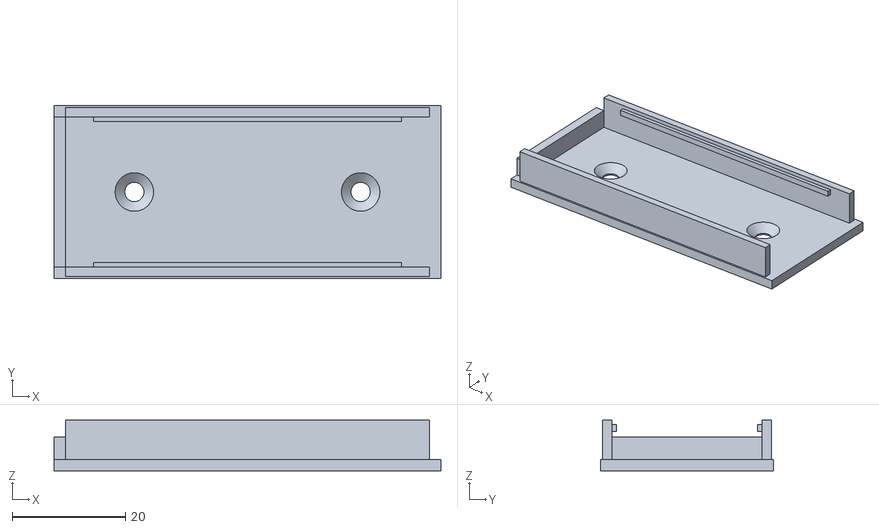
[picture p37: CAD file, 2026-10-06]
bodies/comet/stl/comet-board_cradle_L-x1.stl
68.4 x 30.6 x 9.00
