Meckie-AI/meckie-bodies/bodies/dial/stl/dial-battery_hatch-x1.stl

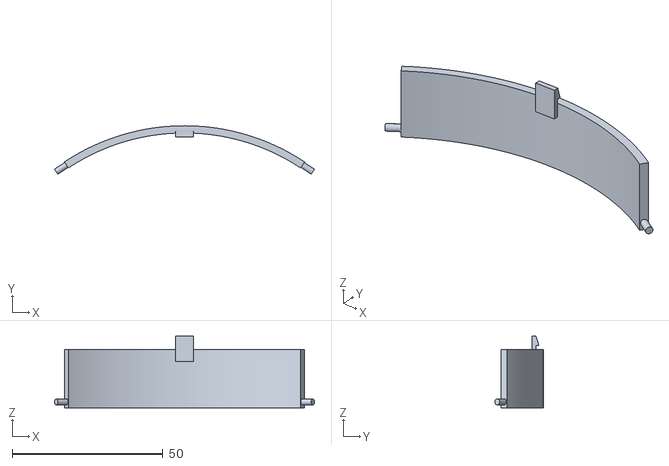
[picture p38: CAD file, 2026-10-04]
bodies/dial/stl/dial-battery_hatch-x1.stl
86.1 x 16.1 x 23.8
