Meckie-AI/meckie-bodies/bodies/lamp/stl/lamp-drive_crank-x1.stl

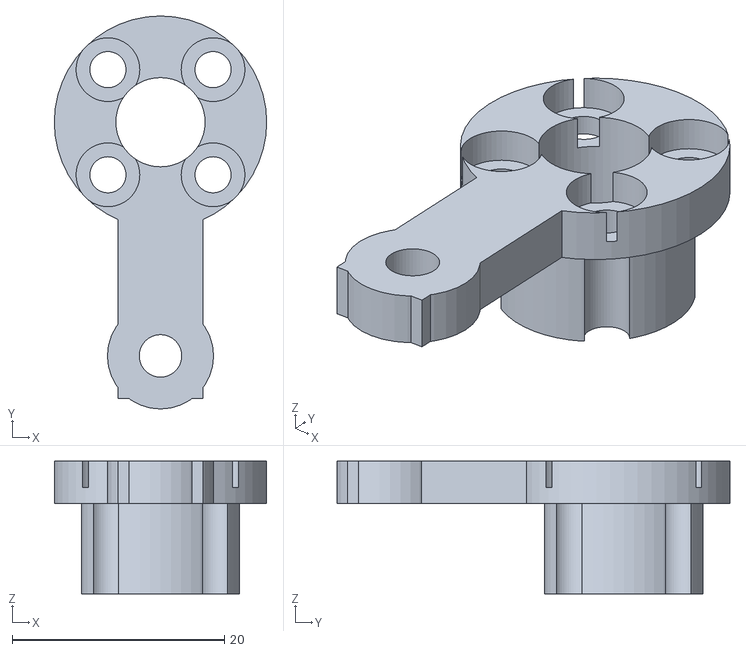
[picture p39: CAD file, 2026-10-04]
bodies/lamp/stl/lamp-drive_crank-x1.stl
20.0 x 37.0 x 12.5
