Meckie-AI/meckie-bodies/bodies/rover-lite/stl/rover-lite-drum_cap_right-x1.stl

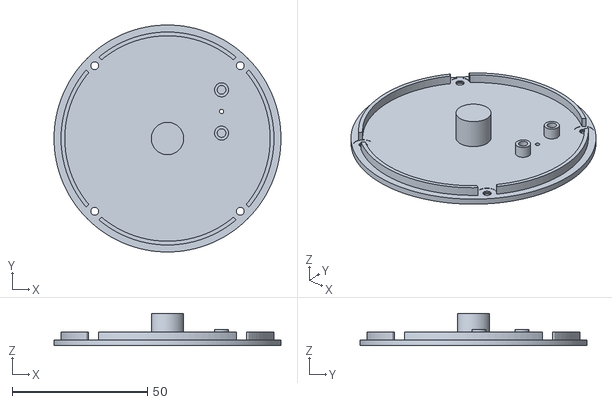
[picture p40: CAD file, 2026-10-04]
bodies/rover-lite/stl/rover-lite-drum_cap_right-x1.stl
84.0 x 84.0 x 11.9
