Meckie-AI/meckie-bodies/bodies/scout/stl/scout-upper_shell-x1.stl

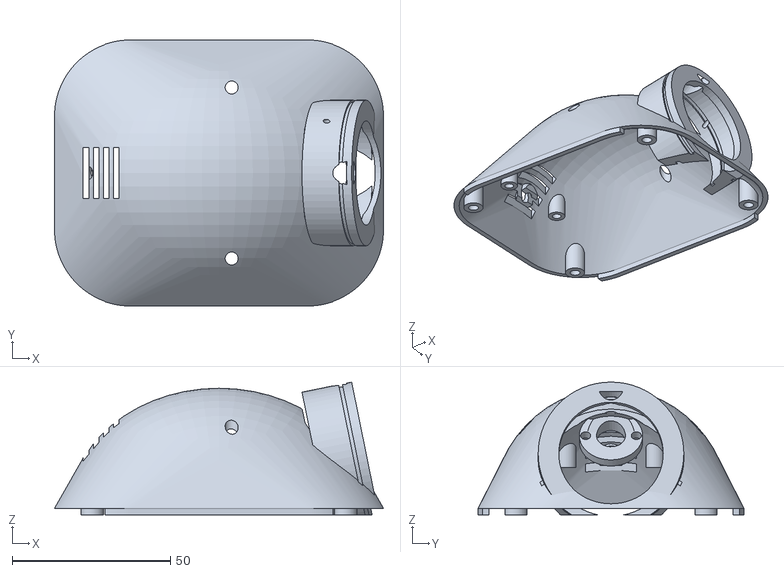
[picture p41: CAD file, 2026-10-04]
bodies/scout/stl/scout-upper_shell-x1.stl
103.9 x 84.0 x 41.9
