Meckie-AI/meckie-bodies/bodies/wobble/stl/wobble-spine-x1.stl

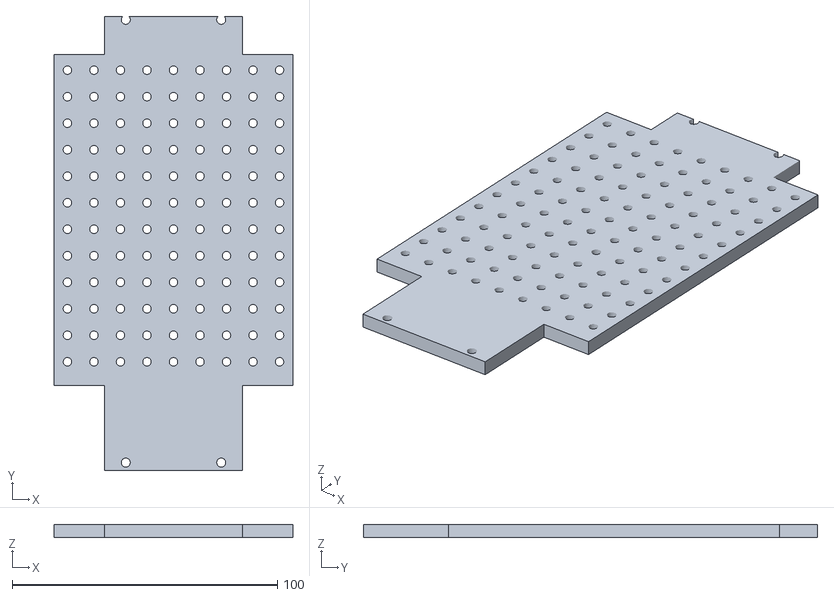
[picture p42: CAD file, 2026-10-04]
bodies/wobble/stl/wobble-spine-x1.stl
90.0 x 171.2 x 5.00
