Meckie-AI/meckie-bodies/bodies/dial/stl/dial-lcd_retainer-x1.stl

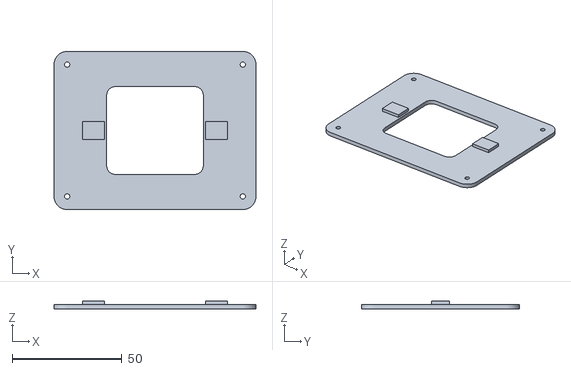
[picture p43: CAD file, 2026-10-04]
bodies/dial/stl/dial-lcd_retainer-x1.stl
92.0 x 72.0 x 3.50
