Meckie-AI/meckie-bodies/bodies/lamp/stl/lamp-face_bezel-x1.stl

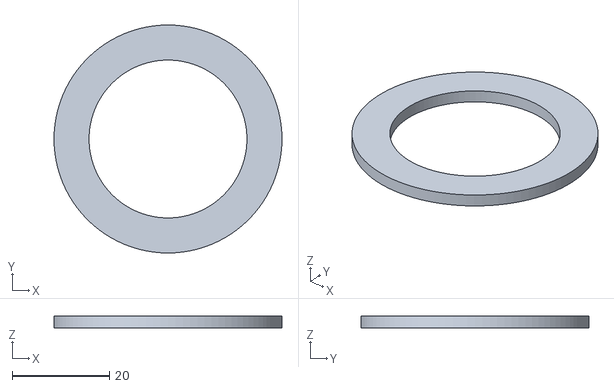
[picture p44: CAD file, 2026-10-04]
bodies/lamp/stl/lamp-face_bezel-x1.stl
46.8 x 46.8 x 2.40
