Meckie-AI/meckie-bodies/bodies/rover-lite/stl/rover-lite-tilt_cap-x1.stl

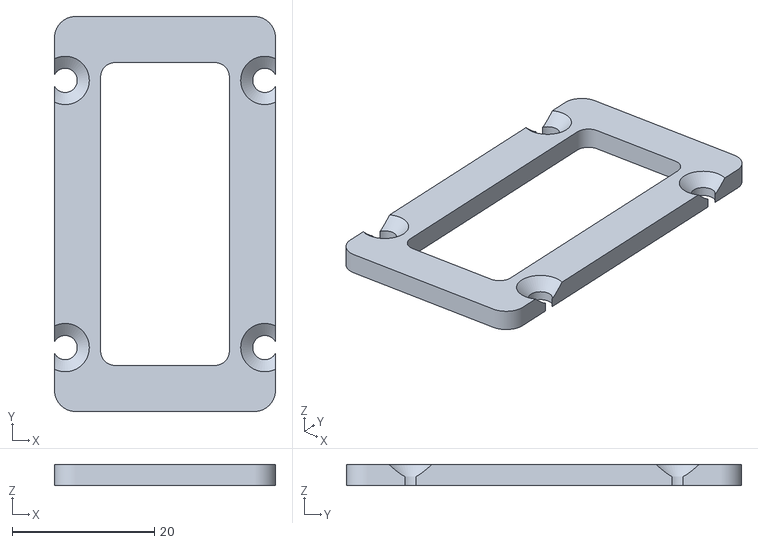
[picture p45: CAD file, 2026-10-04]
bodies/rover-lite/stl/rover-lite-tilt_cap-x1.stl
31.1 x 55.6 x 3.00
