Meckie-AI/meckie-bodies/bodies/scout/stl/scout-speaker_ring-x1.stl

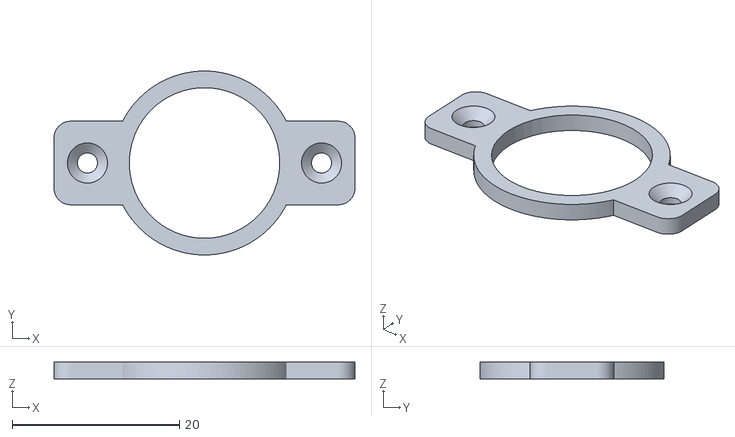
[picture p46: CAD file, 2026-10-04]
bodies/scout/stl/scout-speaker_ring-x1.stl
36.0 x 22.0 x 2.00
