Meckie-AI/meckie-bodies/bodies/wobble/stl/wobble-leg_foot-x2.stl

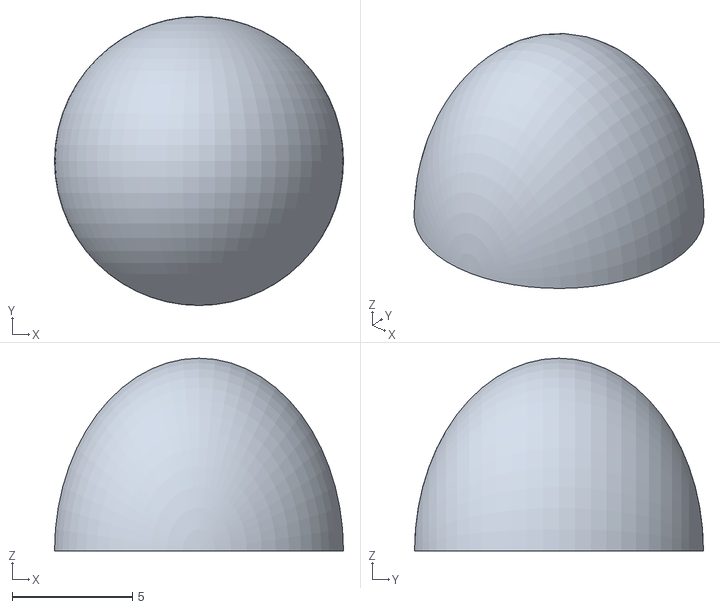
[picture p47: CAD file, 2026-10-04]
bodies/wobble/stl/wobble-leg_foot-x2.stl
12.0 x 12.0 x 8.00
