Meckie-AI/meckie-bodies/bodies/biped-mini/stl/biped-mini-tail_skid-x1.stl

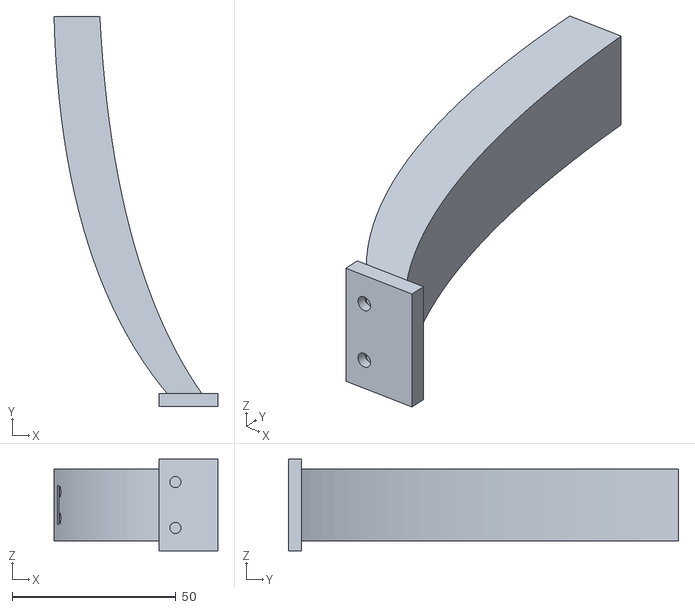
[picture p48: CAD file, 2026-10-04]
bodies/biped-mini/stl/biped-mini-tail_skid-x1.stl
50.0 x 119.0 x 28.0
