Meckie-AI/meckie-bodies/bodies/comet/stl/comet-thigh_outer_L-x2.stl

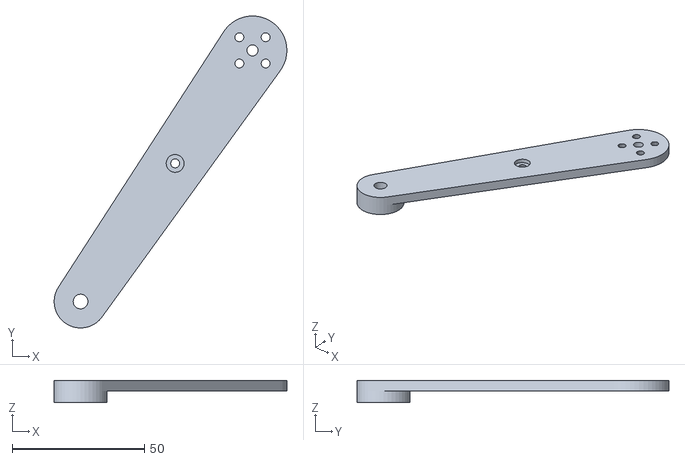
[picture p49: CAD file, 2026-10-06]
bodies/comet/stl/comet-thigh_outer_L-x2.stl
88.0 x 117.9 x 8.40
