Meckie-AI/meckie-bodies/bodies/dial/stl/dial-tpu_foot-x1.stl

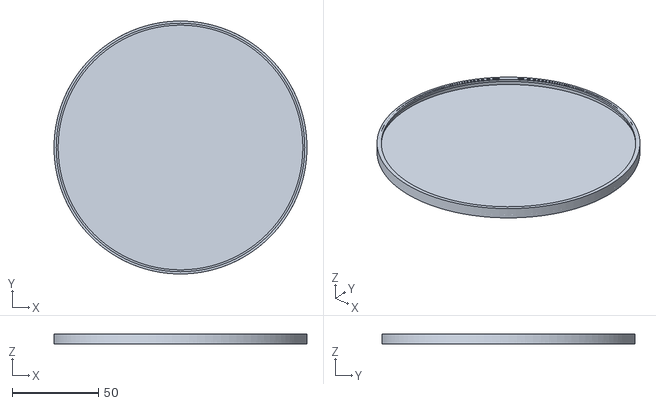
[picture p50: CAD file, 2026-10-04]
bodies/dial/stl/dial-tpu_foot-x1.stl
147.0 x 147.0 x 6.00
