Meckie-AI/meckie-bodies/bodies/lamp/stl/lamp-mic_clamp-x2.stl

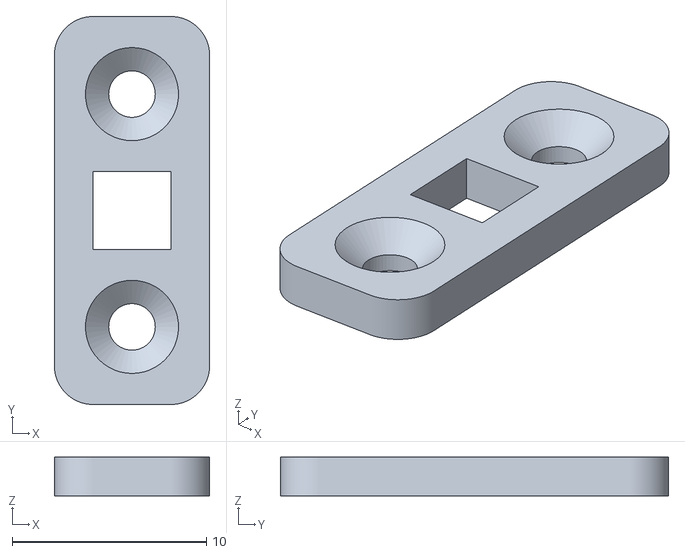
[picture p51: CAD file, 2026-10-04]
bodies/lamp/stl/lamp-mic_clamp-x2.stl
8.00 x 20.0 x 2.00
