Meckie-AI/meckie-bodies/bodies/rover-lite/stl/rover-lite-mic_clamp-x2.stl

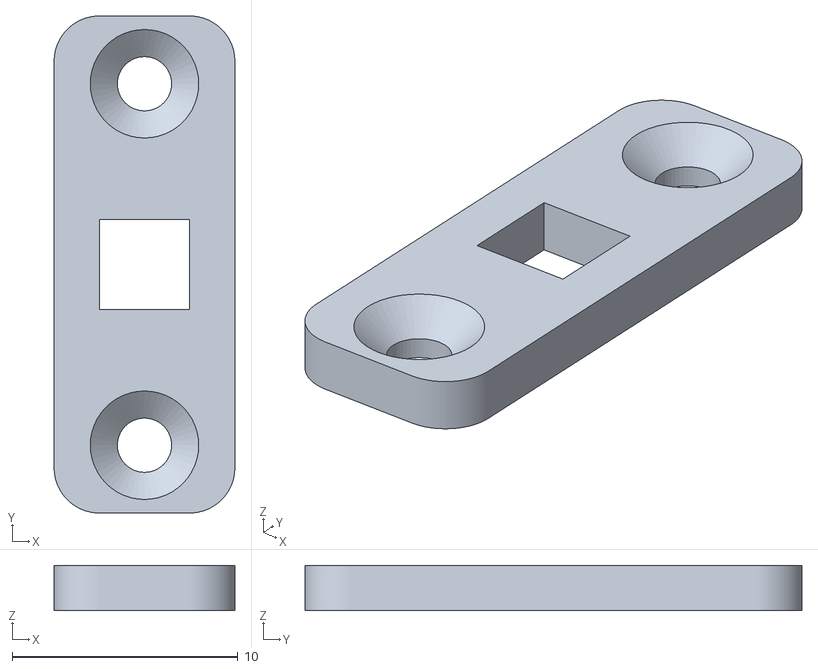
[picture p52: CAD file, 2026-10-04]
bodies/rover-lite/stl/rover-lite-mic_clamp-x2.stl
8.00 x 22.0 x 2.00
