Meckie-AI/meckie-bodies/bodies/scout/stl/scout-motor_strap-x2.stl

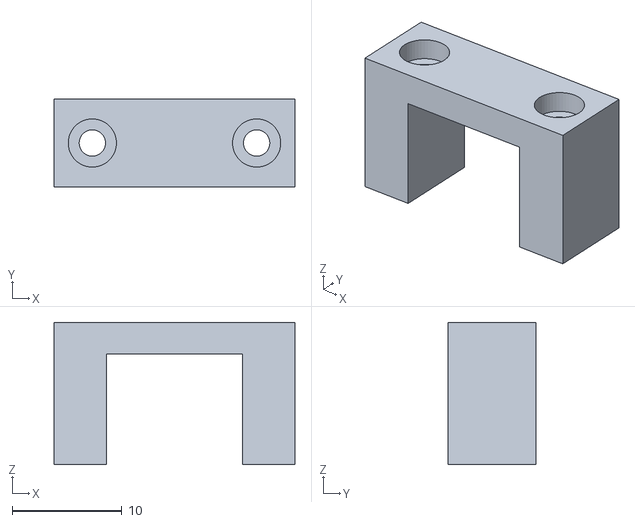
[picture p53: CAD file, 2026-10-04]
bodies/scout/stl/scout-motor_strap-x2.stl
22.0 x 8.00 x 13.0
