Meckie-AI/meckie-bodies/bodies/wobble/stl/wobble-band-x2.stl

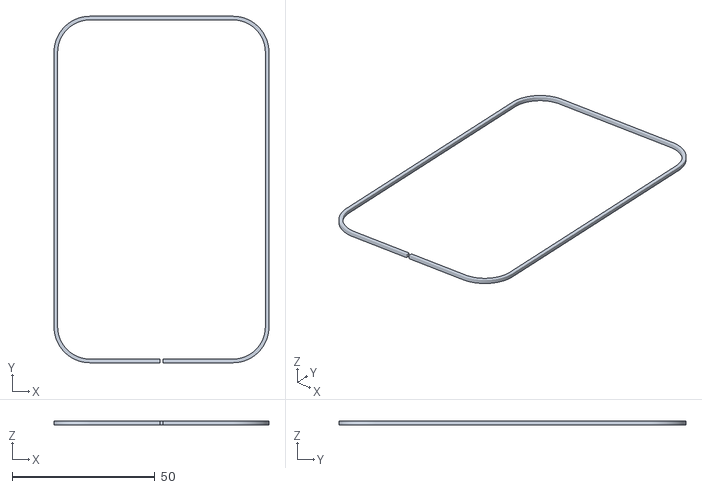
[picture p54: CAD file, 2026-10-04]
bodies/wobble/stl/wobble-band-x2.stl
75.2 x 121.2 x 1.40
