Meckie-AI/meckie-bodies/bodies/biped-mini/stl/biped-mini-mitt-x2.stl

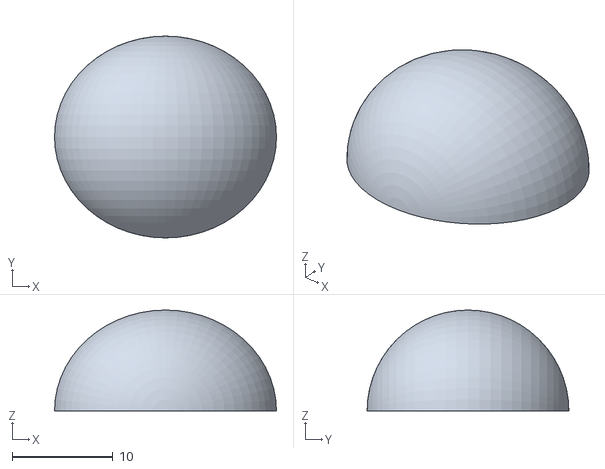
[picture p55: CAD file, 2026-10-04]
bodies/biped-mini/stl/biped-mini-mitt-x2.stl
22.0 x 20.0 x 10.0
