Meckie-AI/meckie-bodies/bodies/comet/stl/comet-brow_lamp-x2.stl

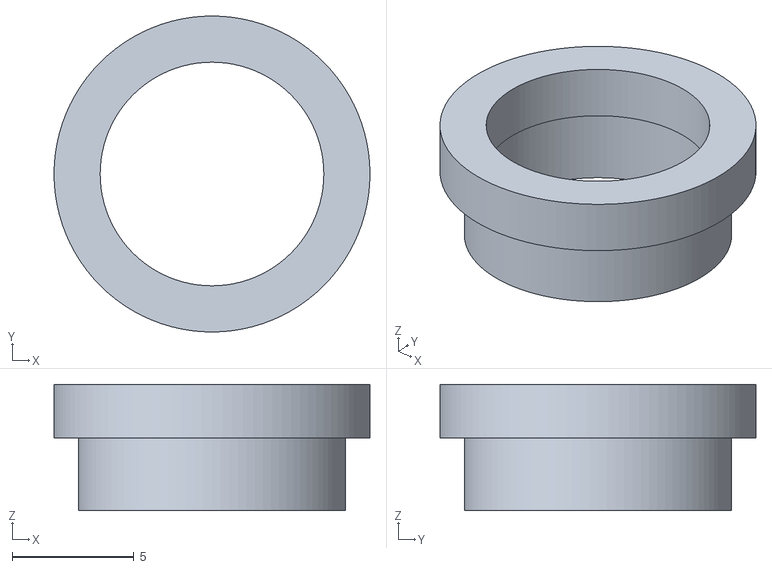
[picture p56: CAD file, 2026-10-06]
bodies/comet/stl/comet-brow_lamp-x2.stl
13.0 x 13.0 x 5.20
