Meckie-AI/meckie-bodies/bodies/dial/stl/dial-knob_panel-x1.stl

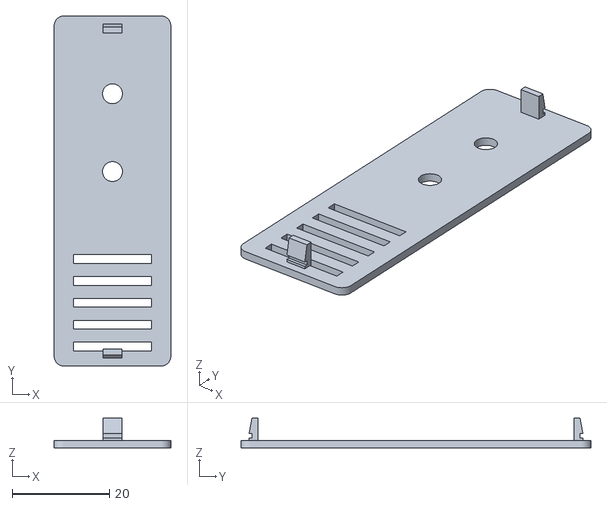
[picture p57: CAD file, 2026-10-04]
bodies/dial/stl/dial-knob_panel-x1.stl
24.0 x 72.0 x 6.10
