Meckie-AI/meckie-bodies/bodies/inchworm/stl/inchworm-link4_ribs-x2.stl

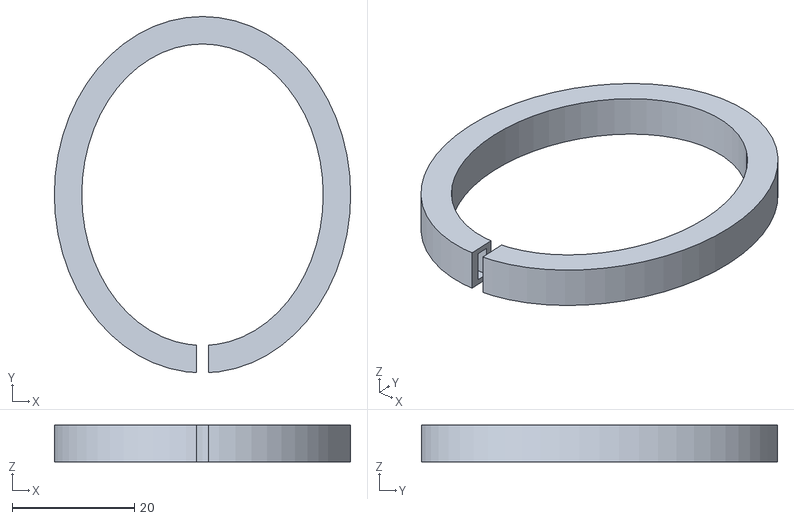
[picture p58: CAD file, 2026-10-04]
bodies/inchworm/stl/inchworm-link4_ribs-x2.stl
48.6 x 58.3 x 6.00
