Meckie-AI/meckie-bodies/bodies/lamp/stl/lamp-tray-x1.stl

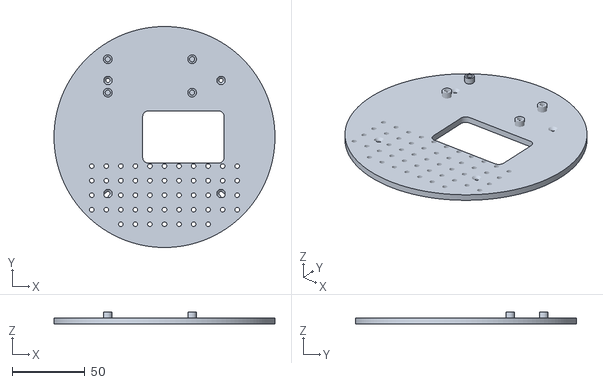
[picture p59: CAD file, 2026-10-04]
bodies/lamp/stl/lamp-tray-x1.stl
152.0 x 152.0 x 8.00
