Meckie-AI/meckie-bodies/bodies/rover-lite/stl/rover-lite-camera_plate-x1.stl

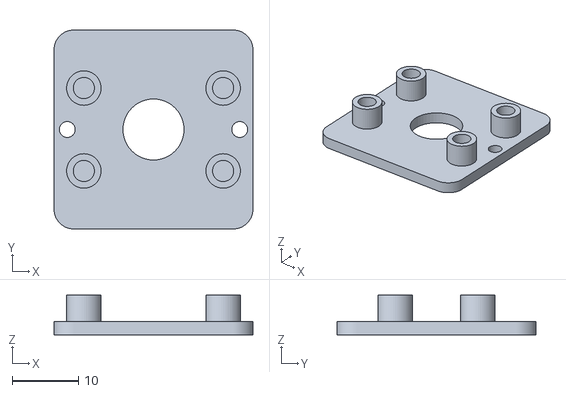
[picture p60: CAD file, 2026-10-04]
bodies/rover-lite/stl/rover-lite-camera_plate-x1.stl
30.0 x 30.0 x 6.00
