Meckie-AI/meckie-bodies/bodies/wobble/stl/wobble-battery_cradle-x1.stl

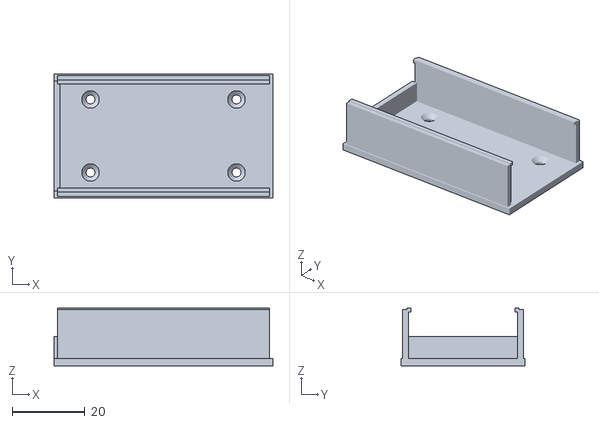
[picture p61: CAD file, 2026-10-04]
bodies/wobble/stl/wobble-battery_cradle-x1.stl
60.0 x 34.0 x 15.8
