Meckie-AI/meckie-bodies/bodies/biped-mini/stl/biped-mini-shin_inner_L-x1.stl

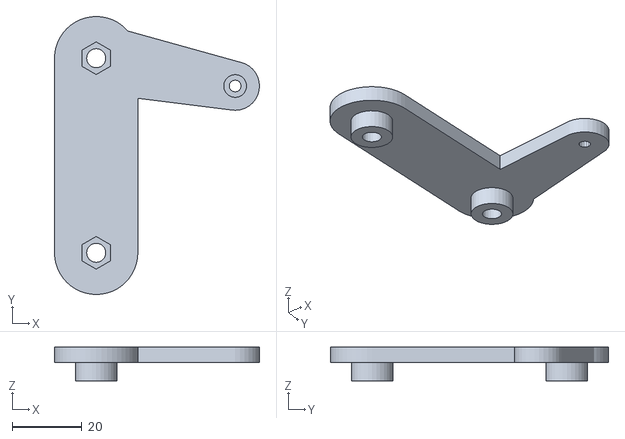
[picture p62: CAD file, 2026-10-04]
bodies/biped-mini/stl/biped-mini-shin_inner_L-x1.stl
59.0 x 80.0 x 9.75
