Meckie-AI/meckie-bodies/bodies/comet/stl/comet-deck_rear-x1.stl

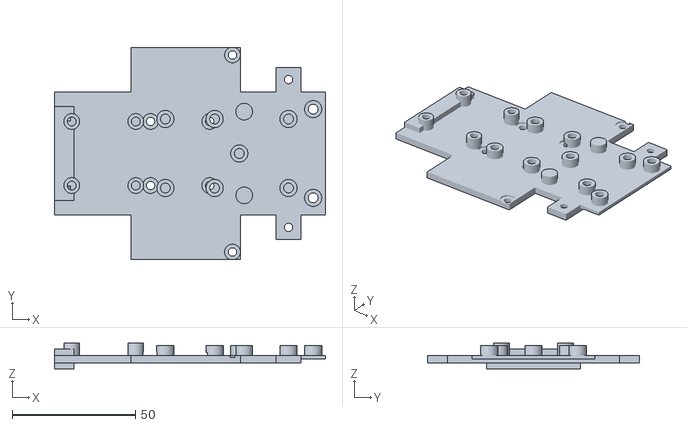
[picture p63: CAD file, 2026-10-06]
bodies/comet/stl/comet-deck_rear-x1.stl
110.0 x 86.0 x 10.5
