Meckie-AI/meckie-bodies/bodies/dial/stl/dial-handle_caps-x2.stl

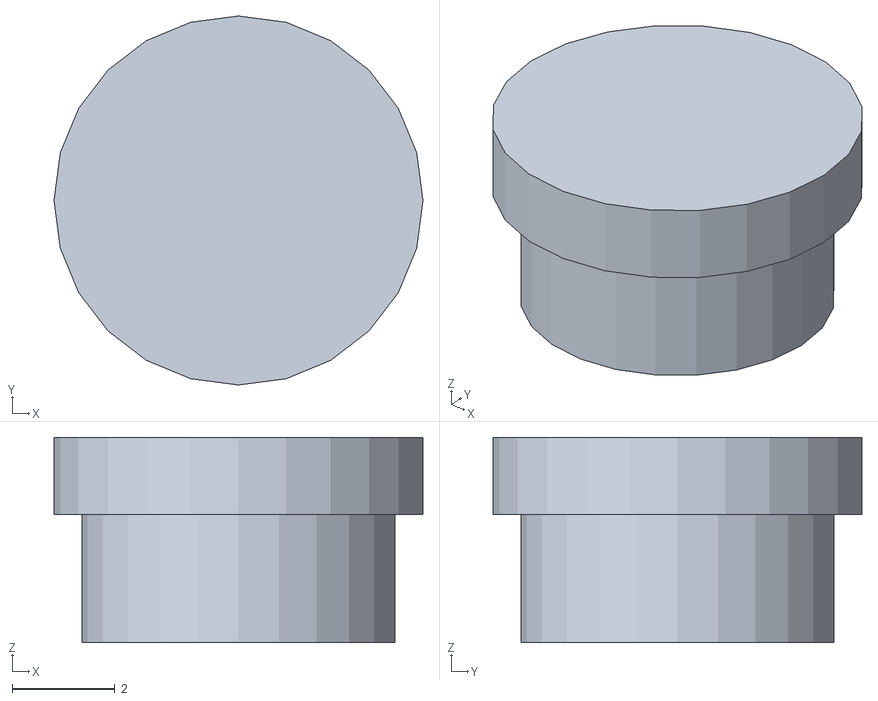
[picture p64: CAD file, 2026-10-04]
bodies/dial/stl/dial-handle_caps-x2.stl
7.20 x 7.20 x 4.00
