Meckie-AI/meckie-bodies/bodies/inchworm/stl/inchworm-j1_cap-x1.stl

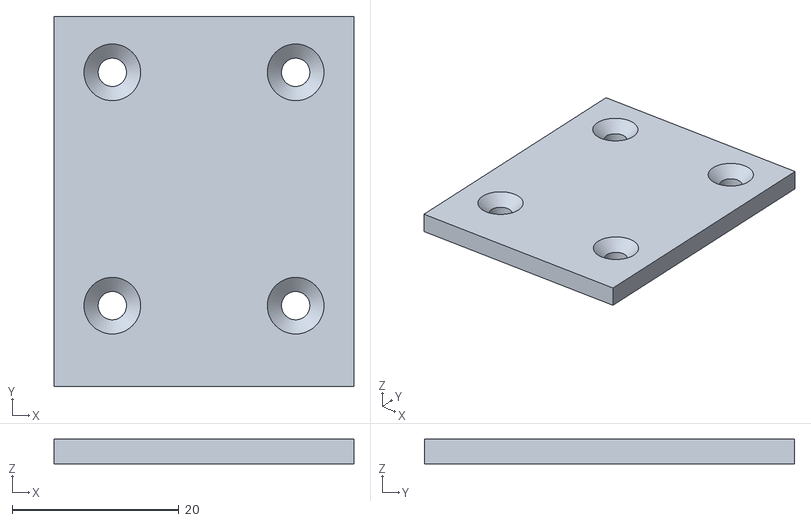
[picture p65: CAD file, 2026-10-04]
bodies/inchworm/stl/inchworm-j1_cap-x1.stl
36.0 x 44.4 x 3.00
