Meckie-AI/meckie-bodies/bodies/lamp/stl/lamp-hood-x1.stl

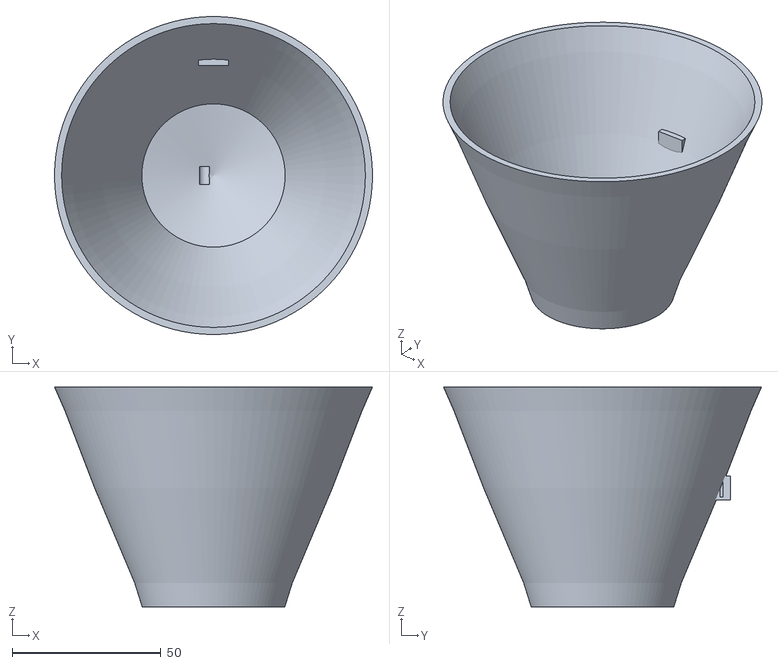
[picture p66: CAD file, 2026-10-04]
bodies/lamp/stl/lamp-hood-x1.stl
107.0 x 107.0 x 74.0
