Meckie-AI/meckie-bodies/bodies/rover-lite/stl/rover-lite-idler-x2.stl

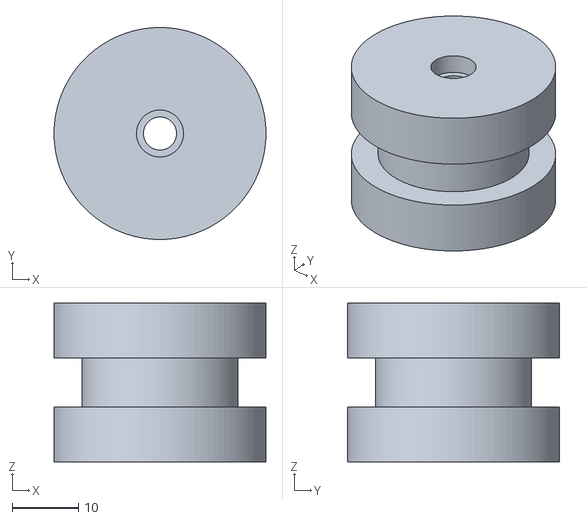
[picture p67: CAD file, 2026-10-04]
bodies/rover-lite/stl/rover-lite-idler-x2.stl
32.0 x 32.0 x 24.0
