Meckie-AI/meckie-bodies/bodies/scout/stl/scout-sensor_clamp-x3.stl

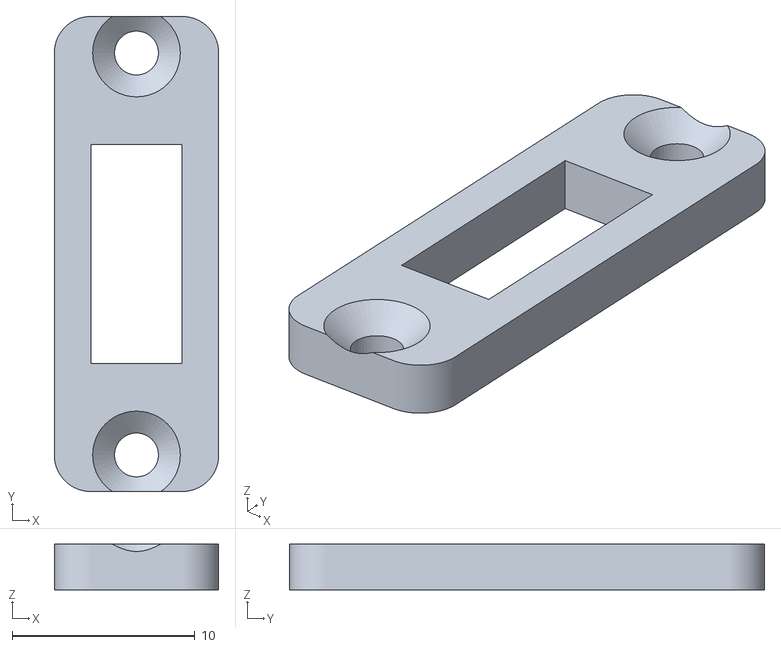
[picture p68: CAD file, 2026-10-04]
bodies/scout/stl/scout-sensor_clamp-x3.stl
9.00 x 26.0 x 2.50
