Meckie-AI/meckie-bodies/bodies/wobble/stl/wobble-wheel_hub-x2.stl

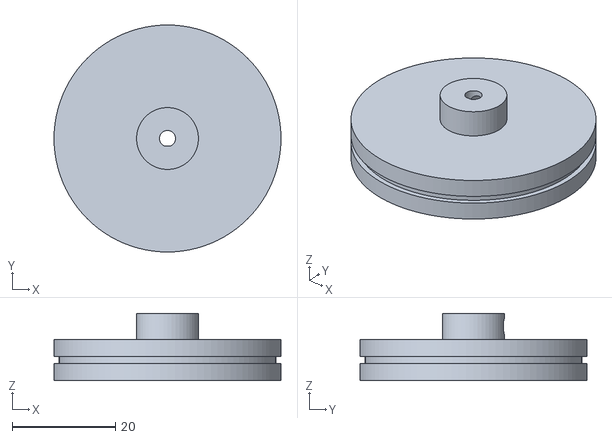
[picture p69: CAD file, 2026-10-04]
bodies/wobble/stl/wobble-wheel_hub-x2.stl
44.0 x 44.0 x 13.0
