Meckie-AI/meckie-bodies/bodies/comet/stl/comet-shin_R-x2.stl

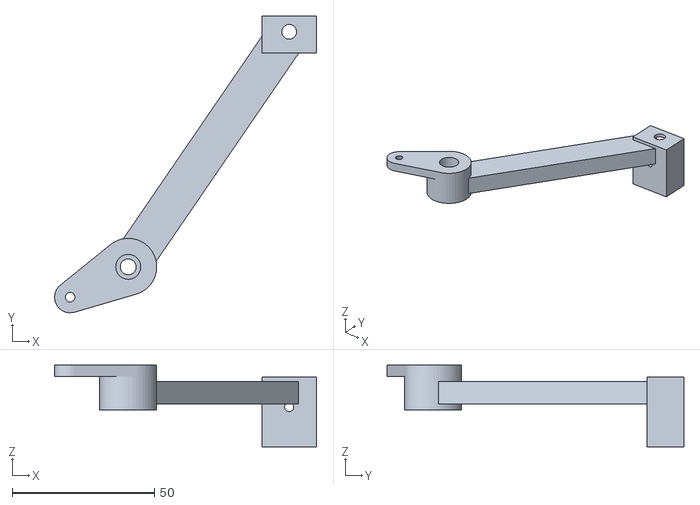
[picture p70: CAD file, 2026-10-06]
bodies/comet/stl/comet-shin_R-x2.stl
92.0 x 104.2 x 28.7
