Meckie-AI/meckie-bodies/bodies/dial/stl/dial-speaker_ring-x1.stl

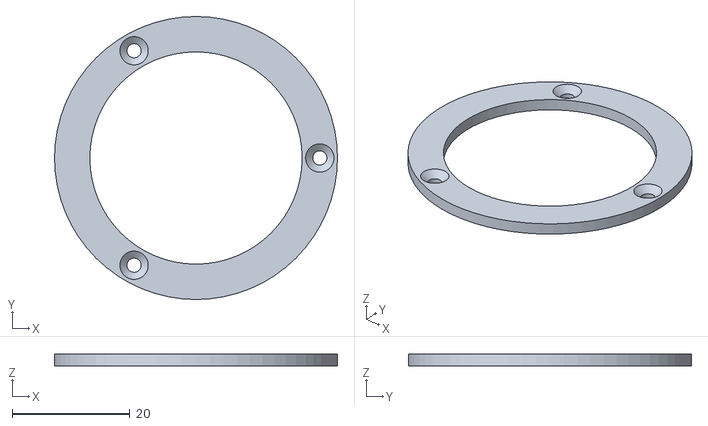
[picture p71: CAD file, 2026-10-04]
bodies/dial/stl/dial-speaker_ring-x1.stl
48.0 x 48.0 x 2.00
