Meckie-AI/meckie-bodies/bodies/inchworm/stl/inchworm-link2_cap-x1.stl

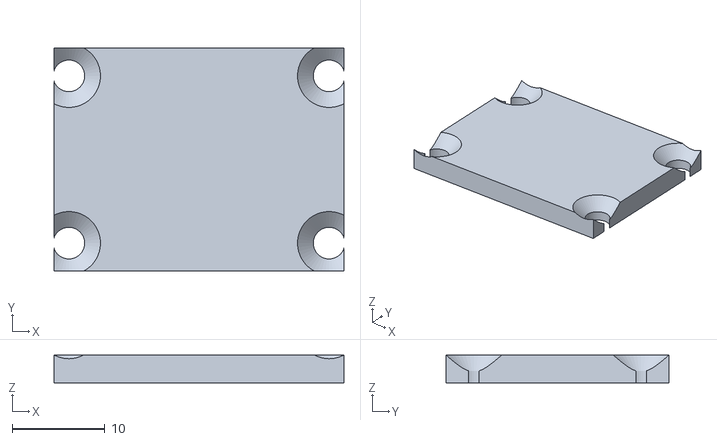
[picture p72: CAD file, 2026-10-04]
bodies/inchworm/stl/inchworm-link2_cap-x1.stl
31.2 x 24.0 x 3.00
