Meckie-AI/meckie-bodies/bodies/rover-lite/stl/rover-lite-tray_front-x1.stl

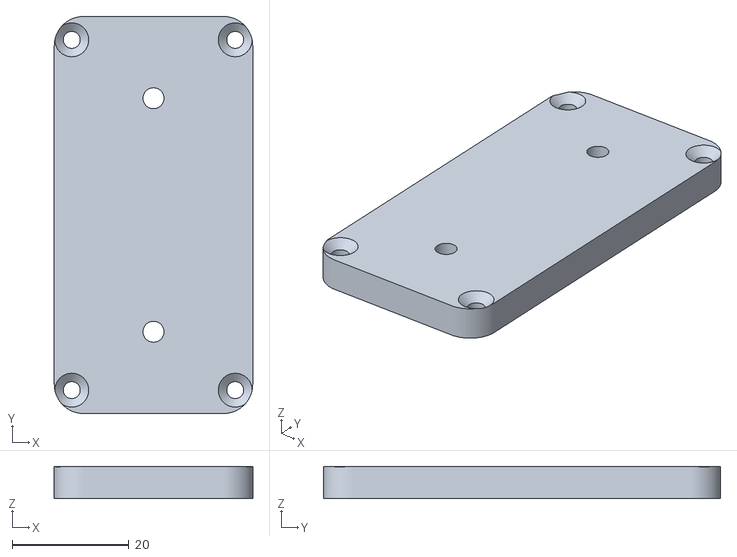
[picture p74: CAD file, 2026-10-04]
bodies/rover-lite/stl/rover-lite-tray_front-x1.stl
34.0 x 68.0 x 5.50
