Meckie-AI/meckie-bodies/bodies/scout/stl/scout-lower_shell-x1.stl

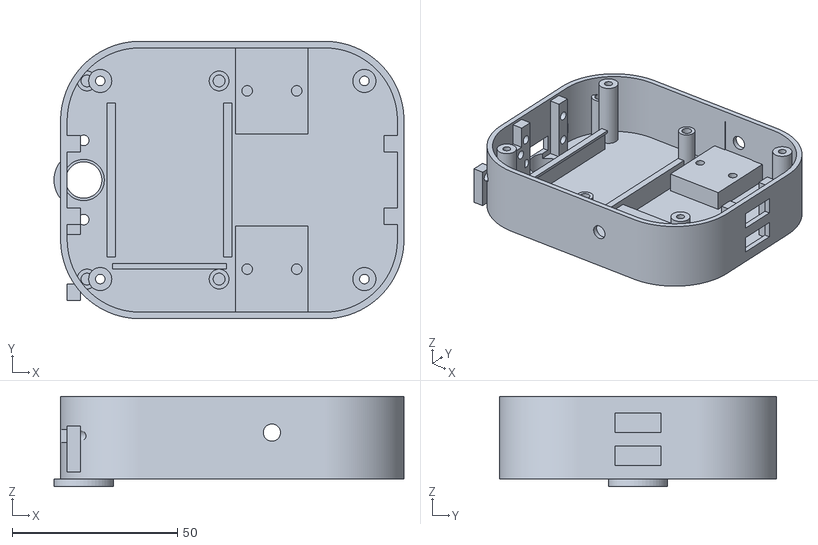
[picture p75: CAD file, 2026-10-04]
bodies/scout/stl/scout-lower_shell-x1.stl
106.0 x 84.0 x 27.4
