Meckie-AI/meckie-bodies/bodies/wobble/stl/wobble-leg-x2.stl

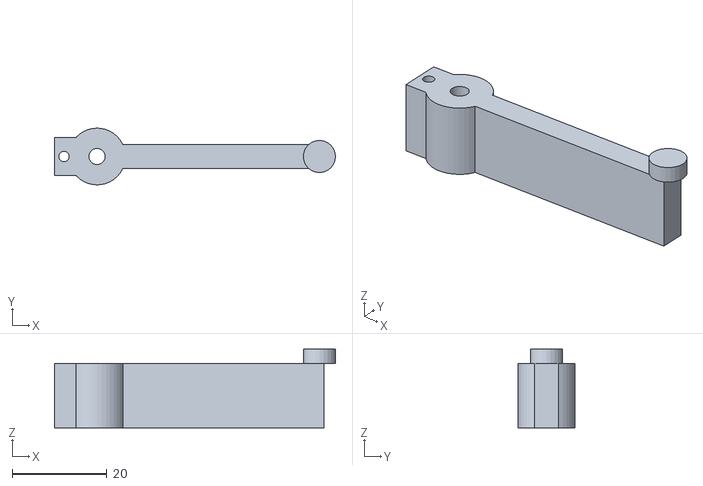
[picture p76: CAD file, 2026-10-04]
bodies/wobble/stl/wobble-leg-x2.stl
59.4 x 12.0 x 16.6
