Meckie-AI/meckie-bodies/bodies/biped-mini/stl/biped-mini-arm-x2.stl

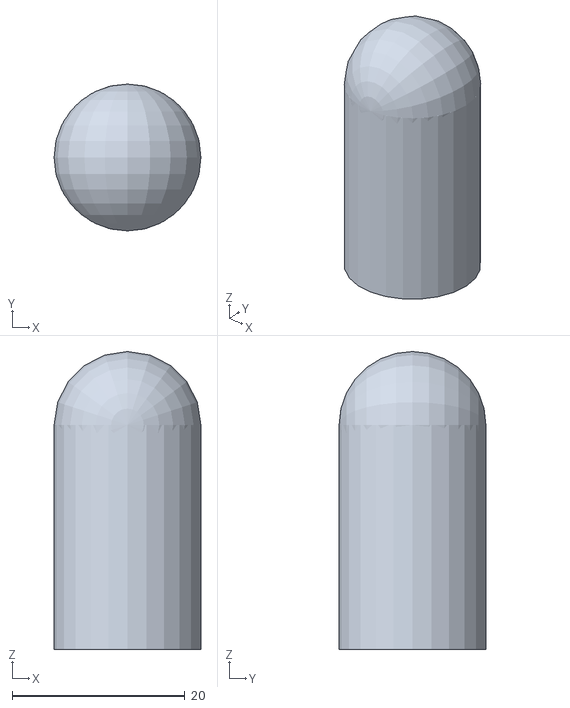
[picture p77: CAD file, 2026-10-04]
bodies/biped-mini/stl/biped-mini-arm-x2.stl
17.0 x 17.0 x 34.5
