Meckie-AI/meckie-bodies/bodies/comet/stl/comet-face_bezel-x1.stl

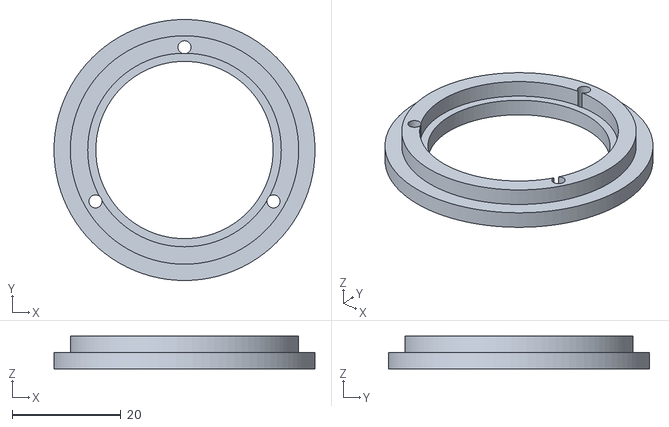
[picture p78: CAD file, 2026-10-06]
bodies/comet/stl/comet-face_bezel-x1.stl
48.0 x 48.0 x 6.00
