Meckie-AI/meckie-bodies/bodies/dial/stl/dial-rear_shell-x1.stl

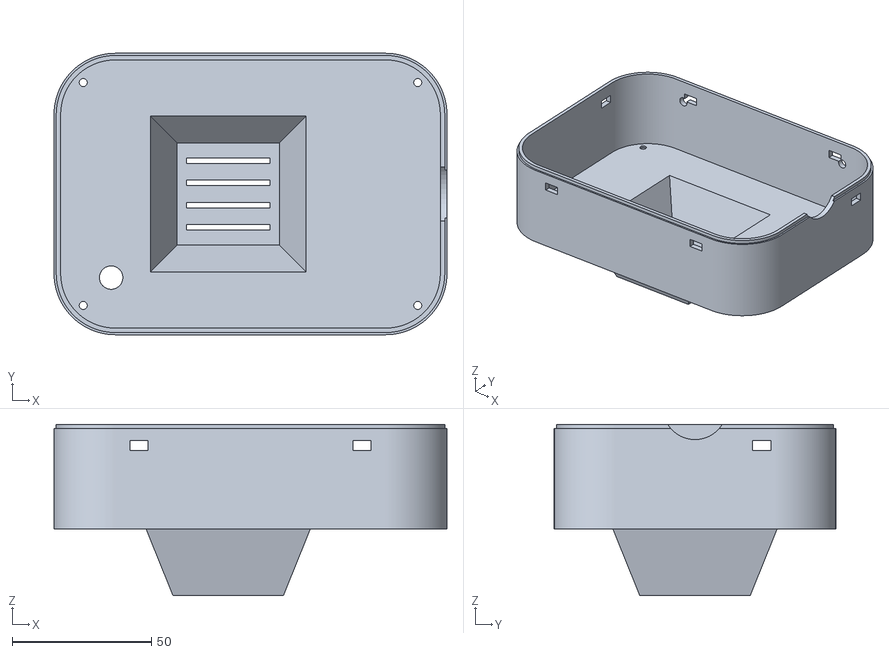
[picture p79: CAD file, 2026-10-04]
bodies/dial/stl/dial-rear_shell-x1.stl
141.0 x 101.0 x 61.5
