Meckie-AI/meckie-bodies/bodies/inchworm/stl/inchworm-antenna_tip-x2.stl

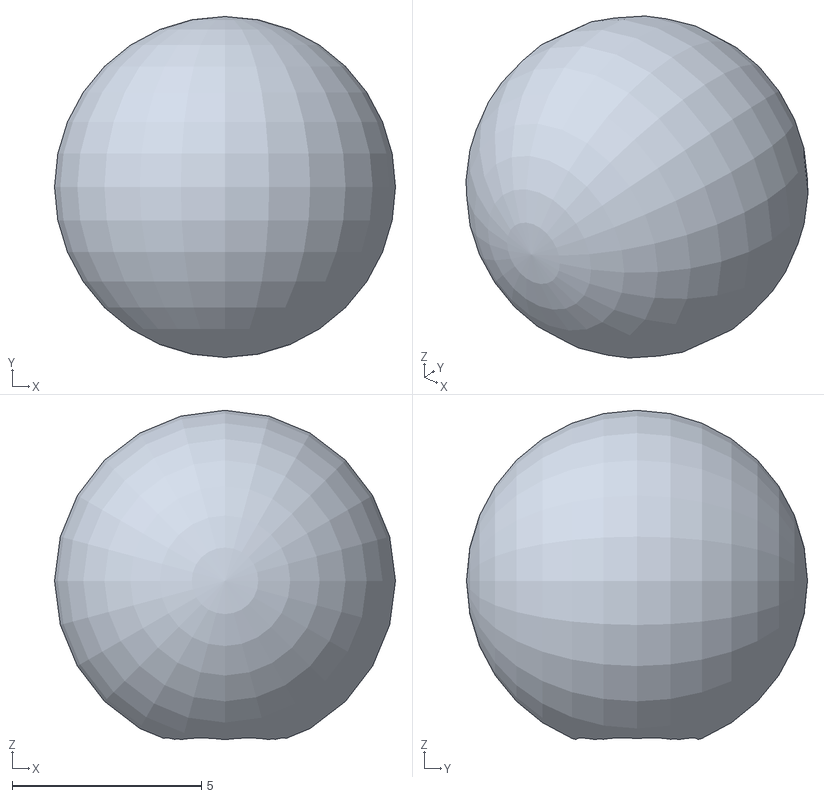
[picture p80: CAD file, 2026-10-04]
bodies/inchworm/stl/inchworm-antenna_tip-x2.stl
9.00 x 9.00 x 8.69
