Meckie-AI/meckie-bodies/bodies/lamp/stl/lamp-rail_tie-x2.stl

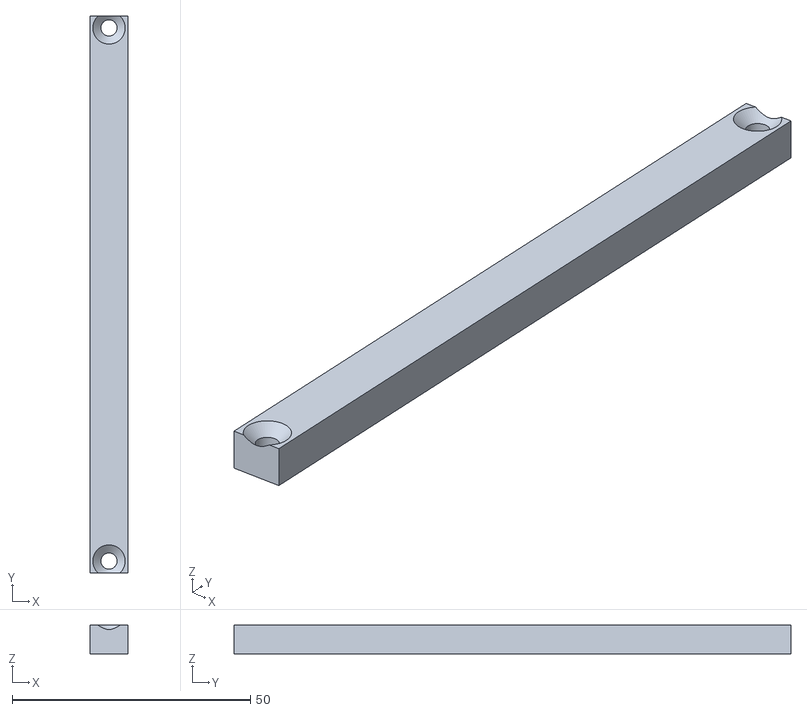
[picture p81: CAD file, 2026-10-04]
bodies/lamp/stl/lamp-rail_tie-x2.stl
8.00 x 117.0 x 6.00
