Meckie-AI/meckie-bodies/bodies/rover-lite/stl/rover-lite-fender-x2.stl

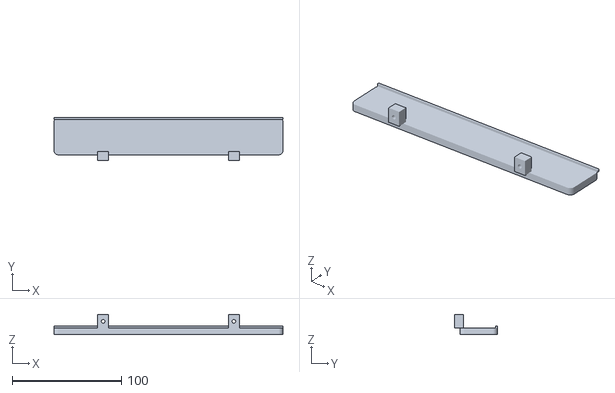
[picture p82: CAD file, 2026-10-04]
bodies/rover-lite/stl/rover-lite-fender-x2.stl
210.0 x 39.0 x 18.4
