Meckie-AI/meckie-bodies/bodies/scout/stl/scout-hubcap-x2.stl

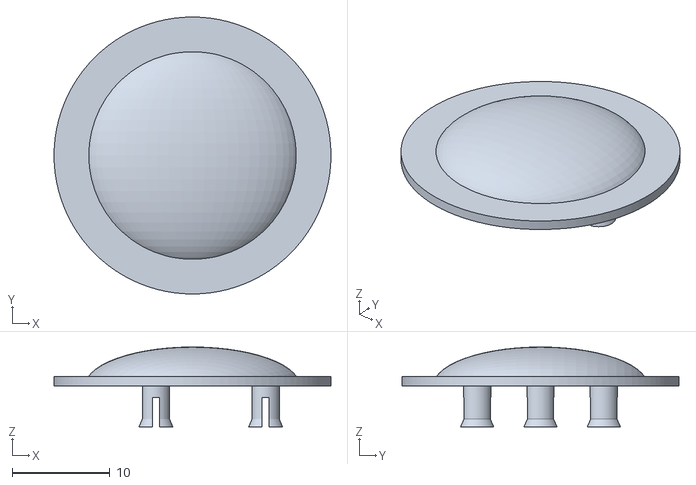
[picture p83: CAD file, 2026-10-04]
bodies/scout/stl/scout-hubcap-x2.stl
28.4 x 28.4 x 8.20
