Meckie-AI/meckie-bodies/bodies/wobble/stl/wobble-board_plate-x2.stl

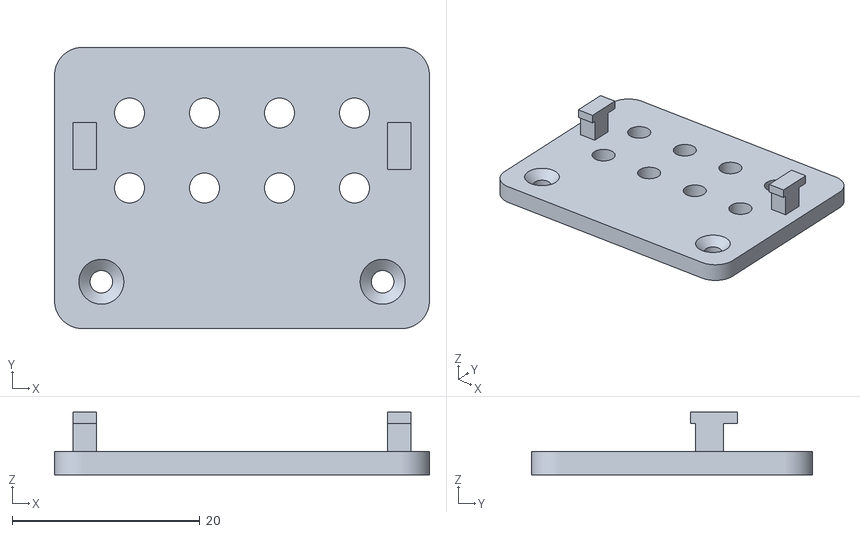
[picture p84: CAD file, 2026-10-04]
bodies/wobble/stl/wobble-board_plate-x2.stl
40.0 x 30.0 x 6.70
