Meckie-AI/meckie-bodies/bodies/biped-mini/stl/biped-mini-head_brim-x1.stl

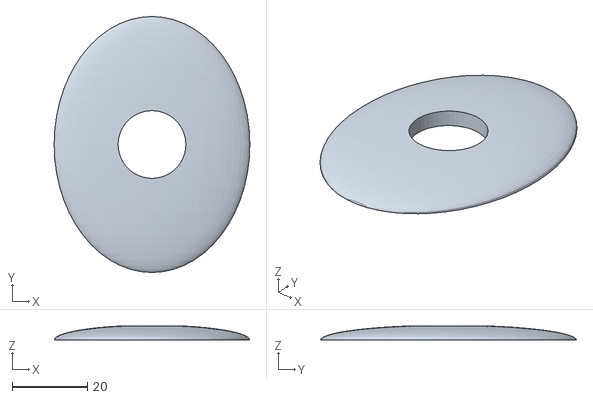
[picture p85: CAD file, 2026-10-04]
bodies/biped-mini/stl/biped-mini-head_brim-x1.stl
52.0 x 68.0 x 3.85
