Meckie-AI/meckie-bodies/bodies/comet/stl/comet-hip_bracket_A-x2.stl

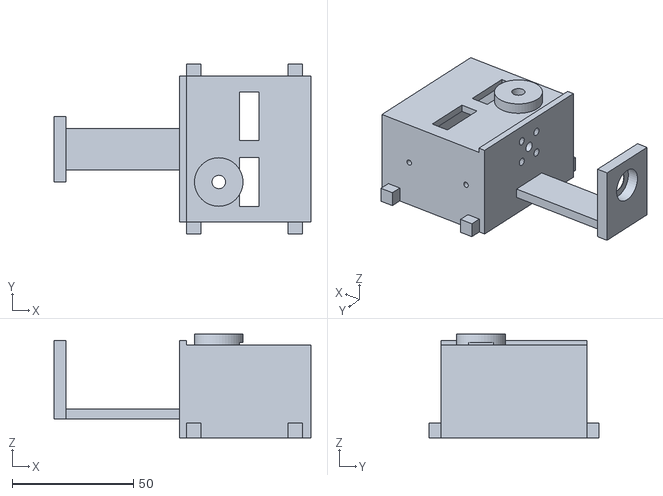
[picture p86: CAD file, 2026-10-06]
bodies/comet/stl/comet-hip_bracket_A-x2.stl
105.9 x 70.0 x 42.7
