Meckie-AI/meckie-bodies/bodies/dial/stl/dial-seam_band-x1.stl

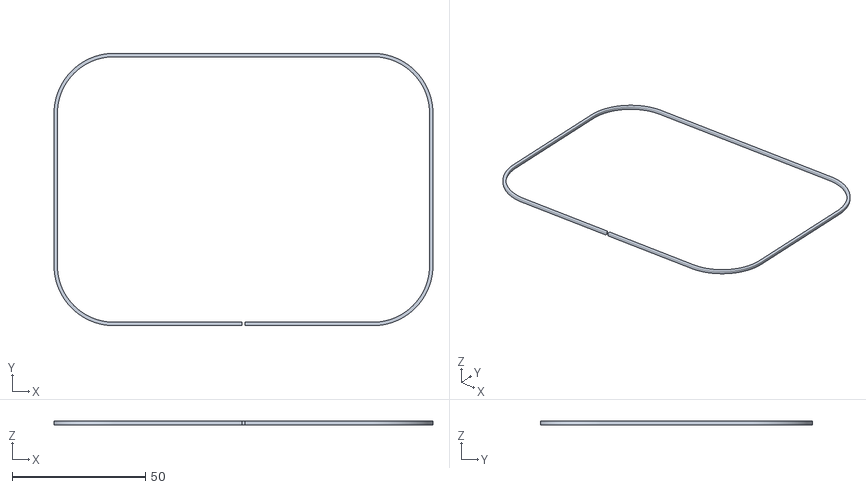
[picture p87: CAD file, 2026-10-04]
bodies/dial/stl/dial-seam_band-x1.stl
142.2 x 102.2 x 1.40
