Meckie-AI/meckie-bodies/bodies/inchworm/stl/inchworm-speaker_ring-x1.stl

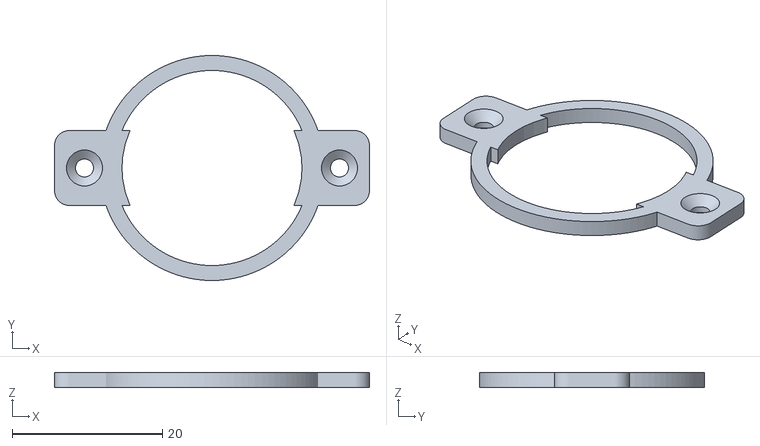
[picture p88: CAD file, 2026-10-04]
bodies/inchworm/stl/inchworm-speaker_ring-x1.stl
42.0 x 30.0 x 2.00
