Meckie-AI/meckie-bodies/bodies/lamp/stl/lamp-pod_left-x1.stl

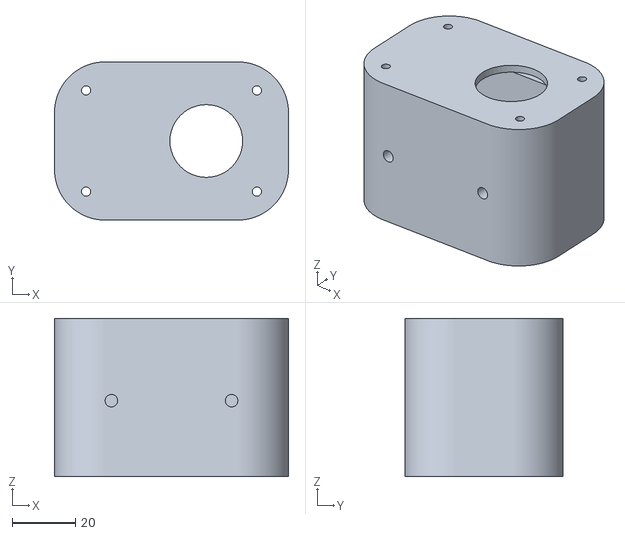
[picture p89: CAD file, 2026-10-04]
bodies/lamp/stl/lamp-pod_left-x1.stl
74.0 x 50.0 x 50.0
