Meckie-AI/meckie-bodies/bodies/rover-lite/stl/rover-lite-corner_cap-x4.stl

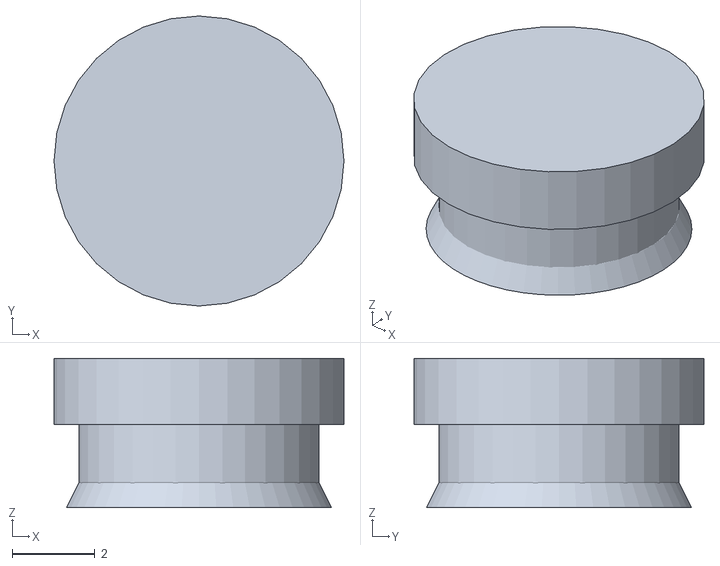
[picture p90: CAD file, 2026-10-04]
bodies/rover-lite/stl/rover-lite-corner_cap-x4.stl
7.00 x 7.00 x 3.60
