Meckie-AI/meckie-bodies/bodies/scout/stl/scout-deck-x1.stl

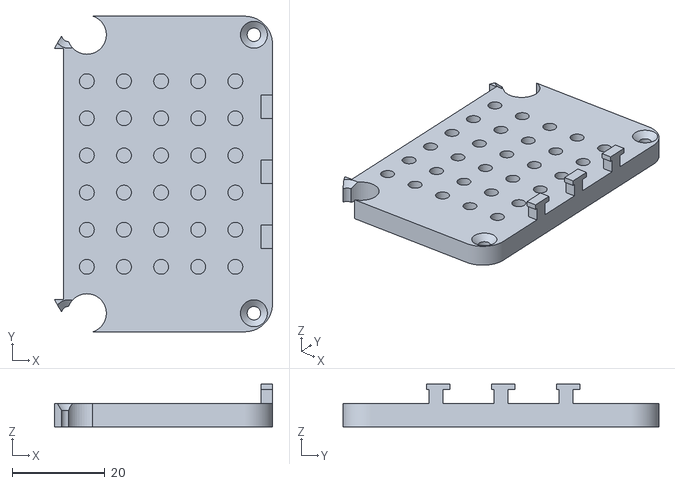
[picture p91: CAD file, 2026-10-04]
bodies/scout/stl/scout-deck-x1.stl
47.0 x 68.0 x 9.20
