Meckie-AI/meckie-bodies/bodies/wobble/stl/wobble-antenna_ball-x2.stl

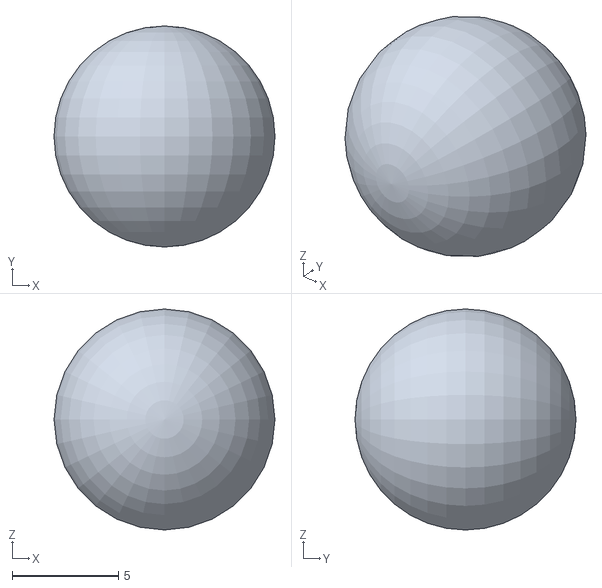
[picture p92: CAD file, 2026-10-04]
bodies/wobble/stl/wobble-antenna_ball-x2.stl
10.4 x 10.4 x 10.4
