Meckie-AI/meckie-bodies/bodies/biped-mini/stl/biped-mini-hip_cap-x2.stl

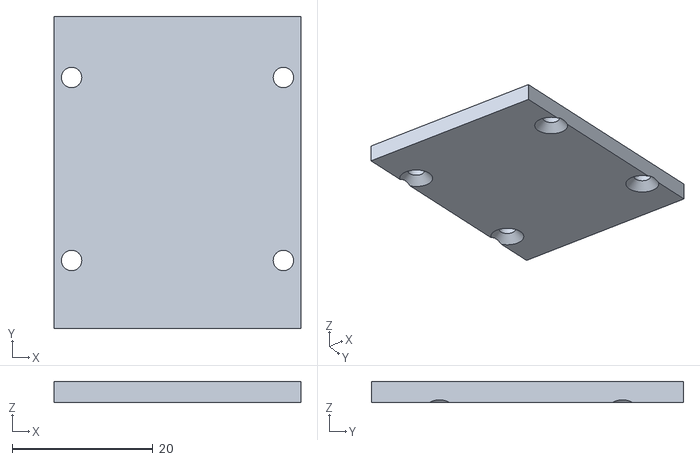
[picture p93: CAD file, 2026-10-04]
bodies/biped-mini/stl/biped-mini-hip_cap-x2.stl
35.1 x 44.4 x 3.00
