Meckie-AI/meckie-bodies/bodies/comet/stl/comet-abd_cradle_A-x2.stl

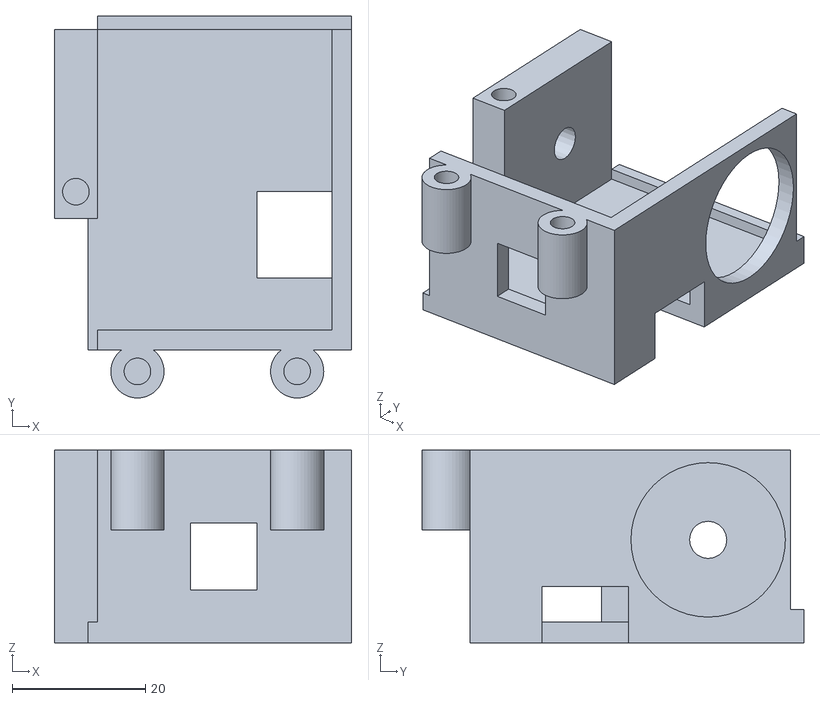
[picture p94: CAD file, 2026-10-06]
bodies/comet/stl/comet-abd_cradle_A-x2.stl
44.7 x 57.4 x 29.0
