Meckie-AI/meckie-bodies/bodies/dial/stl/dial-screen_surround-x1.stl

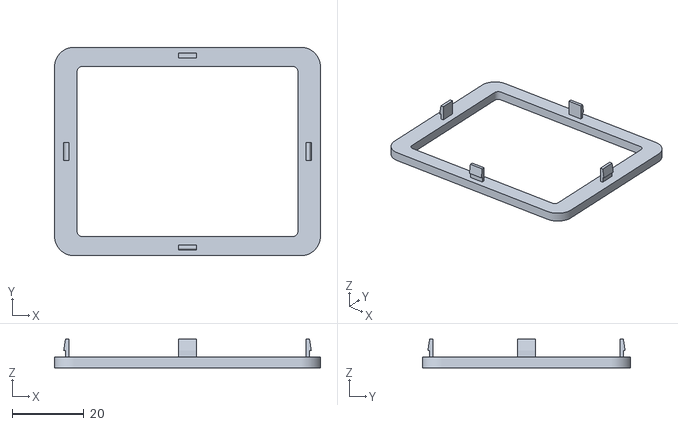
[picture p95: CAD file, 2026-10-04]
bodies/dial/stl/dial-screen_surround-x1.stl
74.0 x 58.0 x 8.00
