Meckie-AI/meckie-bodies/bodies/lamp/stl/lamp-led_diffuser-x1.stl

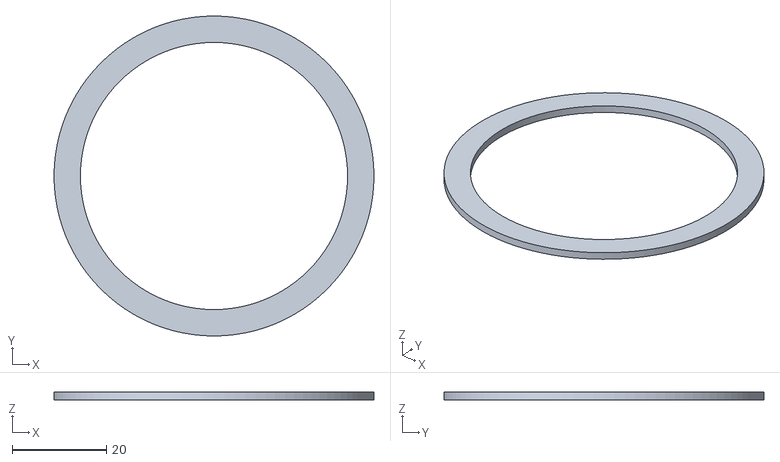
[picture p96: CAD file, 2026-10-04]
bodies/lamp/stl/lamp-led_diffuser-x1.stl
67.8 x 67.8 x 1.60
