Meckie-AI/meckie-bodies/bodies/rover-lite/stl/rover-lite-deck-x1.stl

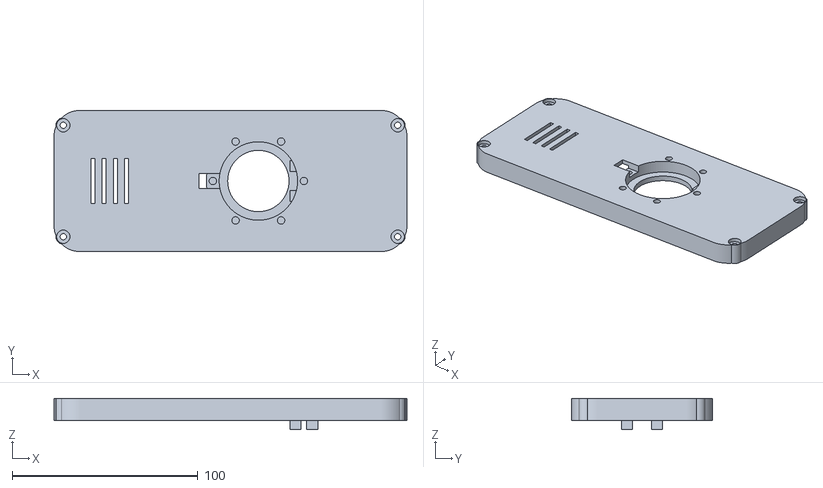
[picture p97: CAD file, 2026-10-04]
bodies/rover-lite/stl/rover-lite-deck-x1.stl
190.0 x 76.0 x 16.8
