Meckie-AI/meckie-bodies/bodies/scout/stl/scout-caster_cap-x1.stl

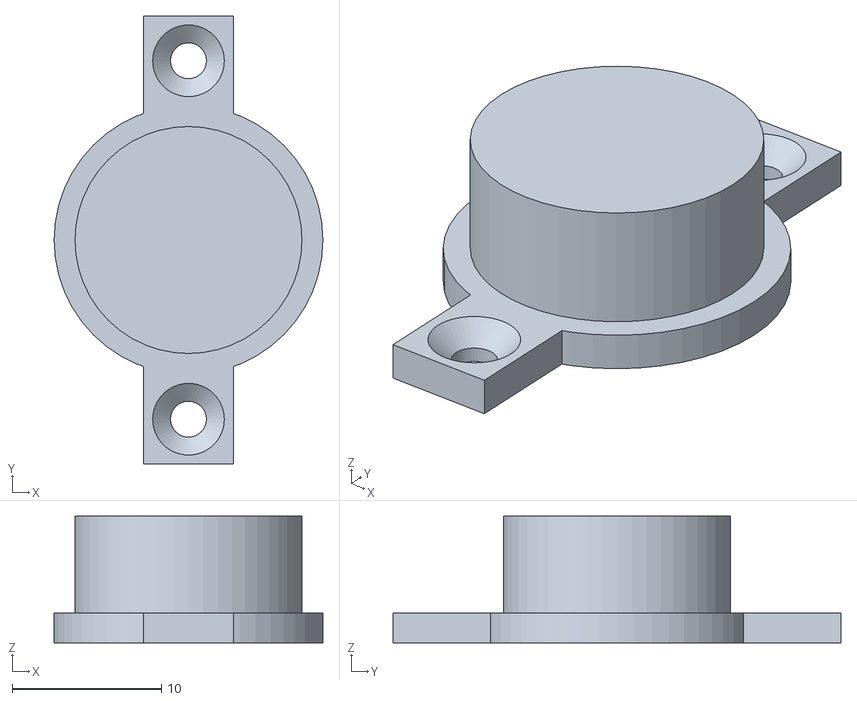
[picture p98: CAD file, 2026-10-04]
bodies/scout/stl/scout-caster_cap-x1.stl
18.0 x 30.0 x 8.50
