Meckie-AI/meckie-bodies/bodies/wobble/stl/wobble-corner_bumper-x2.stl

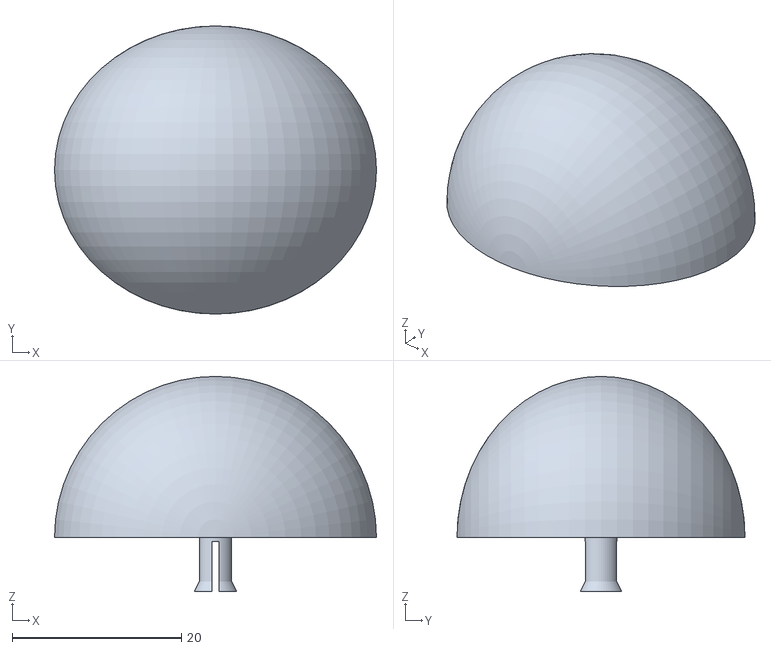
[picture p99: CAD file, 2026-10-04]
bodies/wobble/stl/wobble-corner_bumper-x2.stl
38.0 x 34.0 x 25.4
