Meckie-AI/meckie-bodies/bodies/biped-mini/stl/biped-mini-sensor_clamp-x5.stl

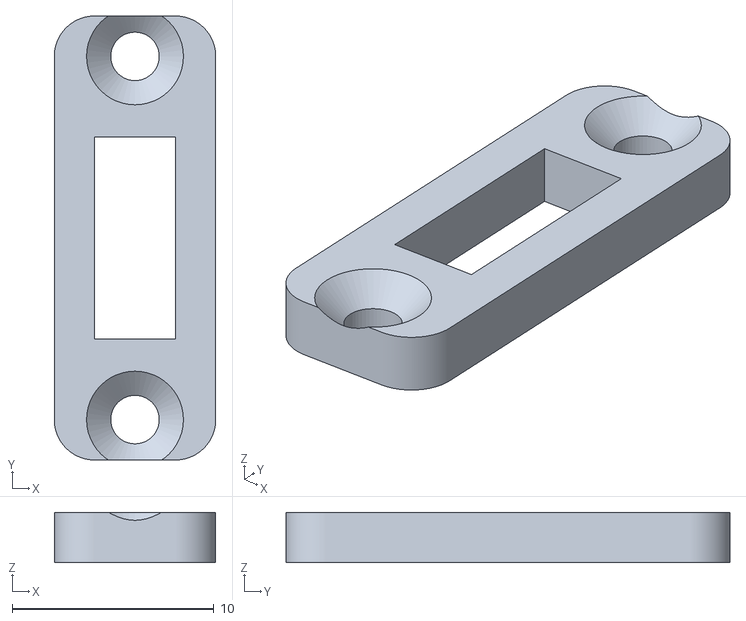
[picture p100: CAD file, 2026-10-04]
bodies/biped-mini/stl/biped-mini-sensor_clamp-x5.stl
8.00 x 22.0 x 2.50
