Meckie-AI/meckie-bodies/bodies/comet/stl/comet-contact_block-x1.stl

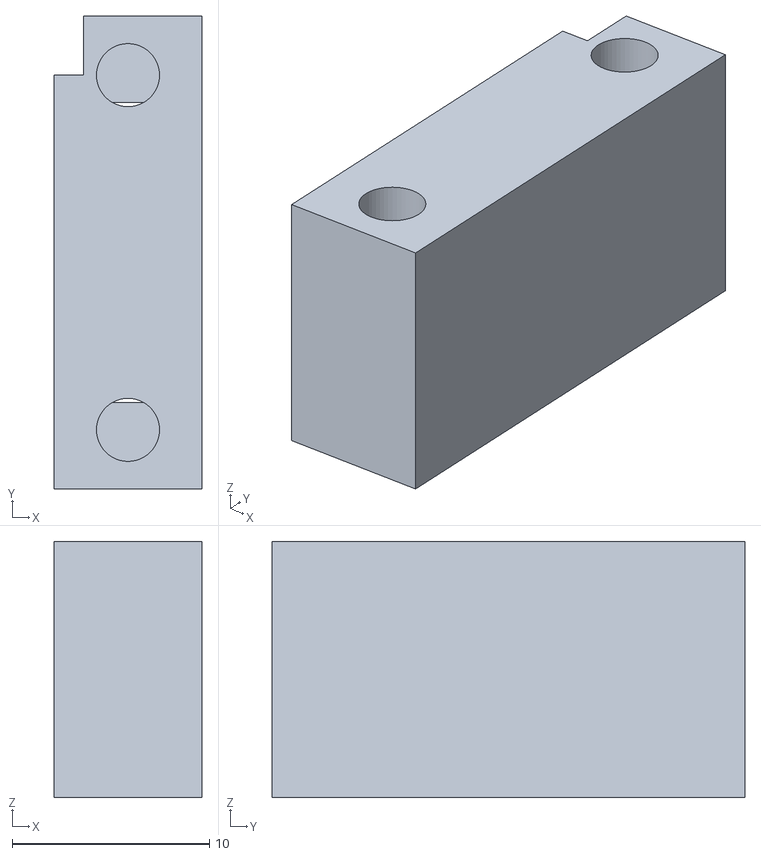
[picture p101: CAD file, 2026-10-06]
bodies/comet/stl/comet-contact_block-x1.stl
7.50 x 24.0 x 13.0
