Meckie-AI/meckie-bodies/bodies/dial/stl/dial-tilt_stop-x1.stl

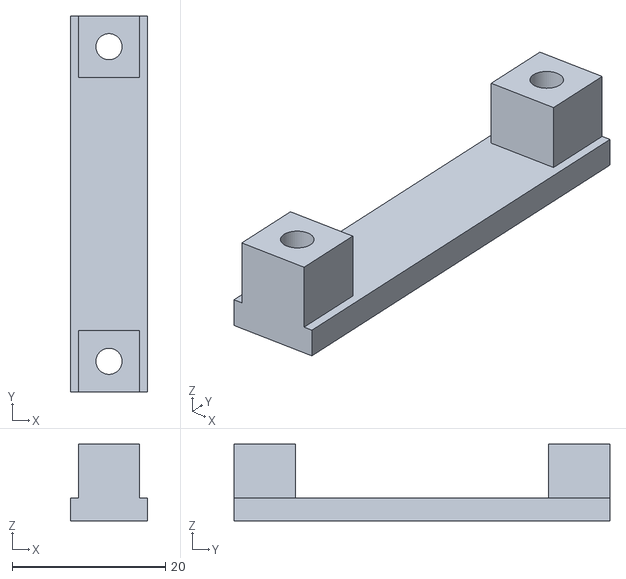
[picture p102: CAD file, 2026-10-04]
bodies/dial/stl/dial-tilt_stop-x1.stl
10.0 x 49.0 x 10.0
