Meckie-AI/meckie-bodies/bodies/inchworm/stl/inchworm-link1_shell_R-x1.stl

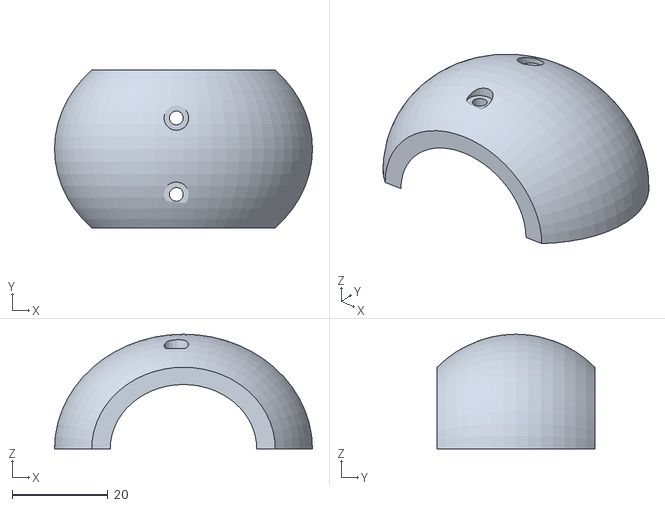
[picture p103: CAD file, 2026-10-04]
bodies/inchworm/stl/inchworm-link1_shell_R-x1.stl
54.0 x 33.0 x 24.0
