Meckie-AI/meckie-bodies/bodies/lamp/stl/lamp-pod_right-x1.stl

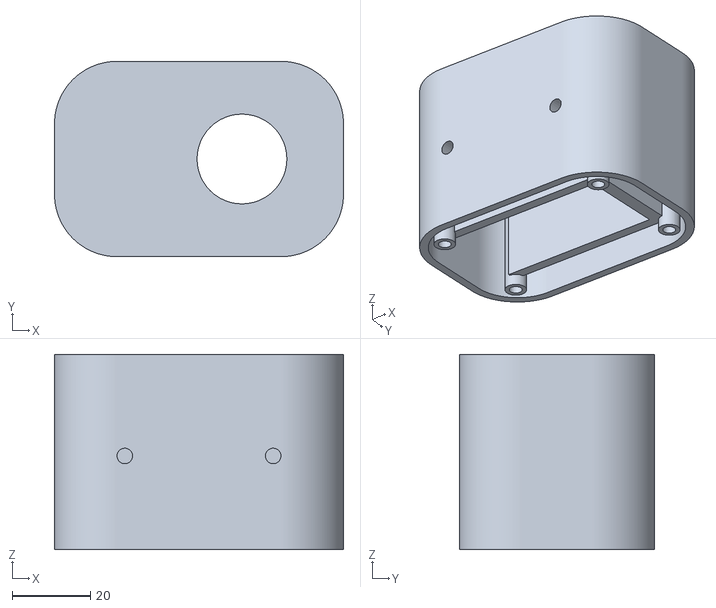
[picture p104: CAD file, 2026-10-04]
bodies/lamp/stl/lamp-pod_right-x1.stl
74.0 x 50.0 x 50.0
