Meckie-AI/meckie-bodies/bodies/rover-lite/stl/rover-lite-road_wheel-x6.stl

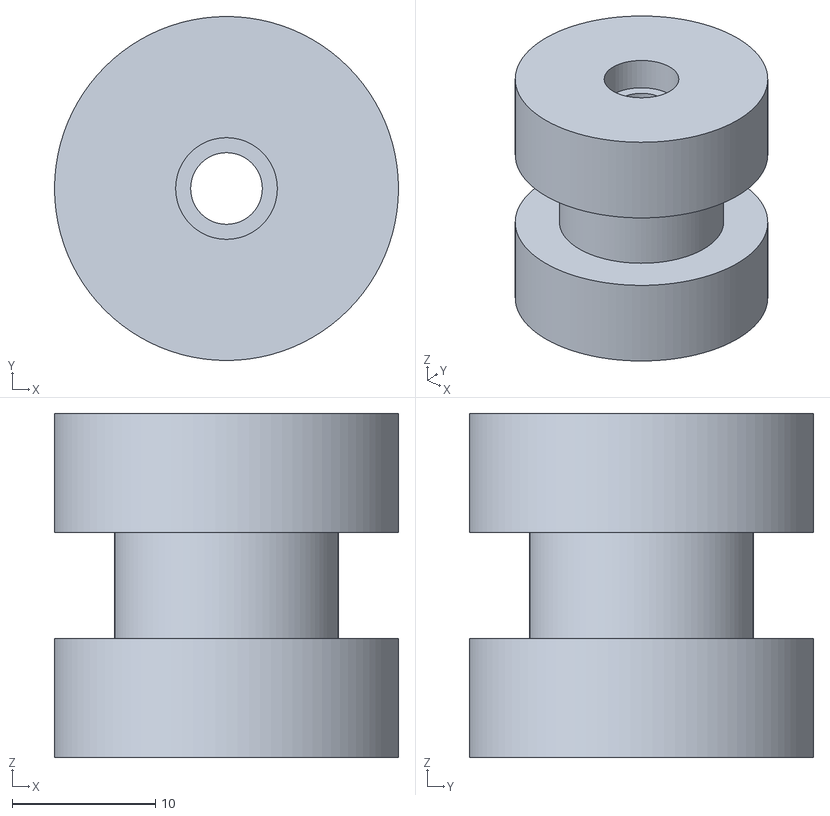
[picture p105: CAD file, 2026-10-04]
bodies/rover-lite/stl/rover-lite-road_wheel-x6.stl
24.0 x 24.0 x 24.0
