Meckie-AI/meckie-bodies/bodies/scout/stl/scout-wheel_hub-x2.stl

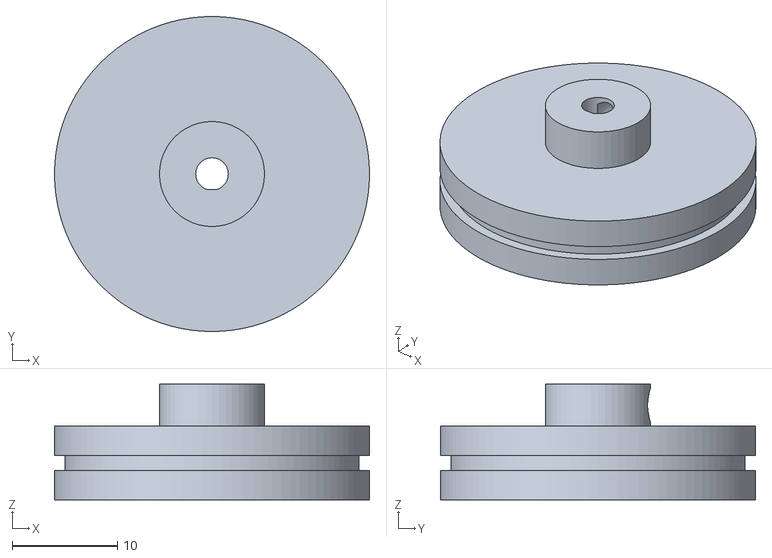
[picture p106: CAD file, 2026-10-04]
bodies/scout/stl/scout-wheel_hub-x2.stl
30.0 x 30.0 x 11.0
