Meckie-AI/meckie-bodies/bodies/wobble/stl/wobble-tyre-x2.stl

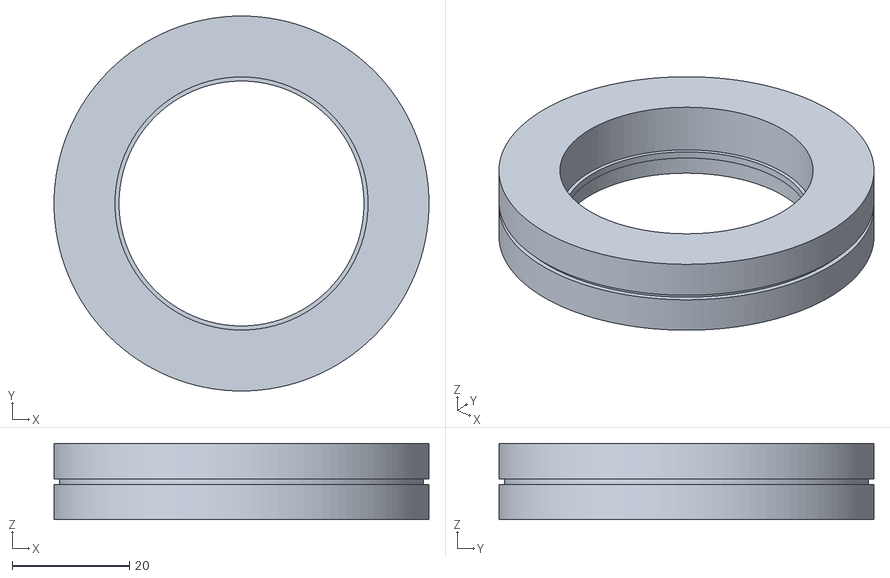
[picture p107: CAD file, 2026-10-04]
bodies/wobble/stl/wobble-tyre-x2.stl
64.0 x 64.0 x 13.0
