Meckie-AI/meckie-bodies/bodies/comet/stl/comet-orbit_ring-x1.stl

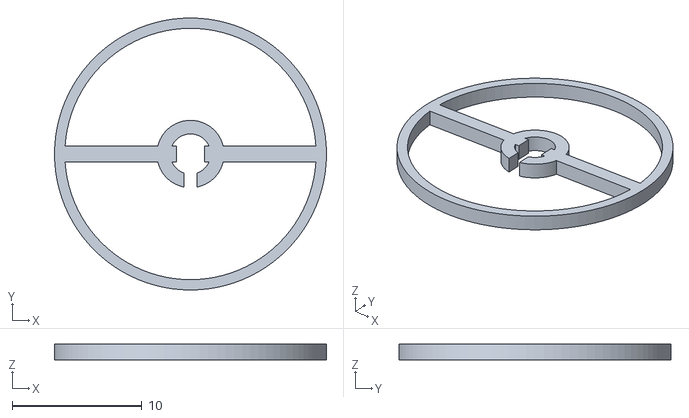
[picture p108: CAD file, 2026-10-06]
bodies/comet/stl/comet-orbit_ring-x1.stl
21.0 x 21.0 x 1.20
