Meckie-AI/meckie-bodies/bodies/dial/stl/dial-cable_clock-x1.stl

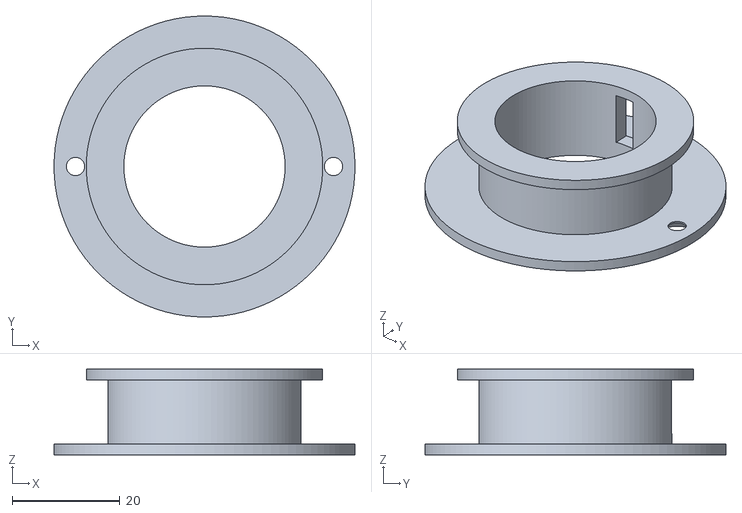
[picture p109: CAD file, 2026-10-04]
bodies/dial/stl/dial-cable_clock-x1.stl
56.0 x 56.0 x 16.0
