Meckie-AI/meckie-bodies/bodies/lamp/stl/lamp-upper_rail_L-x1.stl

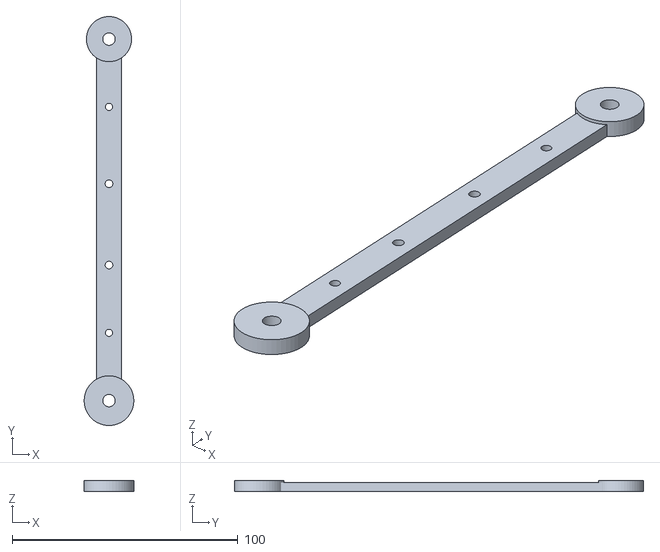
[picture p110: CAD file, 2026-10-04]
bodies/lamp/stl/lamp-upper_rail_L-x1.stl
22.0 x 181.0 x 5.00
