Meckie-AI/meckie-bodies/bodies/rover-lite/stl/rover-lite-idler_block-x2.stl

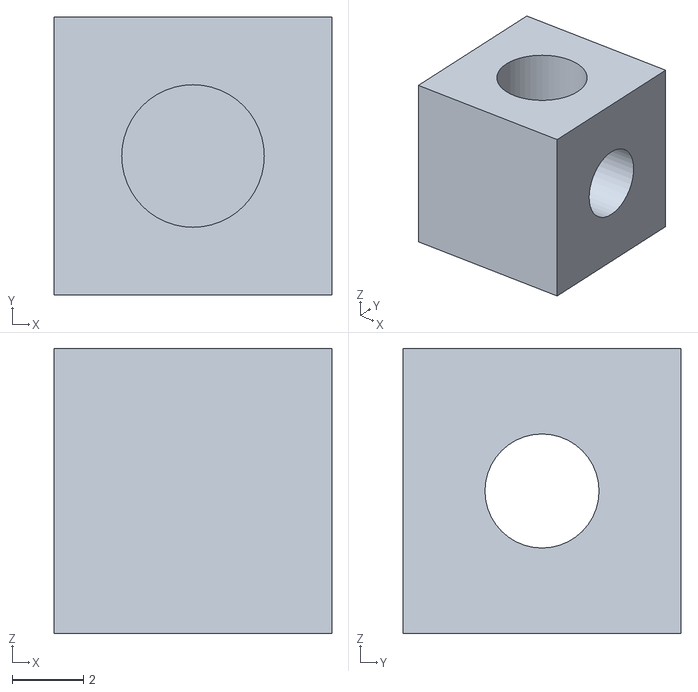
[picture p111: CAD file, 2026-10-04]
bodies/rover-lite/stl/rover-lite-idler_block-x2.stl
7.80 x 7.80 x 8.00
