Meckie-AI/meckie-bodies/bodies/scout/stl/scout-tyre-x2.stl

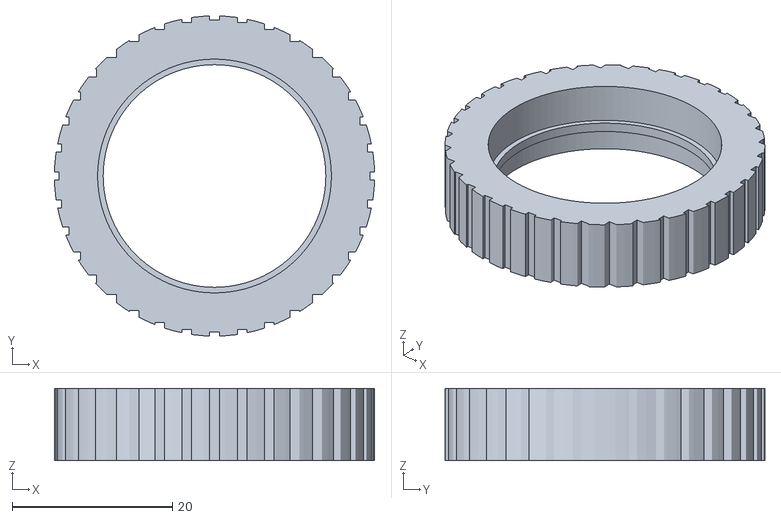
[picture p112: CAD file, 2026-10-04]
bodies/scout/stl/scout-tyre-x2.stl
40.0 x 40.0 x 9.00
