Meckie-AI/meckie-bodies/bodies/biped-mini/stl/biped-mini-shin_outer_R-x1.stl

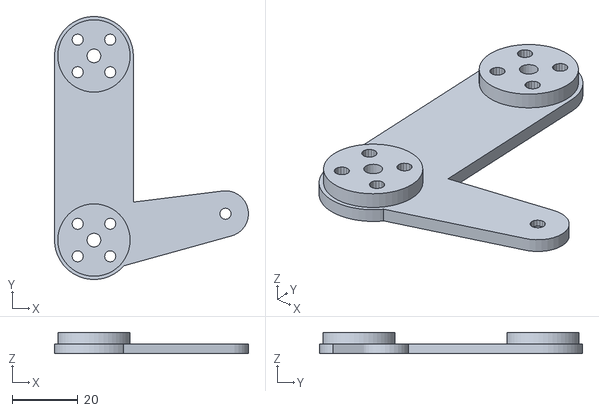
[picture p113: CAD file, 2026-10-04]
bodies/biped-mini/stl/biped-mini-shin_outer_R-x1.stl
59.0 x 80.0 x 6.50
