Meckie-AI/meckie-bodies/bodies/comet/stl/comet-shell_nose-x1.stl

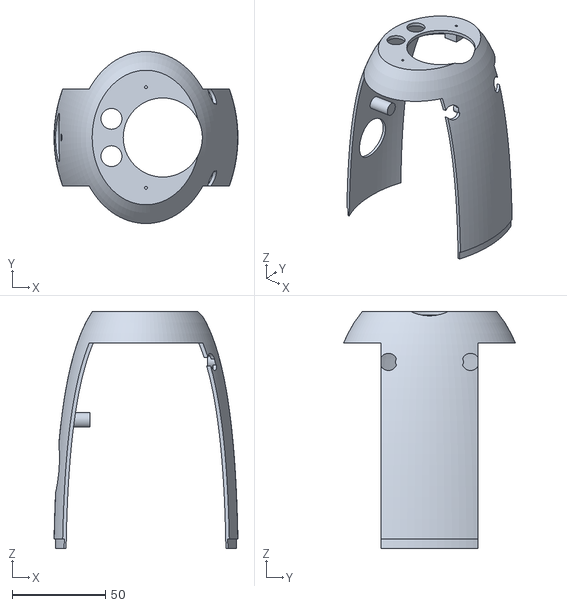
[picture p114: CAD file, 2026-10-06]
bodies/comet/stl/comet-shell_nose-x1.stl
98.5 x 92.2 x 127.0
