Meckie-AI/meckie-bodies/bodies/dial/stl/dial-camera_bracket-x1.stl

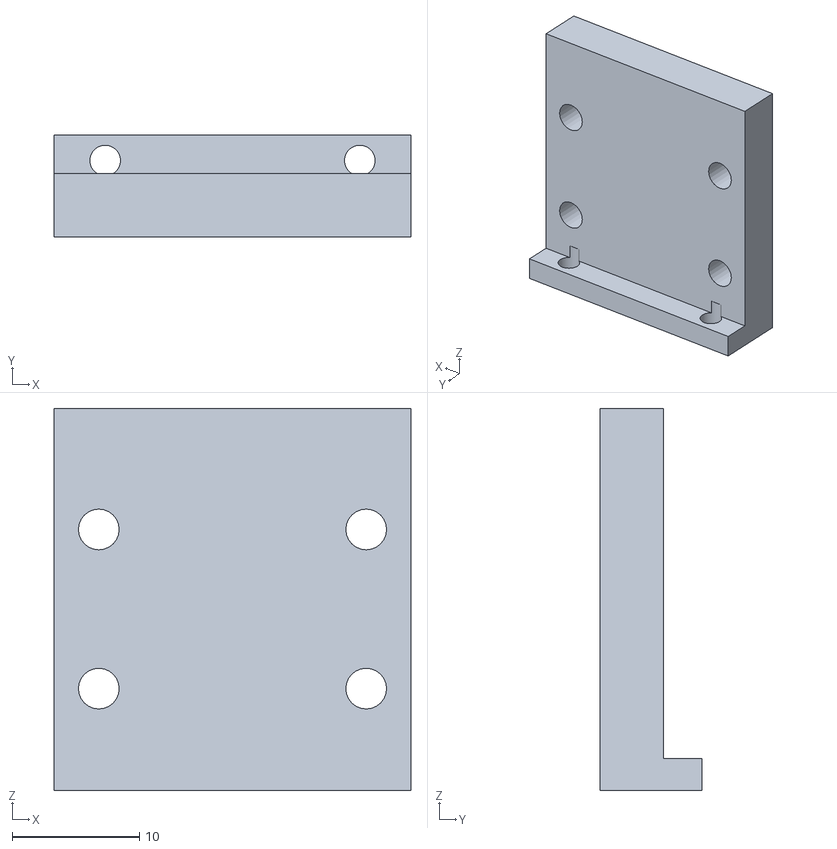
[picture p115: CAD file, 2026-10-04]
bodies/dial/stl/dial-camera_bracket-x1.stl
28.0 x 8.00 x 30.0
