Meckie-AI/meckie-bodies/bodies/inchworm/stl/inchworm-link3_cap-x1.stl

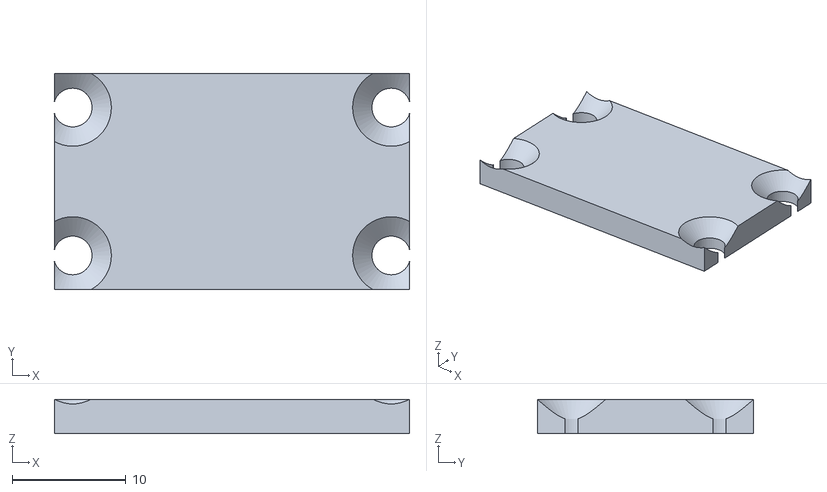
[picture p116: CAD file, 2026-10-04]
bodies/inchworm/stl/inchworm-link3_cap-x1.stl
31.2 x 19.0 x 3.00
