Meckie-AI/meckie-bodies/bodies/rover-lite/stl/rover-lite-sensor_clamp-x3.stl

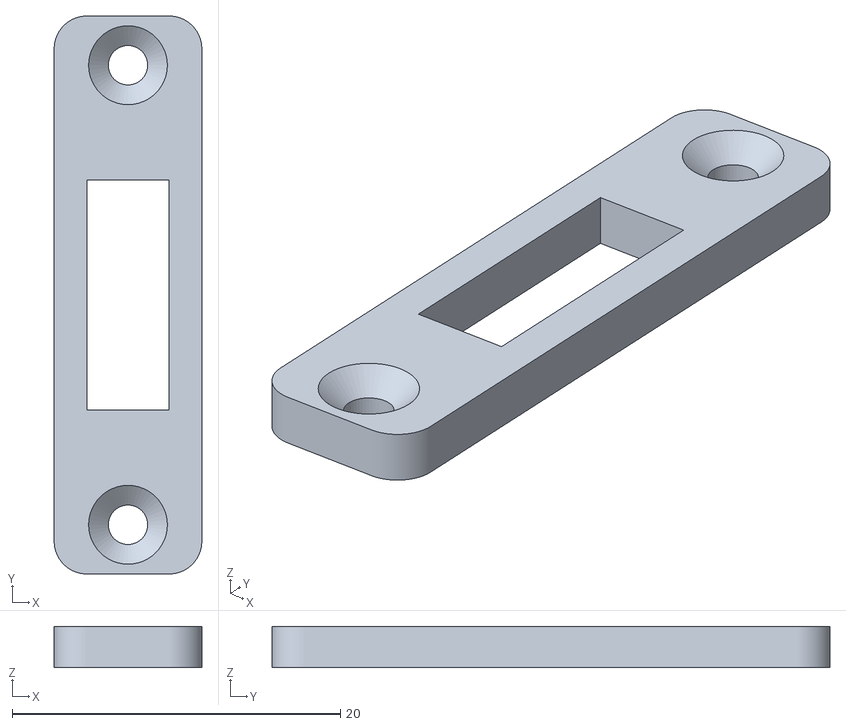
[picture p117: CAD file, 2026-10-04]
bodies/rover-lite/stl/rover-lite-sensor_clamp-x3.stl
9.00 x 34.0 x 2.50
