Meckie-AI/meckie-bodies/bodies/scout/stl/scout-switch_clamp-x1.stl

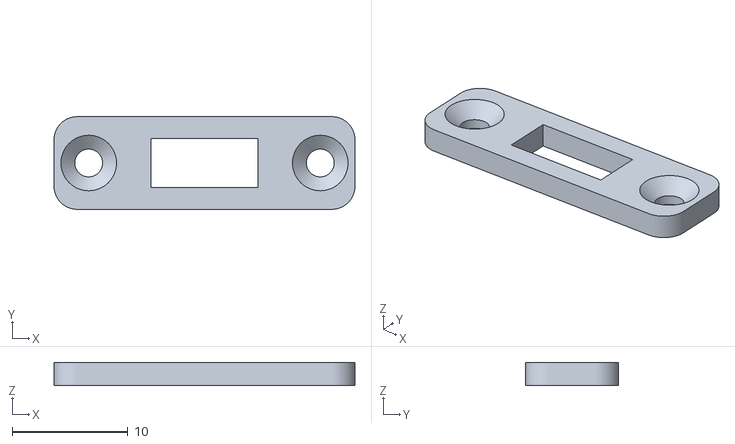
[picture p118: CAD file, 2026-10-04]
bodies/scout/stl/scout-switch_clamp-x1.stl
26.0 x 8.00 x 2.00
