Meckie-AI/meckie-bodies/bodies/wobble/stl/wobble-battery_door-x1.stl

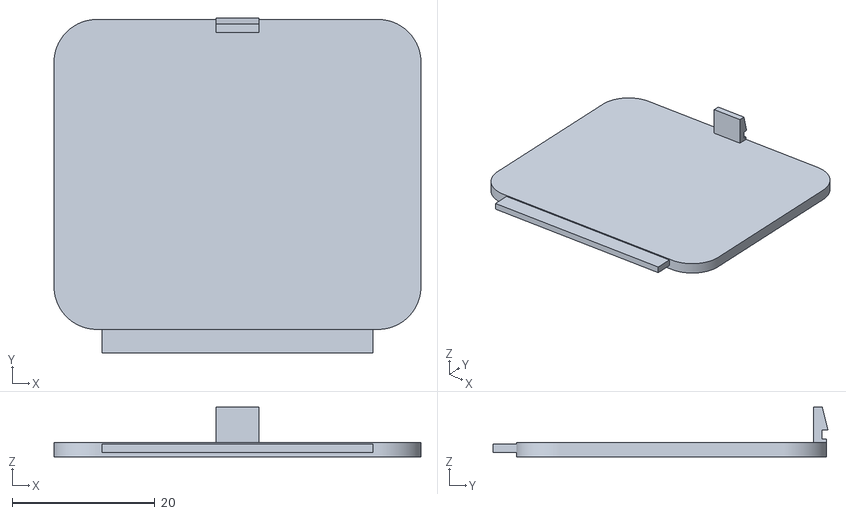
[picture p119: CAD file, 2026-10-04]
bodies/wobble/stl/wobble-battery_door-x1.stl
51.4 x 46.9 x 7.00
