Meckie-AI/meckie-bodies/bodies/biped-mini/stl/biped-mini-pelvis-x1.stl

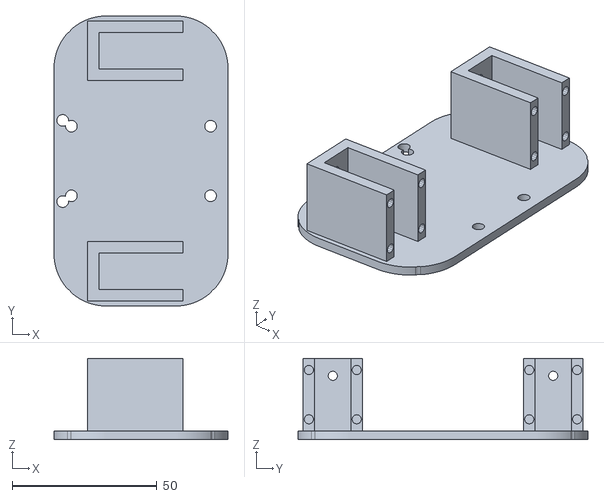
[picture p120: CAD file, 2026-10-04]
bodies/biped-mini/stl/biped-mini-pelvis-x1.stl
60.0 x 100.0 x 28.0
