Meckie-AI/meckie-bodies/bodies/comet/stl/comet-tail_light-x1.stl

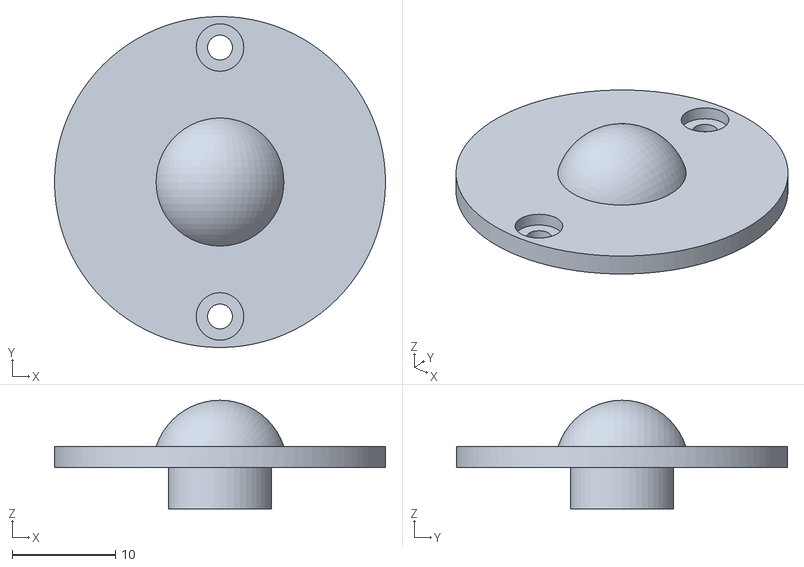
[picture p121: CAD file, 2026-10-06]
bodies/comet/stl/comet-tail_light-x1.stl
32.0 x 32.0 x 10.5
