Meckie-AI/meckie-bodies/bodies/dial/stl/dial-tof_bezel-x1.stl

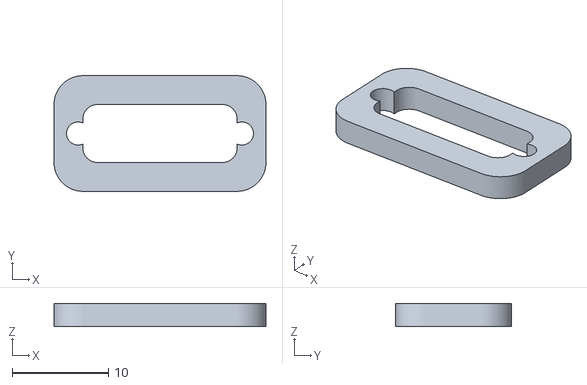
[picture p122: CAD file, 2026-10-04]
bodies/dial/stl/dial-tof_bezel-x1.stl
22.0 x 12.0 x 2.40
