Meckie-AI/meckie-bodies/bodies/inchworm/stl/inchworm-link2_shell_L-x1.stl

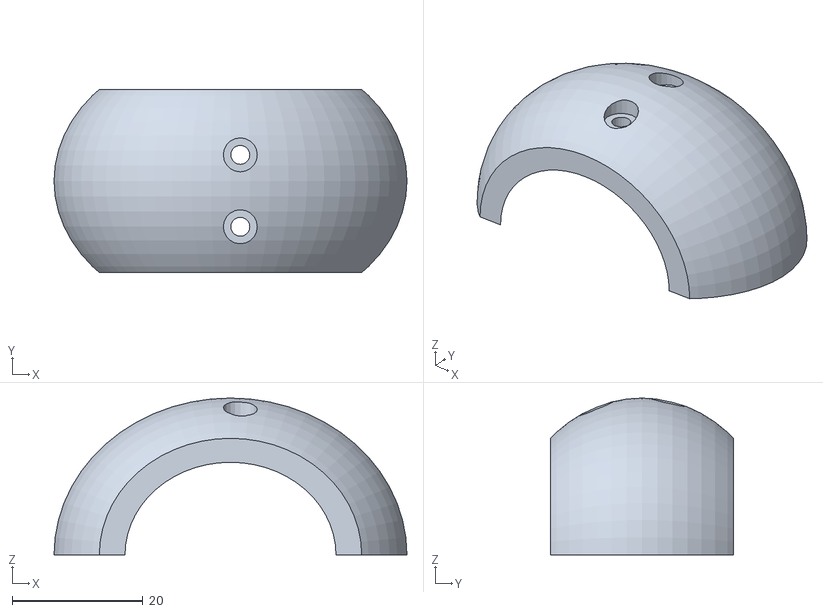
[picture p123: CAD file, 2026-10-04]
bodies/inchworm/stl/inchworm-link2_shell_L-x1.stl
54.0 x 28.0 x 24.0
