Meckie-AI/meckie-bodies/bodies/rover-lite/stl/rover-lite-turntable-x1.stl

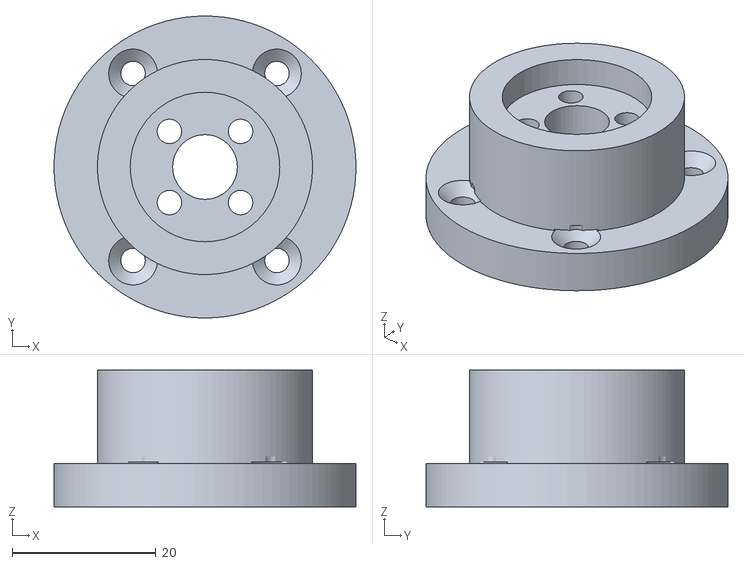
[picture p124: CAD file, 2026-10-04]
bodies/rover-lite/stl/rover-lite-turntable-x1.stl
42.0 x 42.0 x 19.0
