Meckie-AI/meckie-bodies/(list of files, cad)

Other CAD files:
bodies/lamp/stl/lamp-xiao_cradle-x1.stl
bodies/wobble/stl/wobble-esp_cradle-x1.stl
bodies/rover-lite/stl/rover-lite-esp_cradle-x1.stl
bodies/inchworm/stl/inchworm-face_bezel-x1.stl
bodies/wobble/stl/wobble-face_bezel-x1.stl
bodies/biped-mini/stl/biped-mini-foot_L-x1.stl
bodies/scout/stl/scout-xiao_bracket-x1.stl
bodies/wobble/stl/wobble-xiao_cradle-x1.stl
bodies/biped-mini/stl/biped-mini-ankle_bracket_L-x1.stl
bodies/scout/stl/scout-bumper_rear-x1.stl
bodies/biped-mini/stl/biped-mini-hip_bracket_R-x1.stl
bodies/inchworm/stl/inchworm-link3_shell_L-x1.stl
bodies/biped-mini/stl/biped-mini-thigh_R-x1.stl
bodies/comet/stl/comet-thigh_inner_R-x2.stl
bodies/inchworm/stl/inchworm-link4_shell_L-x1.stl
bodies/biped-mini/stl/biped-mini-shin_inner_R-x1.stl
bodies/biped-mini/stl/biped-mini-ankle_cap-x2.stl
bodies/biped-mini/stl/biped-mini-battery_cradle-x1.stl
bodies/biped-mini/stl/biped-mini-belt-x1.stl
bodies/biped-mini/stl/biped-mini-foot_strap-x2.stl
bodies/biped-mini/stl/biped-mini-head-x1.stl
bodies/biped-mini/stl/biped-mini-porthole-x1.stl
bodies/biped-mini/stl/biped-mini-roll_cap-x2.stl
bodies/biped-mini/stl/biped-mini-shin_outer_L-x1.stl
bodies/biped-mini/stl/biped-mini-shin_tie-x2.stl
bodies/biped-mini/stl/biped-mini-skid_shoe-x1.stl
bodies/biped-mini/stl/biped-mini-sole-x2.stl
bodies/biped-mini/stl/biped-mini-thigh_cap-x2.stl
bodies/biped-mini/stl/biped-mini-torso_lower-x1.stl
bodies/biped-mini/stl/biped-mini-torso_ring-x1.stl
bodies/biped-mini/stl/biped-mini-torso_upper-x1.stl
bodies/biped-mini/stl/biped-mini-tray-x1.stl
bodies/biped-mini/stl/biped-mini-tray_posts-x4.stl
bodies/comet/stl/comet-abd_cradle_B-x2.stl
bodies/comet/stl/comet-belly_hatch-x1.stl
bodies/comet/stl/comet-board_cradle_M-x2.stl
bodies/comet/stl/comet-board_cradle_S-x3.stl
bodies/comet/stl/comet-deck_front-x1.stl
bodies/comet/stl/comet-display_retainer-x1.stl
bodies/comet/stl/comet-face_mount-x1.stl
bodies/comet/stl/comet-foot_bumper-x4.stl
bodies/comet/stl/comet-hip_bracket_B-x2.stl
bodies/comet/stl/comet-knee_crank-x4.stl
bodies/comet/stl/comet-motor_strap-x4.stl
bodies/comet/stl/comet-pack_shell-x2.stl
bodies/comet/stl/comet-seam_band-x2.stl
bodies/comet/stl/comet-sensor_clamp-x6.stl
bodies/comet/stl/comet-shell_mid-x1.stl
bodies/comet/stl/comet-shell_tail-x1.stl
bodies/comet/stl/comet-shin_L-x2.stl
bodies/comet/stl/comet-sleeve_cap-x4.stl
bodies/comet/stl/comet-speaker_grille-x1.stl
bodies/comet/stl/comet-thigh_bridge-x4.stl
bodies/comet/stl/comet-thigh_outer_R-x2.stl
bodies/comet/stl/comet-wheel_hub-x4.stl
bodies/dial/stl/dial-base_pan-x1.stl
bodies/dial/stl/dial-camera_pod-x1.stl
bodies/dial/stl/dial-carry_handle-x1.stl
bodies/dial/stl/dial-chassis-x1.stl
bodies/dial/stl/dial-clamp_ring-x1.stl
bodies/dial/stl/dial-knob-x2.stl
bodies/dial/stl/dial-pan_sleeve-x1.stl
bodies/dial/stl/dial-rear_grommet-x1.stl
bodies/dial/stl/dial-strap-x1.stl
bodies/dial/stl/dial-swivel_tier-x1.stl
bodies/dial/stl/dial-tray-x1.stl
bodies/dial/stl/dial-turntable-x1.stl
bodies/inchworm/stl/inchworm-glow_ring-x1.stl
bodies/inchworm/stl/inchworm-head_frame-x1.stl
bodies/inchworm/stl/inchworm-head_rear-x1.stl
bodies/inchworm/stl/inchworm-j1_tower-x1.stl
bodies/inchworm/stl/inchworm-link1_cap-x1.stl
bodies/inchworm/stl/inchworm-link1_frame-x1.stl
bodies/inchworm/stl/inchworm-link1_shell_L-x1.stl
bodies/inchworm/stl/inchworm-link2_frame-x1.stl
bodies/inchworm/stl/inchworm-link2_shell_R-x1.stl
bodies/inchworm/stl/inchworm-link3_frame-x1.stl
bodies/inchworm/stl/inchworm-link4_frame-x1.stl
bodies/inchworm/stl/inchworm-proleg-x8.stl
bodies/inchworm/stl/inchworm-tpu_foot-x1.stl
bodies/inchworm/stl/inchworm-tray-x1.stl
bodies/lamp/stl/lamp-clamp_ring-x1.stl
bodies/lamp/stl/lamp-elbow_crank-x1.stl
bodies/lamp/stl/lamp-liner-x1.stl
bodies/lamp/stl/lamp-lower_rail_L-x1.stl
bodies/lamp/stl/lamp-lower_rail_R-x1.stl
bodies/lamp/stl/lamp-pod_cap-x2.stl
bodies/lamp/stl/lamp-tpu_foot-x1.stl
bodies/rover-lite/stl/rover-lite-camera_lamp-x1.stl
bodies/rover-lite/stl/rover-lite-clamp_ring-x1.stl
bodies/rover-lite/stl/rover-lite-drum_cap_left-x1.stl
bodies/rover-lite/stl/rover-lite-drum_tube-x1.stl
bodies/rover-lite/stl/rover-lite-motor_strap-x2.stl
bodies/rover-lite/stl/rover-lite-speaker_ring-x1.stl
bodies/rover-lite/stl/rover-lite-sprocket-x2.stl
bodies/rover-lite/stl/rover-lite-track-x2.stl
bodies/rover-lite/stl/rover-lite-track_frame-x2.stl
bodies/rover-lite/stl/rover-lite-tray_rear-x1.stl
bodies/scout/stl/scout-tail_ball-x1.stl
bodies/wobble/stl/wobble-imu_clamp-x1.stl
bodies/wobble/stl/wobble-motor_strap-x2.stl
bodies/wobble/stl/wobble-servo_bracket-x1.stl
bodies/wobble/stl/wobble-upper-x1.stl
