Meckie-AI/meckie-bodies/(commit log)

2026-10-04 Body pack bundle as received from the design handoff
    Unmodified contents of 'Meckie Perch Spec.zip' (despite the name, there is no
    Perch: the bundle is design_handoff_meckie_body_marketplace, seven body packs).
    Committed verbatim so every subsequent fix is a reviewable diff against the
    original handoff.
    [biped-mini-ankle_bracket_L-x1.stl, biped-mini-ankle_bracket_R-x1.stl, biped-mini-ankle_cap-x2.stl, biped-mini-arm-x2.stl, biped-mini-battery_cradle-x1.stl, biped-mini-belt-x1.stl, biped-mini-display_retainer-x1.stl, biped-mini-foot_L-x1.stl]
2026-10-04 Fix the YAML that made 5 of 7 templates unloadable
    Two defects blocked every consumer of these packs:
    1. 'writes: servos[].offset_deg' in the servo_center calibration step is
    invalid YAML, because the unquoted '[' opens a flow sequence. js-yaml
    rejected dial, rover-lite, biped-mini, lamp and inchworm outright.
    scout and wobble parsed only because they have no servos, and so no
    such step. Quoted the value.
    2. rover-lite declared 'limits:' at the same indent as the '- ' items
    under 'servos:', which YAML rejects outright. Every other body uses a
    top-level 'servo_limits:'. Renamed to match, in both the firmware file
    and the template's embedded copy, which stay byte-identic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
    [biped-mini.template.yaml, hangar_bay_rover_lite.yaml, inchworm.template.yaml, rover-lite.template.yaml]
2026-10-04 Define the hardware_sha256 canonical form and generate the embedded block
    The seven claimed hashes reproduced under nothing. I tried twelve
    canonicalisations - raw block, trimmed, trimmed plus newline, CRLF,
    whitespace-collapsed, JSON, key-sorted JSON, pretty JSON, yaml.dump,
    key-sorted yaml.dump, firmware file raw, firmware file trimmed - and none
    matched any pack. They were decorative, so the README's 'CI recomputes
    hardware_sha256 and fails on a mismatch' gate could never have passed.
    Canonical form, now written down in tools/lib/packs.js:
    hardware_sha256 = sha256(manifest text, LF endings, one trailing newline)
    On disk that is the bytes of firmware/<name>.yaml. Inside a template it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
    [biped-mini.template.yaml, inchworm.template.yaml, rover-lite.template.yaml, scout.template.yaml, wobble.template.yaml]
2026-10-04 One sensor schema across all seven packs, and fix two dead wizard steps
    The sensing rule - bodies that drive must declare a forward lidar plus
    drop-off front and rear - could not be enforced, because the packs disagreed
    on how to say it. All four driving bodies were physically compliant but only
    two passed the rule as written.
    rover-lite called its forward VL53L8CX 'tof_fwd', not 'lidar_fwd'
    scout called its drop sensors 'tof_front' / 'tof_rear'
    biped-mini had no role: key on any sensor
    wobble declares its IMU under balance:, not peripherals
    Normalised: a sensor carries role: obstacle | drop_off | imu | presence, and
    the forward obstacle sensor is lidar_fwd everywhere.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
    [biped-mini.template.yaml, hangar_bay_biped_mini.yaml, hangar_bay_inchworm.yaml, hangar_bay_rover_lite.yaml, hangar_bay_scout.yaml]
2026-10-04 Replace the invented build targets with ones that exist
    The handoff's targets: blocks named boards and firmware channels that appear
    nowhere: esp32s3_devkitc_n16r8, xiao_esp32s3_sense, rpi_zero_2w as board ids,
    and meckie-reflex@stable / meckie-reflex-lite@stable / meckie-head@stable /
    meckie-face@stable as firmware channels. There is no firmware channel concept
    in Meckie OS at all, and no Meckie-built Pi image.
    What is actually true, checked against the pinned toolchain:
    - Hangar Bay names PlatformIO envs by board ROLE and honours an explicit
    board when a pack gives one (firmware-gen.js:171-177). Its OTA endpoint
    accepts exactly 'head' and 'body' (routes.js:286).
    - espressif32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
    [biped-mini.template.yaml, inchworm.template.yaml, rover-lite.template.yaml, scout.template.yaml, wobble.template.yaml]
2026-10-04 Generate the JSON Meckie OS consumes, and name what it cannot
    The packs are authored as YAML that fuses two things Meckie OS keeps apart: a
    MANIFEST (what a body can do - the protocol line) and a BUILD spec (board,
    pins, topology - explicitly below that line, per droid MIGRATION.md:91-94).
    Rather than convert the packs to JSON and couple open hardware to Meckie OS
    internals, or teach Meckie OS a second manifest format, the YAML stays
    authored and tools/emit-json.js derives both JSON views.
    Verified on all seven: generated/manifest.json validates against the formal
    MANIFEST.schema.json (ajv, draft 2020-12) AND against Central's own semantic
    validator in lib/bodies/manifest.js, with zero igno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
2026-10-04 Clean 2,126 junk triangles, and gate the pack standard in CI
    MESH. The handoff said the STLs were "watertight, manifold-checked". Measured:
    204/204 are watertight with zero boundary edges, 204/204 are a single shell,
    204/204 fit the 256 mm bed, 204/204 are named -x<qty>. That part was true.
    Manifold was not. 46 files carried 2,126 zero-area triangles and 20 files had
    edges used by more than two triangles, so the README's own rule - "every edge
    shared by exactly two triangles" - failed on a fifth of the meshes.
    tools/meshclean.js removes the junk: all 2,126 zero-area triangles are gone
    and every mesh is still watertight. It found zero true duplicate triangles.
    That is worth knowing, because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
    [biped-mini-ankle_bracket_L-x1.stl, biped-mini-ankle_bracket_R-x1.stl, biped-mini-foot_L-x1.stl, biped-mini-foot_R-x1.stl, biped-mini-hip_bracket_L-x1.stl, biped-mini-hip_bracket_R-x1.stl, biped-mini-thigh_L-x1.stl, biped-mini-thigh_R-x1.stl]
2026-10-04 Prove the gates fire, and make the repo explain itself
    tools/selftest.sh breaks one rule at a time and asserts validate.js catches it,
    then restores from git. 26 cases: unparseable YAML, a tampered manifest, a
    template drifting from firmware/, safety_test made optional, resume relaxed off
    fresh_command_only, a drop sensor deleted, a drop sensor unwired from the edge
    reflex, a reflex pointing at an undeclared sensor, two signals on one GPIO,
    duplicate servo IDs, glue in a joint description, glue as a joint method, a
    fake domain in body.pack, an affiliate tag, a deleted supplier link, a catalog
    count drifting from the folder, a pack runtime diverging from shared/, stale
    generated JSON, a targe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
2026-10-04 Name the exact pin a generated build would get wrong
    Round-tripped every generated/build.json through the real generator in
    ~/repos/droid (read-only, resolveDisplay + wiring + render, no build). All
    seven are consumable: displays resolve, wiring comes back, firmware renders -
    single-board for dial, scout, rover-lite and biped-mini, multiboard for wobble,
    lamp and inchworm, matching which packs actually have two ESP32s.
    That round-trip turned up something a generic warning had been hiding. Where a
    pack states a display pin symbolically - "tied_low", "expander.p4" - it is not
    a number, so firmware-gen falls back to its own default. On a single-MCU body
    that default can land on a pin the body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
2026-10-04 rover-lite: declare the shared fault pin instead of pretending it is two
    rover-lite wired the DRV8833 nFAULT and the servo eFuse FLT to the same reflex
    GPIO 21 while its safety block listed drv_fault and efuse_fault as separate
    triggers. The manifest claimed a distinction the wiring cannot make.
    Separating them is not available. Its ESP32-S3 has exactly two unused GPIOs, 0
    and 45, and both are boot strapping pins. A pulled-up fault line on 45 selects
    1.8 V flash at boot; on 0 a latched fault at power-on drops the board into
    download mode instead of booting. Either choice fails worst precisely when a
    fault is already present, so the wire-OR was forced by the pin budget, not
    sloppiness - both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
    [hangar_bay_rover_lite.yaml, rover-lite.template.yaml]
2026-10-04 Fix 16 of the 20 non-manifold meshes, and run the generator in Node
    First, the diagnosis, because the fix follows from it. Every bad edge in all 20
    files was used by exactly four triangles - never three, never five. Tested
    against manifold-3d directly:
    face contact, exact 0 non-manifold edges
    vertex contact only 0
    coplanar patch, flush wall 0
    EDGE contact only, exact 1
    edge contact, overlapped 0.02 0
    So the cause is specific: two features meeting along a LINE instead of
    overlapping. Manifold emits that faithfully - two solids touching along a line
    genuinely cannot be a manifold solid there - and a small overlap removes it.
    Nothing was wrong with t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
    [dial-esp_cradle-x1.stl, inchworm-camera_hood-x1.stl, inchworm-face_bezel-x1.stl, inchworm-xiao_cradle-x1.stl, lamp-xiao_cradle-x1.stl, rover-lite-esp_cradle-x1.stl, rover-lite-porthole_bezel-x1.stl, scout-bumper_front-x1.stl]
2026-10-04 Attribute peripherals to the board that hosts them
    build.json was claiming peripherals that are not on an ESP32 at all. Hangar Bay
    generates PlatformIO ESP32 firmware, but on dial, rover-lite and biped-mini the
    display, mic, speaker AND camera are all wired to the Raspberry Pi, and on lamp
    the display and audio are too. Emitting their pins made the generator resolve
    Pi GPIO numbers as if they were ESP32 pins.
    That was not a harmless inaccuracy. Meckie OS's new pin audit compared a
    Pi-hosted display pin against an ESP32 default and reported a collision on GPIO
    25 for four different bodies - a collision across two separate GPIO spaces,
    which cannot happen. Exactly the mistake I made twice bef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
2026-10-04 README: state what the serial-bus branch does and does not cover
    The open-items list said serial-bus servos were unsupported and told people not
    to flash scout, wobble or inchworm. Both are now out of date in opposite
    directions: the Meckie OS branch feat/serial-bus-servos drives all five
    serial-bus bodies, and its pin audit refuses the three builds that used to
    resolve a display pin onto a motor pin instead of quietly producing them.
    Added the thing the list never said, which matters more than either: on dial,
    rover-lite and biped-mini the display, mic, speaker and camera are all on the
    Raspberry Pi. Generated firmware covers the reflex board only. Anyone reading
    'show_face' in the manifes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
2026-10-05 The marketplace, running locally
    Phase 2 of the handoff: catalog, body page, contribute. No framework and no
    build step, which is how meckie.ai is already served (marketing-server.js plus
    static HTML), so there is nothing to compile before you can look at it:
    npm run site -> http://localhost:4173
    Everything it serves is a real file in this repo. The catalog cards embed each
    pack's OWN three.js viewer at ?view=iso&embed=1 rather than a pre-rendered
    thumbnail, so the catalog cannot drift from the geometry - what you see is the
    same file a builder opens from the download.
    tools/site-data.js does the work a static page cannot: part names, materials
    and bed orientation come out of the P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
2026-10-05 Serve the same catalog standalone or mounted on meckie.ai
    The marketplace now has to work two ways: on its own (npm run site, at /) and
    mounted under /bodies on the marketing site. Rather than keep two copies of the
    HTML, every internal link goes through site/js/where.js, which works out the
    prefix once and builds URLs from it. The feed stays at /bodies.json and the
    template at /api/bodies/<slug>/template in BOTH mounts, so Hangar Bay's catalog
    URL is the same shape wherever the marketplace lives.
    Cross-reference, the other direction: the nav gains a Meckie OS link and the
    footer points at the OS and at plans. Mounted, those are same-origin. Standalone
    they default to the marketing site run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
2026-10-05 The catalog wears the site's header, and follows its theme
    Two asks, one cause: mounted on meckie.ai the catalog looked like a different
    site. It had its own bar instead of the shared nav, and it stayed cream while
    every other page went dark.
    HEADER. The pages now render the site's own nav - the same
    <nav id="meckie-nav" data-page="public"> every meckie.ai page uses, pulling
    theme.js and nav.js from the site. That brings the real links, the Get notified
    button, the theme toggle and the greeter along with it, because the shared nav
    is what carries them.
    Below it sits a second, non-sticky bar: where you are WITHIN the bodies
    section, and the only place the catalog names itself. Two sticky ba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
2026-10-05 Validation reads as a checklist for a body that is not finished yet
    Found by actually trying to add a body rather than by reading the code: drop a
    new slug into bodies.json with an empty folder and validate.js died on
    Error: ENOENT: no such file or directory, open '.../LICENSE.txt'
    at Object.readFileSync (node:fs:436:20)
    A validator that throws ENOENT is useless to the person it exists for. The
    first thing a new body does is NOT have some of these files, and a stack trace
    is not a checklist. Every pack file is now opened through a guarded read that
    reports a missing file as a finding next to all the others, so an unfinished
    pack produces the list of what is left to do.
    The same em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
2026-10-05 npm run new-body: start from a working pack, not from nothing
    Adding a body meant creating ten-odd files that have to agree with each other,
    and the first check on an empty folder was seventeen findings. Accurate, but a
    cold start, and the hardest file - the Print Parts geometry - is the one with
    no example in front of you.
    npm run new-body -- my-body "My Body" [--from scout]
    copies a working pack, renames every identifier it carries, rebuilds its STLs
    from its own generator, and adds the bodies.json entry. The result is a
    complete valid pack that already appears in the catalog, with exactly one
    failing check:
    my-body: still an unmodified copy of scout - its Print Parts geometry is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
2026-10-05 Say why PETG, in every brief and on the Contribute page
    The packs specified PETG throughout and never said why. PLA was not mentioned
    anywhere, not even to rule it out, which makes it the first unanswered question
    anyone with a printer has.
    Each brief gains a 06b 'Why these materials' section, and the Contribute page
    gains the same argument in general form. Every number is read from that body's
    own manifest and parts list, so no brief claims a limit its servos do not have.
    The decisive argument is thermal, and it is sharper than the usual one about
    sunny windows. Every body with serial servos sets temp_warn_c: 65 and
    temp_trip_c: 70. PLA's glass transition is about 55 to 60 C, which is BEL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
2026-10-05 Both ways to get the parts, with the numbers that decide between them
    Print your own if you can, have them made if you cannot. The Print tab now
    shows both, side by side, with what each actually costs.
    FIRST, A BUG I SHIPPED. tools/site-data.js parsed STL filenames with a
    non-greedy prefix, so a hyphenated slug mis-split:
    scout-deck-x1.stl -> "deck" ok
    rover-lite-esp_cradle-x1.stl -> "lite-esp_cradle" no match
    biped-mini-foot_L-x1.stl -> "mini-foot_L" no match
    rover-lite and biped-mini therefore had EMPTY parts arrays. Their Print tabs
    listed nothing on the live site, hiding 66 files between them, and nothing
    looked broken because the download-all zi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
2026-10-05 A bundle you can drop into a print service's quote page
    The estimate on the site is an industry band, not a price. This is the cheapest
    way to replace it with a real one: npm run quote-bundle -- <slug> writes a zip
    that any service's upload-and-quote page accepts. No API, no key, no partner
    conversation - every one of them has a quote page and none of them charge for
    using it.
    The zip carries the STLs foldered BY MATERIAL, because the first thing a quote
    page asks is what to print each part in, and answering it up front is the
    difference between a quote in ten minutes and a thread of emails. Plus the same
    information three ways, because every service wants it differently: a CSV to
    paste, a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
2026-10-05 Fix the blank Build tab: the runtime still loaded React from unpkg
    The Build tab was an empty cream rectangle on the mounted site. The brief had
    not failed to render - it had failed to BOOT. React never loaded:
    Loading the script 'https://unpkg.com/react@18.3.1/umd/react.production.min.js'
    violates the following Content Security Policy directive: script-src ... cdn.jsdelivr.net
    [dc] failed to load React or boot
    My earlier move from unpkg to jsdelivr rewrote bodies/*/*.html and
    reference/*.html and stopped there. These URLs are not in the HTML: they are
    inside support.js and three-d-stage.js, which the briefs and viewers load and
    which then fetch React, ReactDOM, Babel and three at ru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
2026-10-05 Switch the packs to PLA, with TPU only where flex is the function
    The packs specified PETG shells over CF-nylon structure, and nothing said why.
    The decisive argument turned out to be the wrong one: PETG against PLA is $4
    across the whole seven-body catalog, while CF-nylon alone is $64 of the $100.
    Cost was never the reason to prefer PETG, and it is not the reason to leave it.
    The reason to standardise on PLA is that a stock printer with no modifications
    can make every rigid part. CF-nylon needs a hardened nozzle and a dry box,
    which silently excluded most of the people this catalog is published for. A
    pack most people can only read is not open hardware in any useful sense.
    What changed, 8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
2026-10-05 Price made-to-order printing, and ask for a price instead of selling
    The catalog gave the files away, which only helps people who own a printer.
    This is the other path: we print the parts and post them.
    Priced in print-service.json, deliberately separate from rates.json. That file
    prices an outside bureau with automation and scale; this one prices one printer
    and a pair of hands. Averaging them would hide the finding that matters:
    body unpainted painted labour share of cost
    scout $114-116 $178-179 84%
    rover-lite $149-156 $231-238 63%
    Filament is $2 to $13 a body. Machine time is $0.30/h once the printer is
    bought. Labour is 63-84% of every line, an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
2026-10-05 Drop paint for metallic-filled PLA
    40 pieces across all seven bodies were chrome-painted, brass-painted or
    brushed-aluminium finished. Chrome was four coats - filler primer, gloss black,
    chrome-effect, gloss clear - with dry time between, and on the small bodies it
    was the single largest line in the price: Scout's four chrome parts added $64 to
    a $114 part set, taking labour to 90% of cost.
    Metallic-filled PLA replaces all of it. Named "PLA metallic silver" and "PLA
    metallic brass" rather than plain silver, because plain grey prints flat and
    somebody would buy the wrong spool.
    35 pcs PLA metallic silver (was chrome paint, brushed alu)
    5 pcs PLA metallic brass (was brass paint)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
2026-10-05 Bed is 220 mm, not 256
    The packs were authored against a 256 mm bed and nothing ever needed it. The
    largest part in the whole catalog is rover-lite's fender at 210 mm, so 220 was
    always the real requirement — and it is a far more inclusive claim, since 220
    is the common entry-level bed size (and the size of the printer these are now
    actually being printed on).
    mesh.js BED drives the validator's oversize gate, so this tightens CI rather
    than loosening it: 2543 checks still pass with 0 parts over the limit. Also
    updated in the places that state it to a human — seven briefs, contribute.html,
    CONTRIBUTING.md, HANDOFF.md, README.md, the body page header, and the quote
    bundle's build_volume_m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
2026-10-06 Open Graph cards, with an image built from the bodies themselves
    The catalog pages had no link preview at all: a pasted link showed a naked URL
    in every chat app. All three pages now carry og: and twitter: tags.
    The image is a screenshot of tools/og-card/card.html, which lays Scout, Dial,
    Rover Lite and Biped Mini out at 1200x630 using the packs' OWN three.js viewers
    in embed mode. The bodies in the card are therefore the real geometry rather
    than a drawing that can drift from it, and rebuilding after a design change is
    one command. Shot at deviceScaleFactor 2, so the file is 2400x1260.
    Two things the README records because both cost time to find:
    - `--disable-gpu` leaves headless Chrom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
2026-10-06 Load the site's analytics on the catalog pages
    The marketing site has loaded /js/analytics.js on every page since the split.
    The catalog was the one surface that never did, so none of its traffic reached
    GA4 (G-GLF9K90CK3) — which matters more now that the whole thing is shared by a
    private link and the only way to know whether anyone opens it is the numbers.
    Mounted only. A standalone checkout on localhost must not post hits to the real
    property, and the head script already knows which it is.
2026-10-06 COMET-12: an eighth body, and its deck printed in two pieces
    A quadruped that skate-walks on wheel feet. 41 files, 83 printed pieces, 12
    STS3215 plus 4 N20, ~$684 of electronics. Brought in from the design handoff
    and reconciled with everything this repo has changed since the original seven
    arrived.
    THE DECK. It was 250 x 86 mm against a 220 mm bed, and could not be rotated
    into fitting — at 45 degrees its bounding box is about 238 mm each way. It
    would have been the one part in the catalog nobody could print. It now splits
    on a stepped lap and bolts together with two M3s, no glue, like everything else
    here.
    The seam sits at x = -20 because that is the widest clear band on the plate:
    the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
    [comet-12-abd_cradle_A-x2.stl, comet-12-abd_cradle_B-x2.stl, comet-12-antenna-x1.stl, comet-12-battery_cradle-x1.stl, comet-12-belly_hatch-x1.stl, comet-12-board_cradle_L-x1.stl, comet-12-board_cradle_M-x2.stl, comet-12-board_cradle_S-x3.stl]
2026-10-06 COMET-12 viewers: pin three.js to jsdelivr, not unpkg
    The viewer and Print Parts pages failed with "three.js failed to load" and
    "Failed to fetch dynamically imported module:
    https://unpkg.com/three@0.184.0/build/three.module.js".
    The site's CSP allows cdn.jsdelivr.net and blocks unpkg. 14 references across
    the pack's two module pages — the importmaps and the dynamic imports for
    three, OrbitControls, the OBJ and GLTF exporters, three-mesh-bvh,
    three-bvh-csg and manifold-3d.
    THIS IS THE THIRD TIME. First the HTML importmaps across the original seven,
    then support.js and three-d-stage.js, now a new pack arriving with the old
    pins. The reason it keeps getting through is that it is invisible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
2026-10-06 Rename COMET-12 to Comet
    The slug, the display name, the pack folder, all three page filenames, the
    manifest, the Hangar Bay template and 41 STLs. 100 content replacements across
    13 files, applied longest-form-first so COMET-12 could not be half-rewritten
    into "Comet-12" by the slug rule.
    The stale site/data files are removed rather than renamed; they regenerate.
    Two things that were easy to miss and would have been quiet failures:
    - stl-drift.json and mesh-exceptions.json key on the STL PATH, so all 19
    recorded entries would have pointed at files that no longer exist. The
    drifts would have come back as fresh failures and the non-manifold meshes
    as new defects, both looking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
    [comet-abd_cradle_A-x2.stl, comet-abd_cradle_B-x2.stl, comet-antenna-x1.stl, comet-battery_cradle-x1.stl, comet-belly_hatch-x1.stl, comet-board_cradle_L-x1.stl, comet-board_cradle_M-x2.stl, comet-board_cradle_S-x3.stl]
2026-10-06 README: eight bodies, and what Comet brought with it
    The repo is about to be public, so the README is the first thing a stranger
    reads. The catalog table is regenerated from bodies.json rather than retyped,
    and the BOM figures move with it — they drifted when the per-body filament rows
    were recomputed for PLA.
    Counts brought current: 245 STLs, 8 manifests and templates, 8 non-manifold
    meshes, 26 drifts, and six of eight bodies on serial-bus servos rather than
    five of seven. Added that everything prints in PLA with TPU only where flex is
    the function, and that nothing is painted.
    Two new open items, both Comet's and both worth a stranger knowing before they
    slice anything: its chassis dec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
2026-10-06 "Streams to Central" meant nothing to anyone outside
    The catalog's first paragraph said a body "streams to Central for thinking",
    which assumes the reader already knows what Central is. It is the first sentence
    a stranger reads, and the repo is public now.
    Half a sentence fixes it: Central is the Meckie's brain, on your home server or
    in its private cloud. Both halves, because the marketing site says the brain
    "lives on your home server" while the paid plans add cloud thinking — picking
    one would have been tidier and wrong.
    Same fix on the GitHub README, which has the same opening line, and on a body
    page, where the calibration note mentions Central parking the body without ever
    having i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
2026-10-06 Catalog pages: declare the favicon
    None of the three declared one, so the browser fell back to /favicon.ico, which
    this site does not ship: it uses an SVG. Every marketing page already declares
    both the SVG icon and the apple-touch-icon; the catalog pages were written
    separately and never picked them up.
    Root-relative, so they resolve when mounted on meckie.ai. A standalone checkout
    gets a 404 on them, which is the same trade the OG image already makes and
    costs nothing but a missing icon in dev.
